hmcneill46/house-rules-led-recreation/hardware/quotes/jlcpcb/discount-research.md

# JLCPCB discount checks — 29 October 2026

Research for the unchanged A1 main and USB carrier boards, UK delivery. No purchase or account registration was made. Dollar amounts below are USD promotion face values, not a delivered GBP quote.

**Later authenticated check:** the installed official JLCONE app offered a **$30 High-Layer PCB coupon which expressly includes six layers**, with shipping over $5 and order over $5. It was claimed (expires 27 December 2026), and the unchanged two-each cart explicitly estimated **−$30**. This supersedes the $20 search-indexed candidate below. Prepaid-tax checkout was $304.58 before discounts; final coupon/tax application lies after Submit Order, so no order was submitted. See `jlcone-comparison.md` for exact conditions, evidence and VAT handling. The random app discount is still unconfirmed.

## Best candidates to compare in the actual checkout

| Candidate | Published terms / limitations | Verification status |
| --- | --- | --- |
| Six-layer PCB special | Official cross-brand coupon centre lists $20 off six-layer fabrication, order above $5 excluding freight, 60-day validity, selected countries. | Worth checking on the main board. Actual account, UK region, selected services and availability remain unverified. |
| JLCONE desktop price and instant discount | Official Windows/macOS app offers desktop prices and shipping routes plus a limited-time random $1–$20 discount per order. Announcement expressly permits that automatic discount together with **one** eligible coupon. | Strongest additional comparison to make. Exact board options, small-via charges, assembly, shipping and VAT must stay identical. No exact saving promised. |
| Monthly SMT coupons | $9 and $6 assembly coupons, each for orders above $1 excluding shipping. | Issued monthly; account availability and final-cart eligibility need checking. |
| New-customer coupons | Relevant parts of the advertised $123 mixed-service pack: $10 SMT (order above $2), $6 PCB (above $2), and $10 shipping (shipping above $15). | Only for an eligible genuine new customer; the whole $123 is not a discount on these boards. |

Sources: [official coupon centre](https://jlcpcb.com/coupon-center), [official JLCMC centre search-indexed offer](https://jlcmc.com/coupon-center), [JLCONE app FAQ, updated 22 September 2026](https://jlcpcb.com/help/article/jlcone-desktop-app), [JLCONE announcement and explicit stacking rule](https://jlcpcb.com/news/jlcpcb-jlcone-desktop-app), [new-customer and monthly coupon guide, updated 9 September 2026](https://jlcpcb.com/help/article/new-customer-coupons).

The extra monthly $10 PCBA coupon requires EasyEDA-exported files. These boards use KiCad, so it should not be included. “Free assembly” advertising refers to using an SMT coupon against setup; components, fabrication, shipping and tax remain chargeable. [Assembly promotion explanation](https://jlcpcb.com/news/free-assembly-1-6-layer-pcb-discount-8-20-layer-pcba).

## How to establish the cheapest genuine total

Use one frozen manufacturing specification for both websites/app and all quantity comparisons. Compare the final **delivered and taxed amount**, after selecting one actually eligible coupon. Check whether the main and carrier can share shipping without losing a larger discount. A second shipment to use another coupon only saves money if its full extra freight/tax is smaller than the saving. Do not assume two board jobs permit two coupons in one payment batch.

JLCPCB says coupons are service-specific and normally limited to **one coupon per order batch**. Eligibility appears after shipping information at checkout; multiple coupons cannot be added together. The documented JLCONE automatic instant discount is the relevant exception to ordinary coupon stacking. [Coupon-use rules](https://jlcpcb.com/help/article/how-do-i-use-a-coupon-for-my-order).

## YouTube/creator-code result

No current creator redemption code giving a verified better discount than the official account offers was established. Creator sponsorships commonly link to the same welcome bundle or six-layer promotion rather than provide an additional code. For example, [GreatScott!'s 19 May 2024 sponsored video](https://www.youtube.com/watch?v=gE_FuQuaKc0) advertises six-layer pricing and a coupon, but it does not establish present eligibility for this order. The [official six-layer landing page](https://jlcpcb.com/events/6-layer-pcb) is live; its public text does not establish a currently redeemable $30 coupon.

Searches also found aggregator strings such as `JLCPCB9Sky` and `JLCPCB2Sky`, but no first-party current validation. They are **not counted as savings**. A code is only confirmed when JLCPCB accepts it for this actual cart. Do not make duplicate accounts or submit false eligibility information.

## Expired/restricted offers excluded

- [SMT Star Member first-order campaign](https://jlcpcb.com/events/pcba-first-order): ended **30 August 2026**; no current saving counted.
- [Engineers' Day promotion](https://jlcpcb.com/news/celebrate-engineers-day): article concerns the **2024** event.
- [Black Friday page](https://jlcpcb.com/sales-promotion): **2025** page, not evidence of a 2026 entitlement.
- [Maker Faire Rome 2026](https://jlcpcb.com/events/rome-maker-fair): `MFR26-EE`, $30 off orders of at least $70, requires possession of the event PCB gadget. No evidence the user qualifies, so excluded.

## Why the main board can exceed the advertised six-layer headline price

The frozen main board uses 0.20 mm drill / 0.40 mm copper-diameter vias. JLCPCB's live quote help identifies that exact combination as chargeable small vias. The free multilayer 0.20 mm option needs at least 0.45 mm copper diameter. Free VIPPO does not imply the small-via surcharge disappears. A 0.30 mm drill inside the existing 0.40 mm copper would reduce the annular ring and is a design change, not a valid quoting shortcut. [Official quote specification help](https://cart.jlcpcb.com/quote/?fromDemo=yes).

Use the exact fabrication/assembly result from the quoting task to determine the actual 1-each and 3-each minimum payable totals. The public promotions alone cannot provide those totals.
