hmcneill46/house-rules-led-recreation/hardware/manufacturing/A1_review/main/reports/drill-report.txt

Drill report for house-rules-main.kicad_pcb
Created on 2026-10-29T14:06:45

Copper Layer Stackup:
    =============================================================
    L1 :  F.Cu                      front
    L2 :  In1.Cu                    in1
    L3 :  In2.Cu                    in2
    L4 :  In3.Cu                    in3
    L5 :  In4.Cu                    in4
    L6 :  B.Cu                      back

Drill file 'house-rules-main-PTH.drl' contains
    plated through holes:
    =============================================================
    T1  0.200mm  0.0079"  (192 holes))
    T2  0.900mm  0.0354"  (84 holes))

    Total plated holes count 276

Drill file 'house-rules-main-NPTH.drl' contains
    unplated through holes:
    =============================================================

    Total unplated holes count 0
