hmcneill46/house-rules-led-recreation/hardware/manufacturing/A1_review/usb/reports/drill-report.txt

Drill report for house-rules-usb.kicad_pcb
Created on 2026-10-29T14:06:54

Copper Layer Stackup:
    =============================================================
    L1 :  F.Cu                      front
    L2 :  In1.Cu                    in1
    L3 :  In2.Cu                    in2
    L4 :  B.Cu                      back

Drill file 'house-rules-usb-PTH.drl' contains
    plated through holes:
    =============================================================
    T1  0.200mm  0.0079"  (10 holes))
    T2  0.600mm  0.0236"  (4 holes)  (with 4 slots)

    Total plated holes count 14

Drill file 'house-rules-usb-NPTH.drl' contains
    unplated through holes:
    =============================================================
    T1  0.650mm  0.0256"  (2 holes))

    Total unplated holes count 2
