hmcneill46/house-rules-led-recreation/hardware/revisions/B2/manufacturing/B2_F_TLC59283_7p15k_review_2026-10-31/reports/native-drill-report.txt

Drill report for house-rules-main-B2.kicad_pcb
Created on 2026-10-31T23:30:06

Copper Layer Stackup:
    =============================================================
    L1 :  F.Cu                      front
    L2 :  In1.Cu                    in1
    L3 :  In2.Cu                    in2
    L4 :  In3.Cu                    in3
    L5 :  In4.Cu                    in4
    L6 :  B.Cu                      back

Drill file 'house-rules-main-B2-PTH.drl' contains
    plated through holes:
    =============================================================
    T1  0.300mm  0.0118"  (276 holes))
    T2  0.900mm  0.0354"  (84 holes))

    Total plated holes count 360

Drill file 'house-rules-main-B2-NPTH.drl' contains
    unplated through holes:
    =============================================================

    Total unplated holes count 0
