hmcneill46/house-rules-led-recreation/hardware/quotes/2026-10-29/evidence/five-each-ddp-summary.txt

2. Shipping Method
CPT (Carriage paid to a named destination. Duty, tax, and the carrier’s clearance handling fee collected before or at the time of delivery at the destination.)
DHL Express
2-4 business days
Details >

UPS Worldwide Express Saver
2-5 business days
Details >

FedEx Express
3-5 business days
Details >

Global Standard Direct Line
8-12 business days
Details >

DDP (Customs fee paid by JLC, customers still need to cooperate with customs clearance if required by local customs)
DHL Express (DDP)
2-4 business days

FCA (Freight, customs clearance, taxes and duties are buyer's responsibility)
Use My own Freight Account

3. Submit Order

SUMMARY
4 items >
Merchandise Total
$258.80
Shipping Estimate
$25.66
Customs duties & taxes
$56.90
Duty & Tax Disbursement Fee
$8.27
Discount
--

Apply coupons in the payment section

Grand Total
$349.63
Continue

Need some help? Explore our help pages or contact us

© 2026 JLCPCB.COM All Rights Reserved. Privacy Policy Terms & Conditions
