hmcneill46/house-rules-led-recreation/hardware/design/module-connections.csv

module | module_pin | polarity | visual_axis_index_1based | driver | driver_signal | driver_package_pin
1 | 1 | anode | 1 | 1 | SW1 | 22
1 | 3 | anode | 2 | 1 | SW2 | 21
1 | 10 | anode | 3 | 1 | SW3 | 20
1 | 7 | anode | 4 | 1 | SW4 | 19
1 | 8 | anode | 5 | 1 | SW5 | 18
1 | 12 | cathode | 1 | 1 | CS1 | 30
1 | 11 | cathode | 2 | 1 | CS2 | 31
1 | 2 | cathode | 3 | 1 | CS3 | 32
1 | 9 | cathode | 4 | 1 | CS4 | 1
1 | 4 | cathode | 5 | 1 | CS5 | 2
1 | 5 | cathode | 6 | 1 | CS6 | 3
1 | 6 | cathode | 7 | 1 | CS7 | 4
2 | 1 | anode | 1 | 1 | SW1 | 22
2 | 3 | anode | 2 | 1 | SW2 | 21
2 | 10 | anode | 3 | 1 | SW3 | 20
2 | 7 | anode | 4 | 1 | SW4 | 19
2 | 8 | anode | 5 | 1 | SW5 | 18
2 | 12 | cathode | 1 | 1 | CS8 | 5
2 | 11 | cathode | 2 | 1 | CS9 | 6
2 | 2 | cathode | 3 | 1 | CS10 | 7
2 | 9 | cathode | 4 | 1 | CS11 | 8
2 | 4 | cathode | 5 | 1 | CS12 | 10
2 | 5 | cathode | 6 | 1 | CS13 | 11
2 | 6 | cathode | 7 | 1 | CS14 | 12
3 | 1 | anode | 1 | 2 | SW1 | 22
3 | 3 | anode | 2 | 2 | SW2 | 21
3 | 10 | anode | 3 | 2 | SW3 | 20
3 | 7 | anode | 4 | 2 | SW4 | 19
3 | 8 | anode | 5 | 2 | SW5 | 18
3 | 12 | cathode | 1 | 2 | CS1 | 30
3 | 11 | cathode | 2 | 2 | CS2 | 31
3 | 2 | cathode | 3 | 2 | CS3 | 32
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
