hmcneill46/house-rules-led-recreation/hardware/design/pixel-map.csv

x_0based | y_0based | module_1based | driver_1based | i2c_7bit_address | SW_1based | CS_1based | PWM_register
0 | 0 | 1 | 1 | 0x34 | 1 | 1 | 0x01
0 | 1 | 1 | 1 | 0x34 | 1 | 2 | 0x02
0 | 2 | 1 | 1 | 0x34 | 1 | 3 | 0x03
0 | 3 | 1 | 1 | 0x34 | 1 | 4 | 0x04
0 | 4 | 1 | 1 | 0x34 | 1 | 5 | 0x05
0 | 5 | 1 | 1 | 0x34 | 1 | 6 | 0x06
0 | 6 | 1 | 1 | 0x34 | 1 | 7 | 0x07
1 | 0 | 1 | 1 | 0x34 | 2 | 1 | 0x11
1 | 1 | 1 | 1 | 0x34 | 2 | 2 | 0x12
1 | 2 | 1 | 1 | 0x34 | 2 | 3 | 0x13
1 | 3 | 1 | 1 | 0x34 | 2 | 4 | 0x14
1 | 4 | 1 | 1 | 0x34 | 2 | 5 | 0x15
1 | 5 | 1 | 1 | 0x34 | 2 | 6 | 0x16
1 | 6 | 1 | 1 | 0x34 | 2 | 7 | 0x17
2 | 0 | 1 | 1 | 0x34 | 3 | 1 | 0x21
2 | 1 | 1 | 1 | 0x34 | 3 | 2 | 0x22
2 | 2 | 1 | 1 | 0x34 | 3 | 3 | 0x23
2 | 3 | 1 | 1 | 0x34 | 3 | 4 | 0x24
2 | 4 | 1 | 1 | 0x34 | 3 | 5 | 0x25
2 | 5 | 1 | 1 | 0x34 | 3 | 6 | 0x26
2 | 6 | 1 | 1 | 0x34 | 3 | 7 | 0x27
3 | 0 | 1 | 1 | 0x34 | 4 | 1 | 0x31
3 | 1 | 1 | 1 | 0x34 | 4 | 2 | 0x32
3 | 2 | 1 | 1 | 0x34 | 4 | 3 | 0x33
3 | 3 | 1 | 1 | 0x34 | 4 | 4 | 0x34
3 | 4 | 1 | 1 | 0x34 | 4 | 5 | 0x35
3 | 5 | 1 | 1 | 0x34 | 4 | 6 | 0x36
3 | 6 | 1 | 1 | 0x34 | 4 | 7 | 0x37
4 | 0 | 1 | 1 | 0x34 | 5 | 1 | 0x41
4 | 1 | 1 | 1 | 0x34 | 5 | 2 | 0x42
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
