hmcneill46/house-rules-led-recreation/hardware/revisions/B2/mechanical/archive-12p700-2026-10-29/README.md

# Historical 12.700 mm case geometry

These source and STL snapshots preserve the original B2 case before the owner selected the 12.875 mm F fitting trial on 31 October 2026. They are reference artifacts; use the current mechanical source and the new confirmed-F print pack for the revised 89.450 mm PCB. The old sliced print pack also remains unchanged in `../../printing/`.
