hmcneill46/house-rules-led-recreation/hardware/design/physical-concept.png

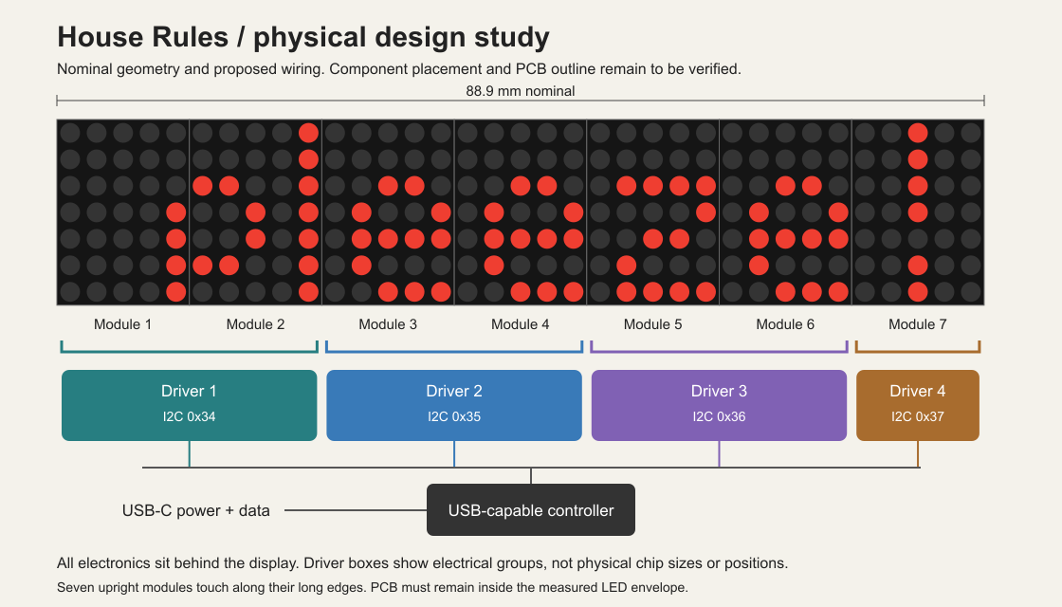
hardware/design/physical-concept.png
