hmcneill46/house-rules-led-recreation/hardware/quotes/2026-10-29/evidence/five-each-ddp-summary.jpg

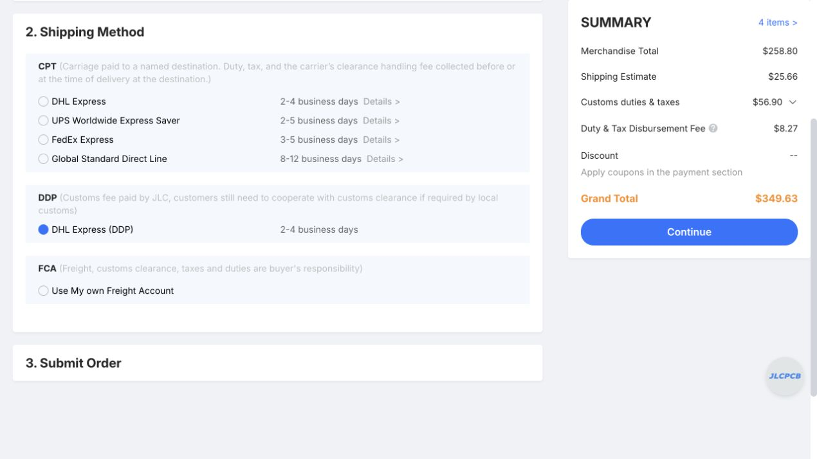
hardware/quotes/2026-10-29/evidence/five-each-ddp-summary.jpg
