hmcneill46/house-rules-led-recreation/hardware/quotes/2026-10-29/evidence/main-2-only-global-summary.jpg

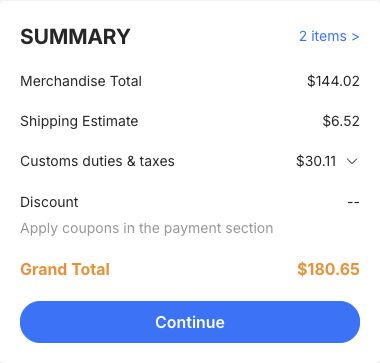
hardware/quotes/2026-10-29/evidence/main-2-only-global-summary.jpg
