hmcneill46/house-rules-led-recreation/hardware/quotes/2026-10-29/evidence/main-economic-2-cart.jpg

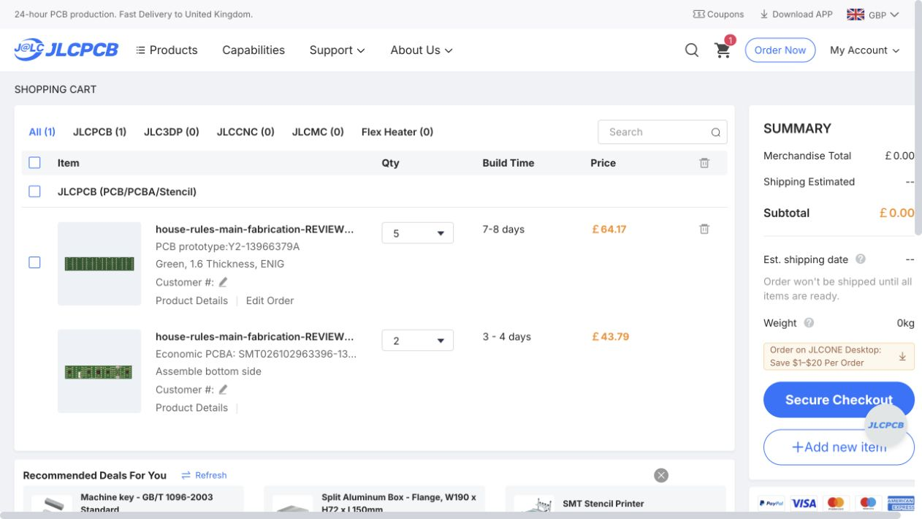
hardware/quotes/2026-10-29/evidence/main-economic-2-cart.jpg
