hmcneill46/house-rules-led-recreation/hardware/quotes/2026-10-29/evidence/usb-060-stock.jpg

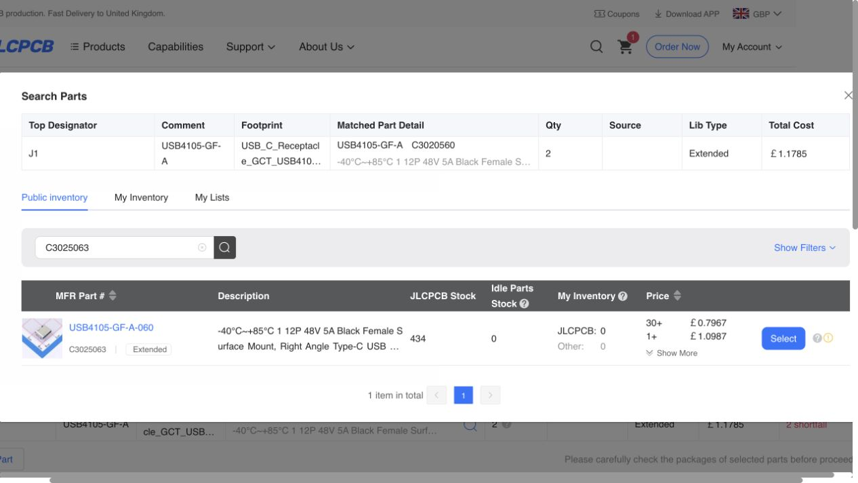
hardware/quotes/2026-10-29/evidence/usb-060-stock.jpg
