hmcneill46/house-rules-led-recreation/hardware/quotes/2026-10-29/evidence/usb-economic-5-120.jpg

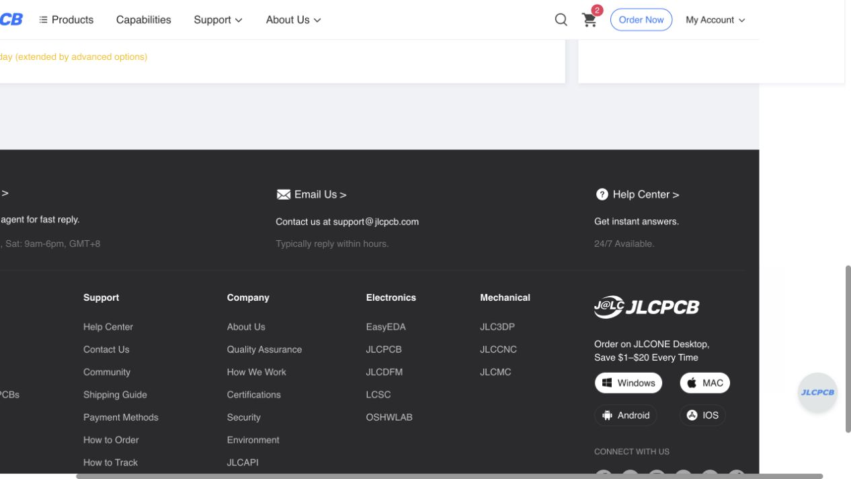
hardware/quotes/2026-10-29/evidence/usb-economic-5-120.jpg
