hmcneill46/house-rules-led-recreation/hardware/quotes/jlcpcb/jlcone-2-each-cart-coupon30-2026-10-29.png

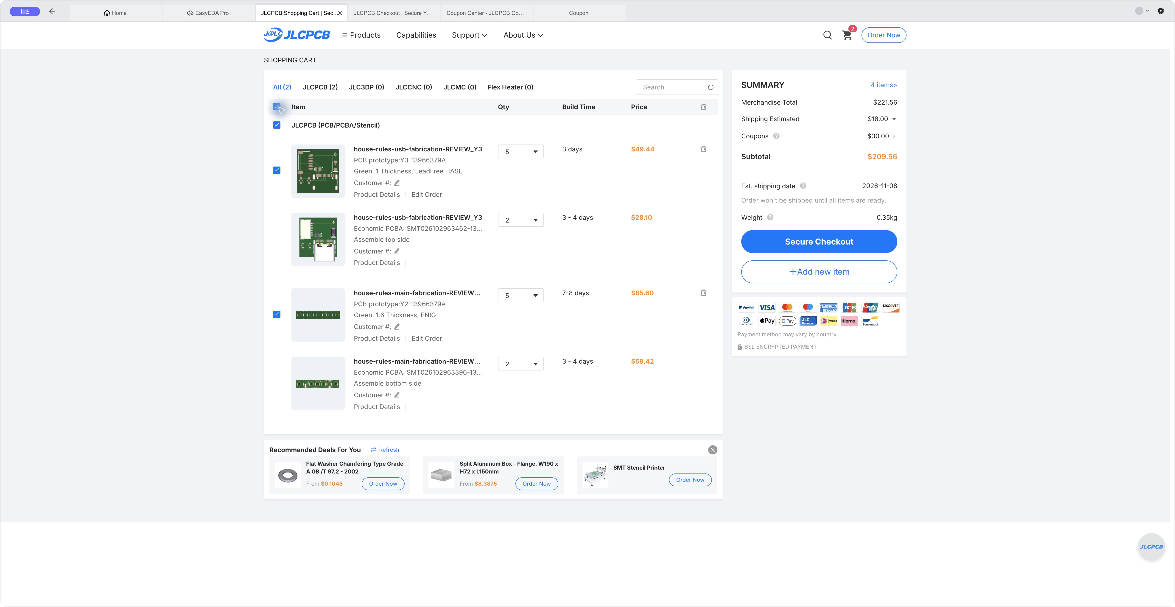
hardware/quotes/jlcpcb/jlcone-2-each-cart-coupon30-2026-10-29.png
