hmcneill46/house-rules-led-recreation/hardware/quotes/jlcpcb/jlcone-5-each-ddp-summary-2026-10-29.png

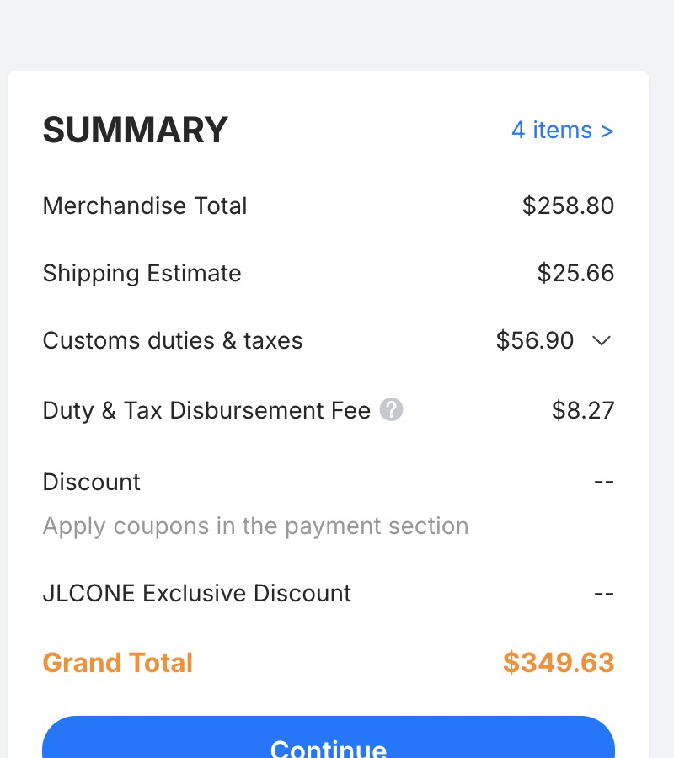
hardware/quotes/jlcpcb/jlcone-5-each-ddp-summary-2026-10-29.png
