hmcneill46/house-rules-led-recreation/hardware/quotes/jlcpcb/jlcone-coupon-wallet-2026-10-29.png

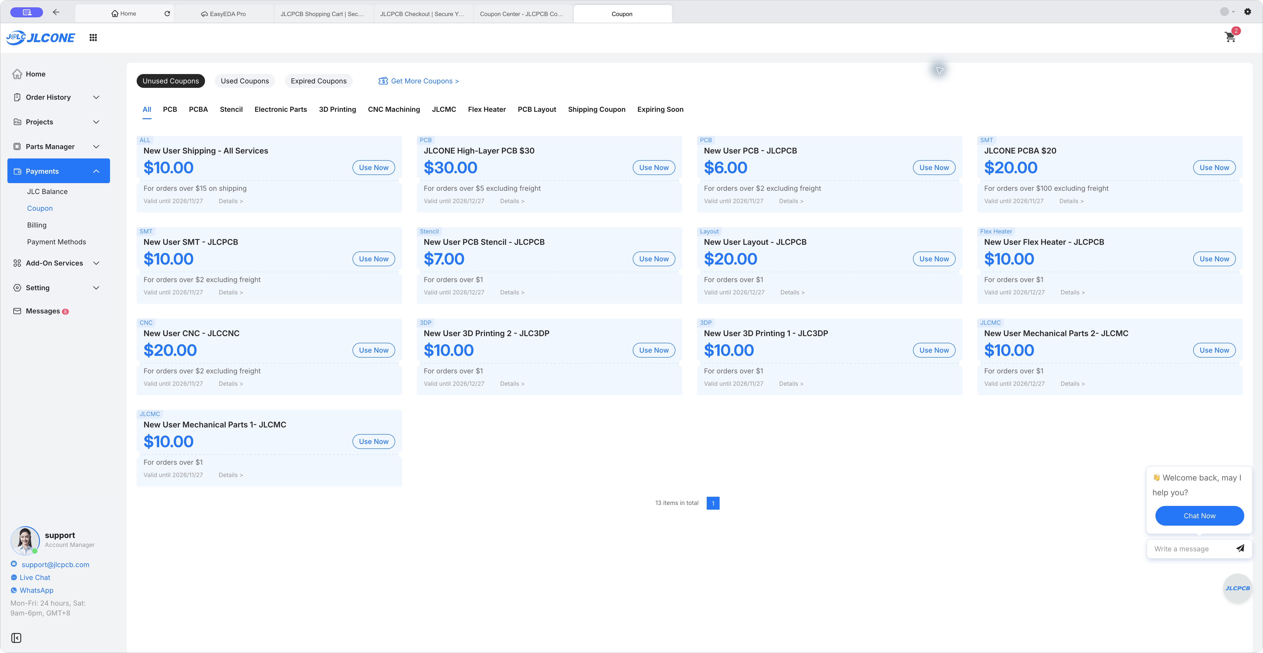
hardware/quotes/jlcpcb/jlcone-coupon-wallet-2026-10-29.png
