hmcneill46/house-rules-led-recreation/hardware/render/design-summary-preview.png

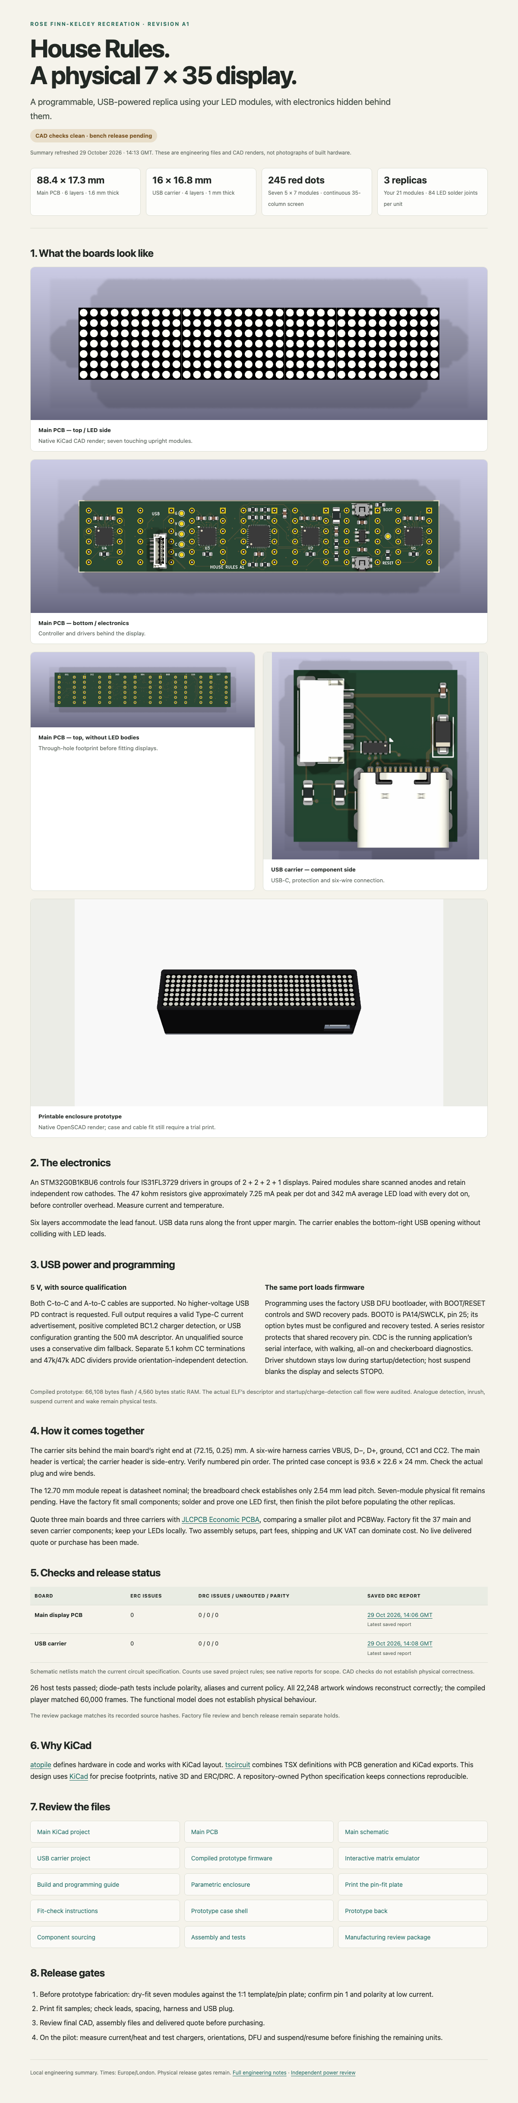
hardware/render/design-summary-preview.png
