hmcneill46/house-rules-led-recreation/hardware/render/drill-maps/main-pth.png

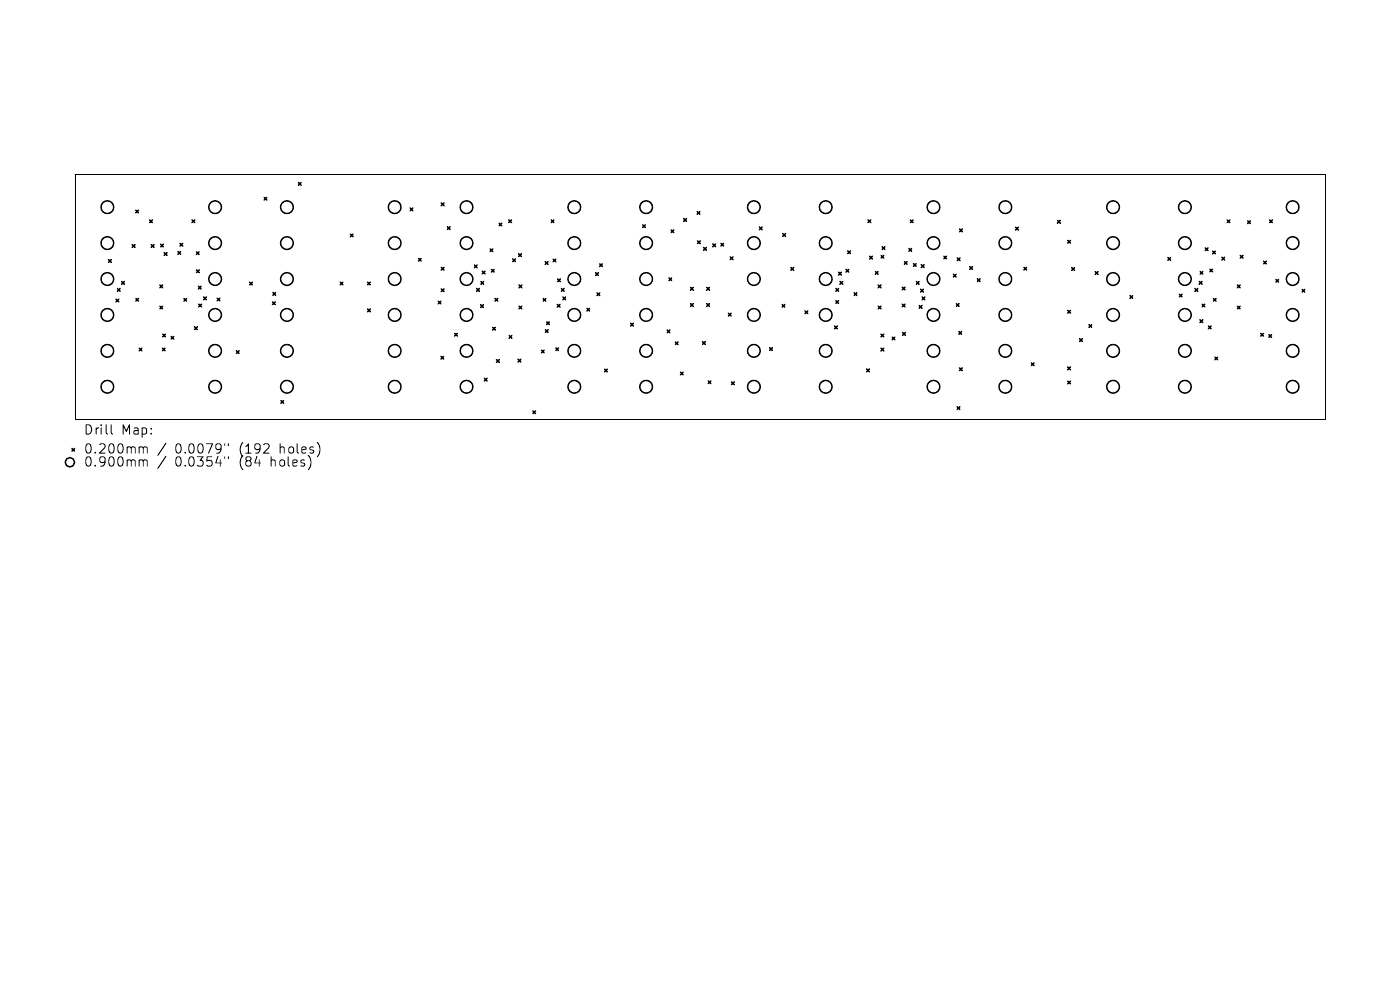
hardware/render/drill-maps/main-pth.png
