hmcneill46/house-rules-led-recreation/hardware/render/drill-maps/usb-pth.png

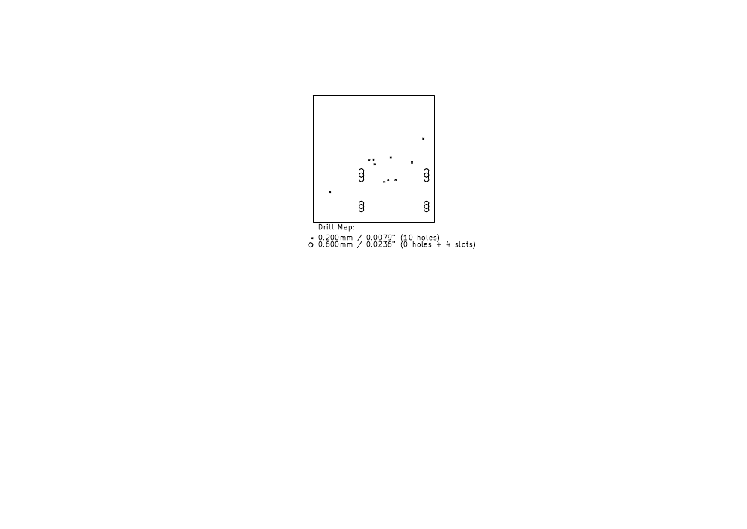
hardware/render/drill-maps/usb-pth.png
