hmcneill46/house-rules-led-recreation/hardware/render/enclosure-PROTOTYPE-back.png

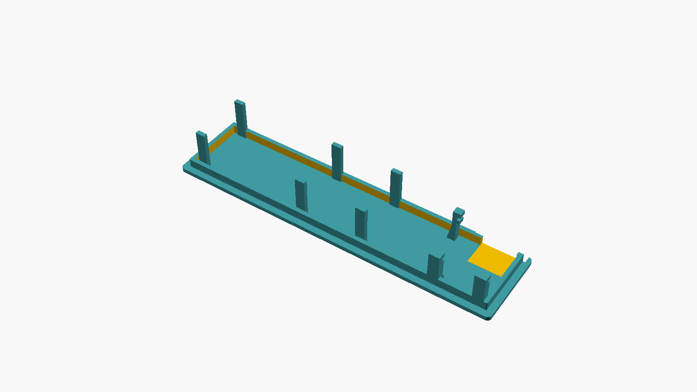
hardware/render/enclosure-PROTOTYPE-back.png
