hmcneill46/house-rules-led-recreation/hardware/render/main-edge.png

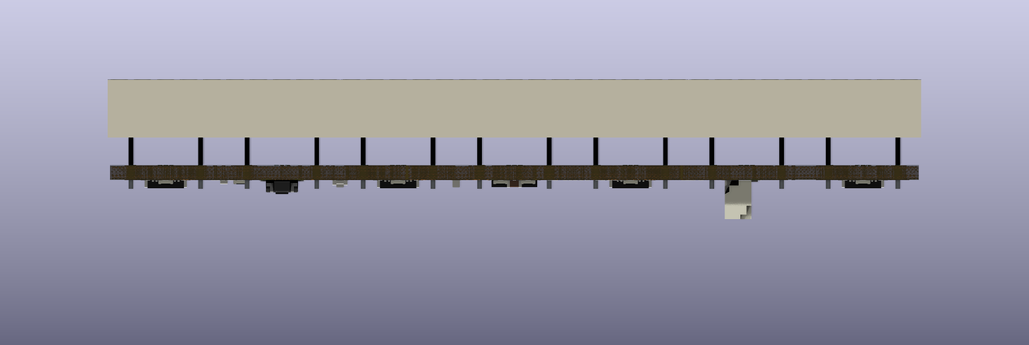
hardware/render/main-edge.png
