hmcneill46/house-rules-led-recreation/hardware/render/main-placement-bottom.png

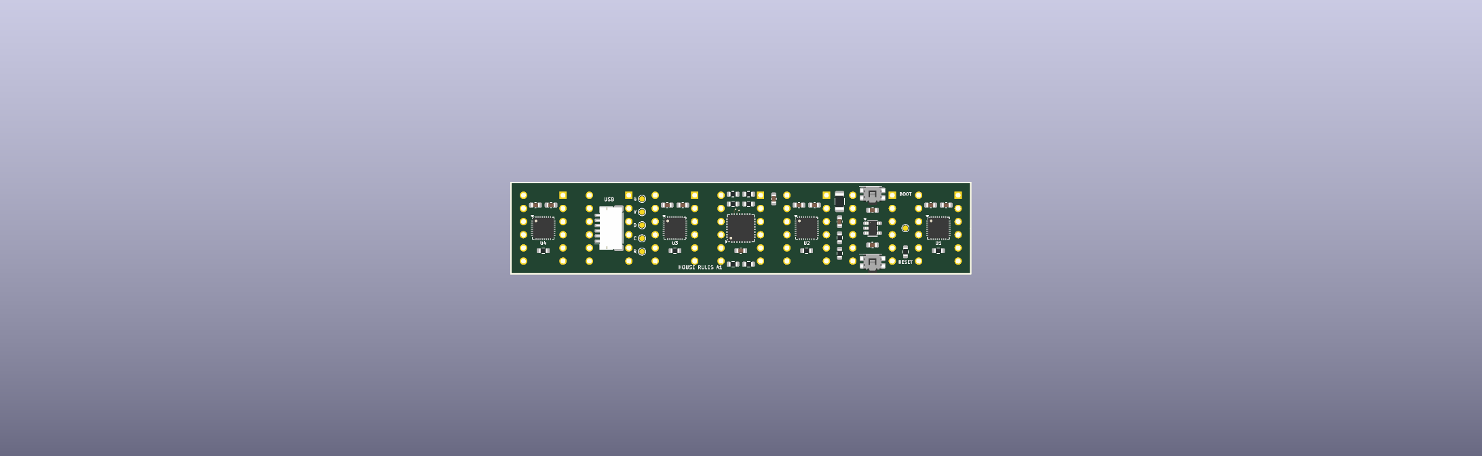
hardware/render/main-placement-bottom.png
