hmcneill46/house-rules-led-recreation/hardware/render/main-review-top.png

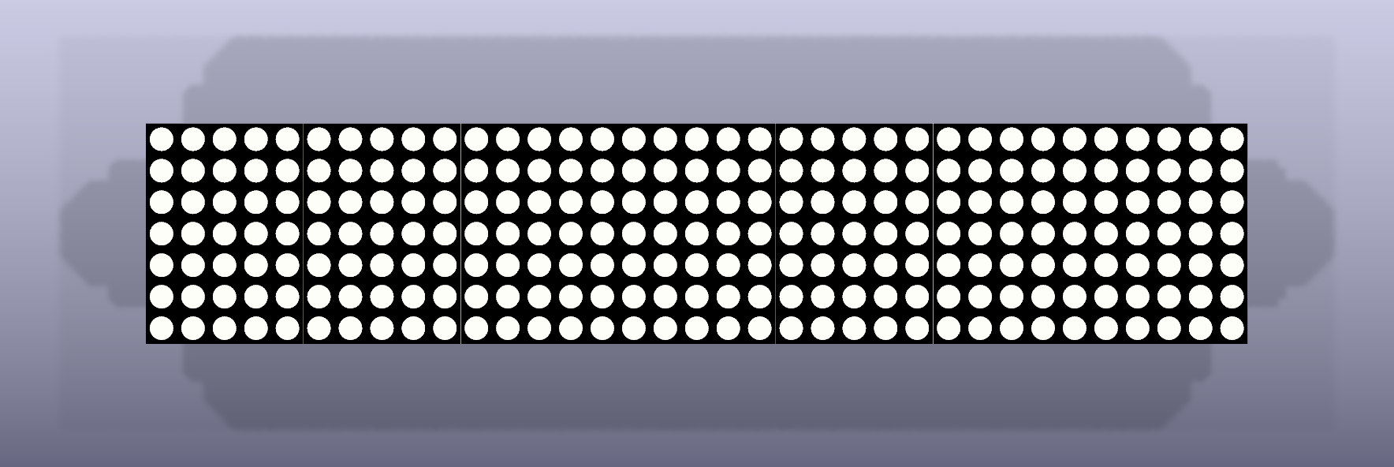
hardware/render/main-review-top.png
