hmcneill46/house-rules-led-recreation/hardware/render/usb-bottom.png

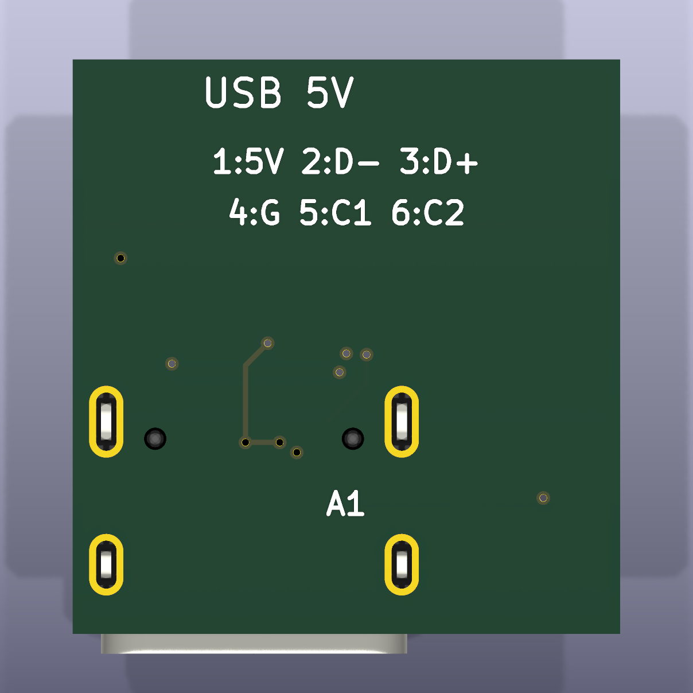
hardware/render/usb-bottom.png
