hmcneill46/house-rules-led-recreation/hardware/render/usb-isometric.png

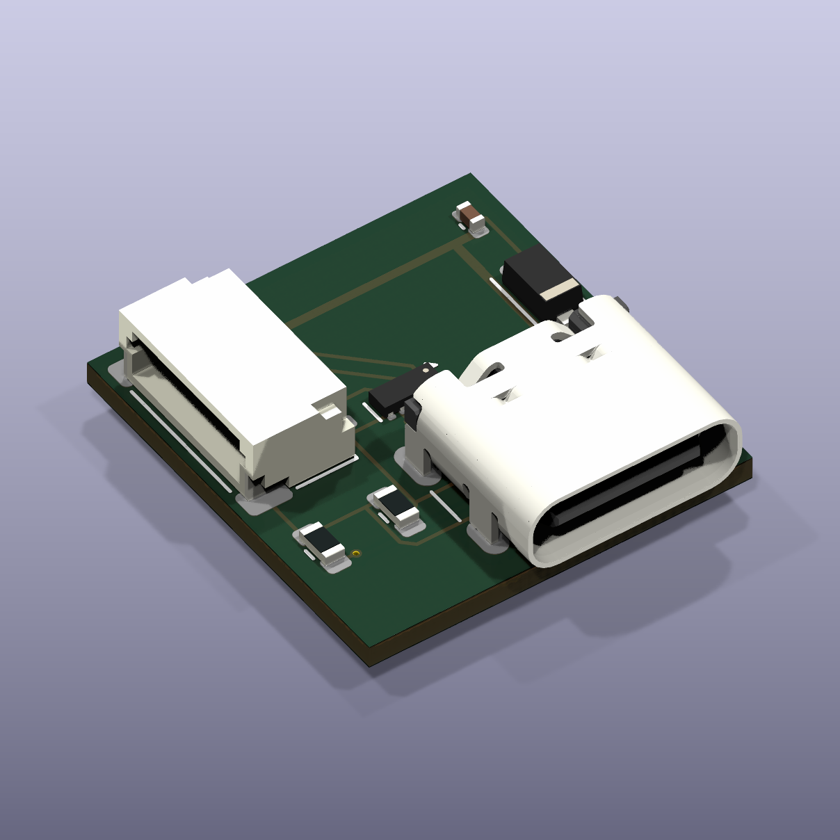
hardware/render/usb-isometric.png
