hmcneill46/house-rules-led-recreation/hardware/render/usb-placement-top.png

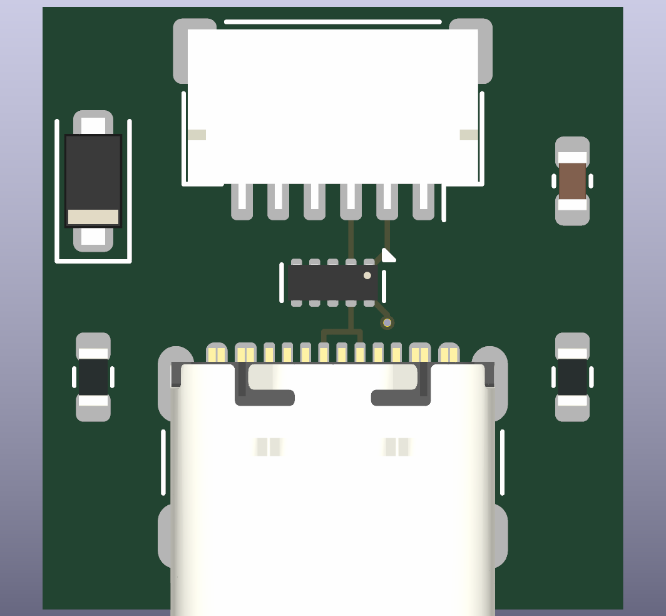
hardware/render/usb-placement-top.png
