hmcneill46/house-rules-led-recreation/hardware/revisions/B2/mechanical/render/section.png

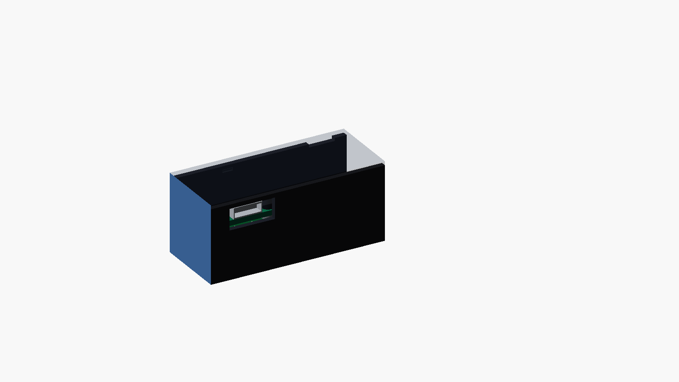
hardware/revisions/B2/mechanical/render/section.png
