hmcneill46/house-rules-led-recreation/hardware/simulation/emulator-preview.png

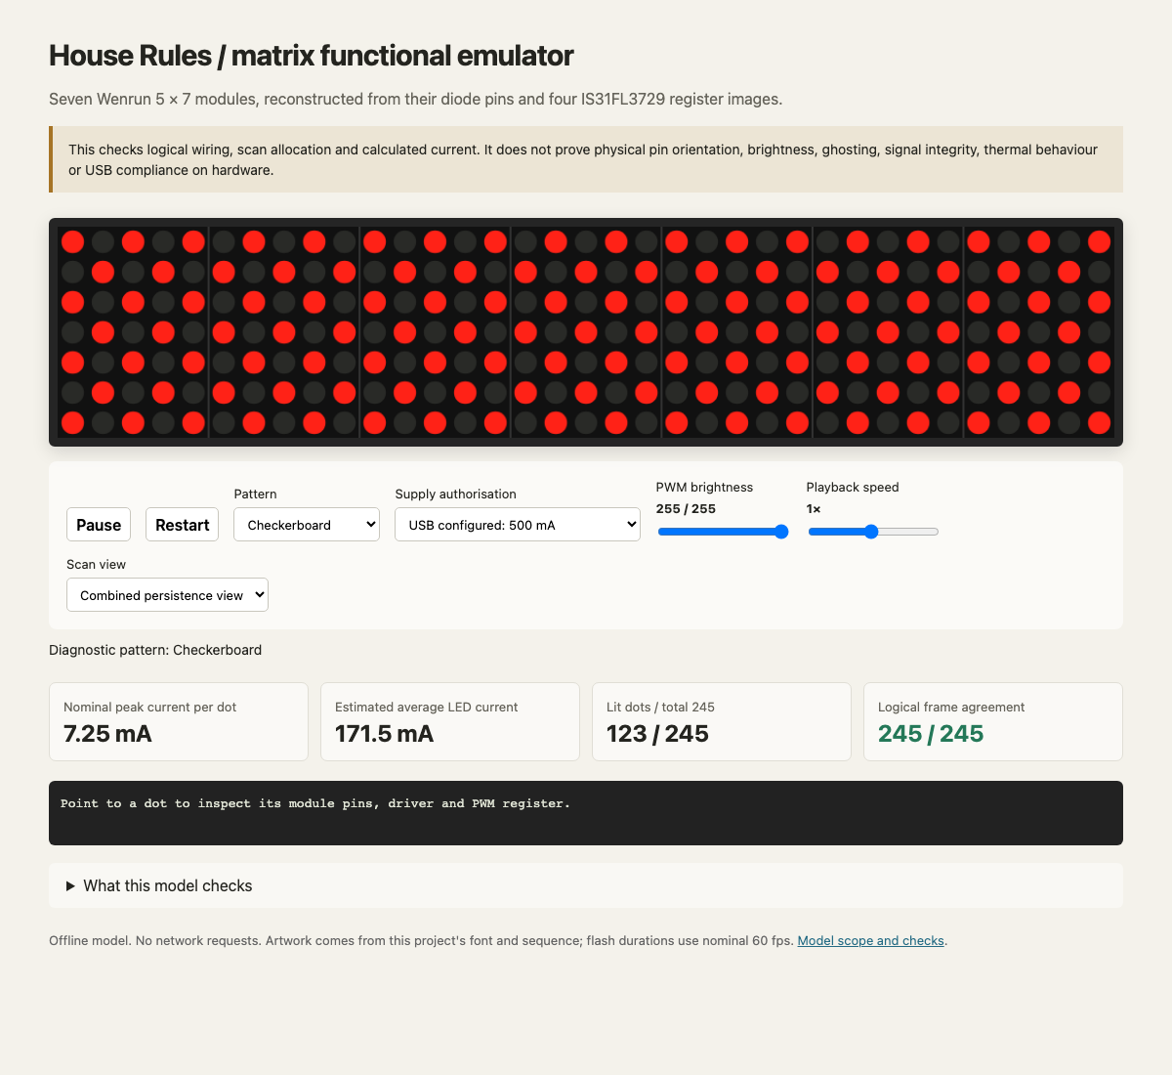
hardware/simulation/emulator-preview.png
