hmcneill46/house-rules-led-recreation/Original Artwork/2002.017.P.jpg

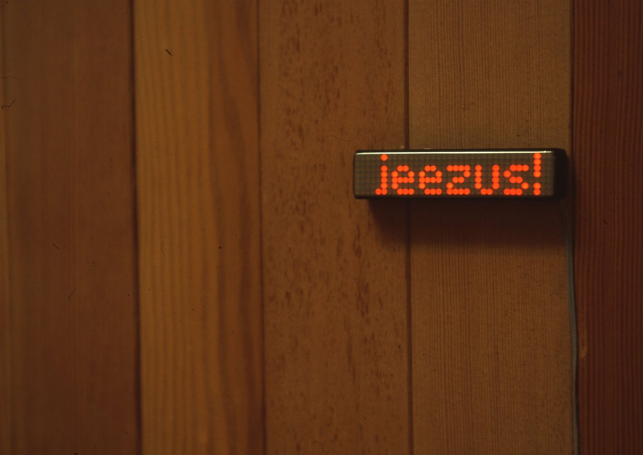
Original Artwork/2002.017.P.jpg
