hmcneill46/house-rules-led-recreation/Original Artwork/64629602c1bd8f5050fa9ef3.jpg

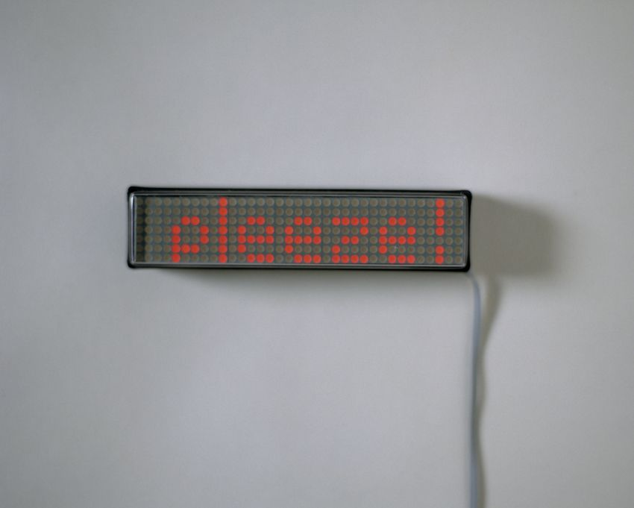
Original Artwork/64629602c1bd8f5050fa9ef3.jpg
