hmcneill46/house-rules-led-recreation/Original Artwork/image.png

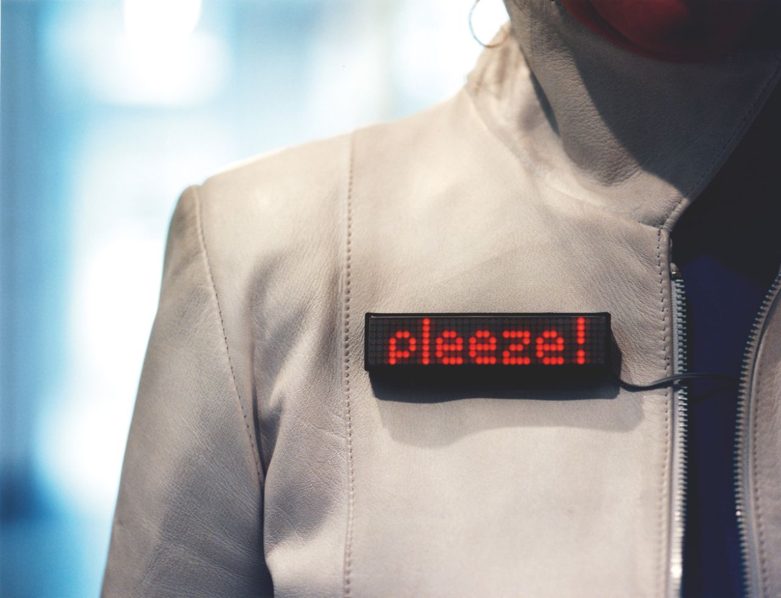
Original Artwork/image.png
