hmcneill46/house-rules-led-recreation/Original Artwork/rosefinnkelcey_feed_20170611201725.JPG

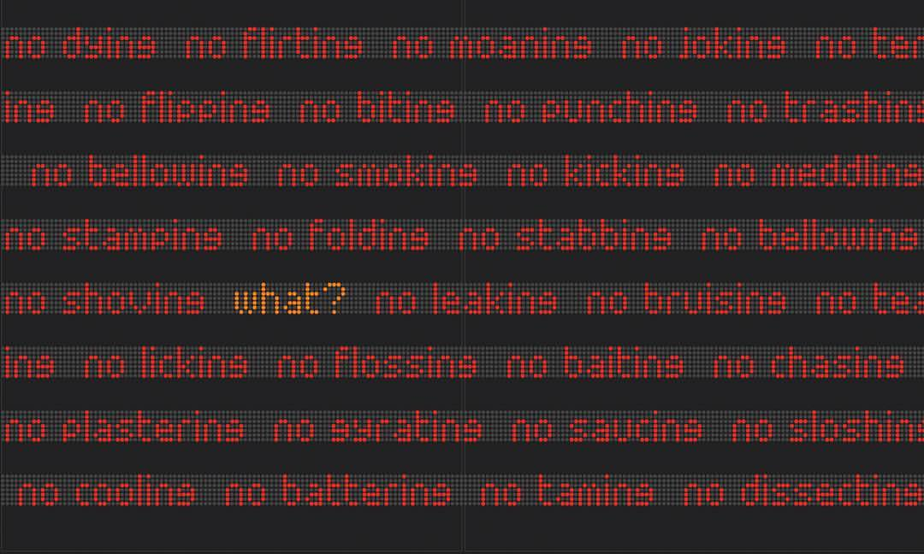
Original Artwork/rosefinnkelcey_feed_20170611201725.JPG
