hmcneill46/house-rules-led-recreation/hardware/revisions/B2/manufacturing/DO-NOT-ORDER-current-B2.txt

31 October 2026: TLC59283/7.15k REVIEW PACKAGE; NO ORDER RELEASE

CURRENT REVIEW: B2_F_TLC59283_7p15k_review_2026-10-31/
U1-U4 = TLC59283RGER/C485815.
R1-R4 =7.15kohm,0603WAF7151T5E/C25980.
The PCB remains89.45x17.30mm at owner-selected12.875mm pitch.
Fresh ERC/DRC/parity, pin/process/actual-export, firmware and mechanical checks
pass. Copper, pads, drills, placement and case/print geometry are unchanged.

HISTORICAL: B2_F_12p875_review_2026-10-31/ usesTLC59282/6.8k.
B2_review/ also uses the older88.40mm /12.700mm-pitch geometry.
Do not order either old package or combine old BOMs with the new revision.

The owner has NOT completed the full case print/stock-module/USB-plug dryfit.
Before ordering: finish that check; refresh the coherent-package quote/stock;
obtain factoryCAM/pin1/rotation review, removable outside tooling rails,
filled/capped0.30mmvias and84open0.90mmLEDholes.
First-board precharge/rail transitions/current/USB/optical/temperature acceptance
requires powered measurements; static PASS does not establish those results.
No order, payment or printer execution. Selected plan is three displays plus
extra screws/wire, with five assembled mains and two left as populated spares.
See ../reports/TLC59283-2026-10-31/README.md and selected-purchase-plan.json.
