hmcneill46/house-rules-led-recreation/hardware/revisions/B2/quotes/cost-study-2026-10-29/4L/README-DO-NOT-ORDER.txt

UNROUTED COST STUDY ONLY. DO NOT ORDER OR MANUFACTURE. This is an incomplete placement used only to estimate costs. It has not passed connectivity DRC. Board outline/stack/part count are actual candidate values. Final routing/drill count/rotations/process must be re-exported and reviewed before production.
