hmcneill46/house-rules-led-recreation/hardware/revisions/B2/quotes/cost-study-basic-iref-2026-10-29/6L/README-DO-NOT-ORDER.txt

UNRELEASED COST STUDY ONLY. DO NOT ORDER OR MANUFACTURE. This quotation input is not a production release. The board may be incompletely routed; native placement rotations have not received factory review. Re-export and re-quote the approved, fully verified board before ordering.
