hmcneill46/house-rules-led-recreation/hardware/reports/component-sourcing.csv

function | manufacturer | part_number | LCSC_part | package | KiCad_footprint_candidate | 3D_model | quantity_per_replica | listing_stock_returned | listing_USD_unit_price | minimum_purchase_qty | verification_status | source_url | notes
LED module | Wenrun | LMD07057AUE-101B | owned | 12-pin THT | custom, physical fit and pin orientation pending | custom | 7 | owned 21 |  | 0 | Supplier documentation and user photos | https://www.switchelectronics.co.uk/products/red-5-x-7-dot-matrix-led-display-17-8x12-7mm | Do not send owned LEDs overseas; solder after PCBA
LED driver | Lumissil | IS31FL3729-QFLS4-TR | C2940549 | QFN32 4x4mm | custom land pattern review required | manufacturer/verified custom | 4 | 2644 (prior research result) | 1.1957 | 1 | LCSC listing; JLC live assembly stock unverified | https://www.lcsc.com/product-detail/C2940549.html | Two modules per chip except final chip; use exact manufacturer part
Controller | STMicroelectronics | STM32G0B1KBU6 | C5159549 | UFQFPN32 5x5mm | Package_DFN_QFN:QFN-32-1EP_5x5mm_P0.5mm_EP3.45x3.45mm | KiCad10 QFN-32-1EP_5x5mm_P0.5mm_EP3.45x3.45mm.step | 1 | 431 | 3.7817 | 1 | Indexed LCSC listing; JLC live assembly stock unverified | https://lcsc.com/product-detail/Microcontrollers-MCU-MPU-SOC_STMicroelectronics-STM32G0B1KBU6_C5159549.html | GP package; do not substitute N suffix without schematic revision
3V3 regulator | Texas Instruments | TLV75533PDBVR | C404027 | SOT23-5 | Package_TO_SOT_SMD:SOT-23-5 | KiCad10 SOT-23-5.step | 1 | 1225 | 0.2149 | 5 | Indexed LCSC listing; JLC Economic and Standard listing verified | https://lcsc.com/product-detail/Low-Dropout-Regulators-LDO_Texas-Instruments-TI-TLV75533PDBVR_C404027.html | Pin1 IN 2GND 3EN 4NC 5OUT; 1uF input and 2.2uF output
USB/CC ESD protection | Texas Instruments | TPD4E05U06DQAR | C138714 | USON10 2.5x1.0mm | Package_SON:USON-10_2.5x1.0mm_P0.5mm | KiCad10 Package_SON.3dshapes/USON-10_2.5x1.0mm_P0.5mm.step | 1 | 130230 | 0.0847 | 5 | Indexed LCSC listing; JLC Economic and Standard listing verified | https://www.lcsc.com/product-detail/TVS_TI_TPD4E05U06DQAR_TPD4E05U06DQAR_C138714.html | Channels pins1/2/4/5; GND3/8; NC6/7/9/10 are not internally connected to channels
USB-C receptacle | Global Connector Technology | USB4105-GF-A | C3020560 | 16-contact top-mount horizontal | Connector_USB:USB_C_Receptacle_GCT_USB4105-xx-A_16P_TopMnt_Horizontal | KiCad10 Connector_USB.3dshapes/USB_C_Receptacle_GCT_USB4105-xx-A_16P_TopMnt_Horizontal.step | 1 | 774 | 1.0342 | 1 | Indexed LCSC listing; JLC live assembly stock unverified | https://lcsc.com/product-detail/USB-Connectors_Global-Connector-Technology-USB4105-GF-A_C3020560.html | On recessed USB carrier; inspect shell tabs/body and case opening
Board-to-wire socket | JST | SM06B-SRSS-TB(LF)(SN) | C160405 | SH 6-way 1mm horizontal SMD | Connector_JST:JST_SH_SM06B-SRSS-TB_1x06-1MP_P1.00mm_Horizontal | KiCad10 Connector_JST.3dshapes/JST_SH_SM06B-SRSS-TB_1x06-1MP_P1.00mm_Horizontal.step | 1 | 3345 | 0.2985 | 5 | Indexed LCSC listing; JLC live assembly stock unverified | https://lcsc.com/product-detail/Wire-To-Board-Connector_JST-SM06B-SRSS-TB-LF-SN_C160405.html | USB carrier only; main now uses vertical BM06B-SRSS-TB. Need separately supplied 6-wire pin1-to-pin1 harness; verify continuity and mating-body clearance. Cable must use plain SHR-06V-S mating housings at both ends; wider SHR-06V-S-B is outside reviewed mechanical envelope.
Resettable fuse | Brightking | SMD1206B075TF/16 | C269118 | 1206, body3.4x1.8mm, height1.6mm | Fuse:Fuse_1206_3216Metric | KiCad10 Fuse.3dshapes/Fuse_1206_3216Metric.step (generic; check actual height) | 1 | 29440 | 0.0463 | 10 | Indexed LCSC listing; JLC live assembly stock unverified | https://www.lcsc.com/product-detail/Resettable-Fuses_Brightking-SMD1206B075TF-16_C269118.html | 750mA hold 1.5A trip; derating and voltage drop need thermal check
VBUS transient suppressor | Littelfuse | SMF5.0A | C151296 | SOD123FL | Diode_SMD:D_SOD-123F | KiCad10 Diode_SMD.3dshapes/D_SOD-123F.step | 1 | 5985 | 0.1002 | 5 | Indexed LCSC listing; JLC live assembly stock unverified | https://lcsc.com/product-detail/TVS_Littelfuse_SMF5-0A_Littelfuse-SMF5-0A_C151296.html | Cathode to VBUS and anode to ground; transient protection, not sustained overvoltage protection
Resistor 47k 1% | UNI-ROYAL | 0603WAF4702T5E | C25819 | 0603 | Resistor_SMD:R_0603_1608Metric | KiCad10 bundled generic model; footprint/package verified | 8 |  |  |  | Basic; Primary JLC part identity, value, package and assembly class checked; stock/prices are indexed public observations, not a live reserved cart. | https://jlcpcb.com/partdetail/0603WAF4702T5E/C25819
Resistor 2k2 1% | UNI-ROYAL | 0603WAF2201T5E | C4190 | 0603 | Resistor_SMD:R_0603_1608Metric | KiCad10 bundled generic model; footprint/package verified | 3 | 6188700 (indexed LCSC) | 0.0017 at 100+ | 100 | Basic; Primary JLC part identity, value, package and assembly class checked; stock/prices are indexed public observations, not a live reserved cart. | https://jlcpcb.com/partdetail/0603WAF2201T5E/C4190
Resistor 100k 1% | UNI-ROYAL | 0603WAF1003T5E | C25803 | 0603 | Resistor_SMD:R_0603_1608Metric | KiCad10 bundled generic model; footprint/package verified | 1 | 17537500 (indexed LCSC) | 0.0042 at 100+ | 100 | Basic; Primary JLC part identity, value, package and assembly class checked; stock/prices are indexed public observations, not a live reserved cart. | https://jlcpcb.com/partdetail/0603WAF1003T5E/C25803
Resistor 10k 1% | UNI-ROYAL | 0603WAF1002T5E | C25804 | 0603 | Resistor_SMD:R_0603_1608Metric | KiCad10 bundled generic model; footprint/package verified | 2 | 20417600 (indexed LCSC) | 0.0010 at 100+ | 100 | Basic; Primary JLC part identity, value, package and assembly class checked; stock/prices are indexed public observations, not a live reserved cart. | https://jlcpcb.com/partdetail/0603WAF1002T5E/C25804
Resistor 5k1 1% | UNI-ROYAL | 0603WAF5101T5E | C23186 | 0603 | Resistor_SMD:R_0603_1608Metric | KiCad10 bundled generic model; footprint/package verified | 2 |  |  |  | Basic; Primary JLC part identity, value, package and assembly class checked; stock/prices are indexed public observations, not a live reserved cart. | https://jlcpcb.com/partdetail/0603WAF5101T5E/C23186 | Separate USB-C CC1 and CC2 Rd resistors; do not tie CC lines together.
Capacitor 100n 50V X7R | YAGEO | CC0603KRX7R9BB104 | C14663 | 0603 | Capacitor_SMD:C_0603_1608Metric | KiCad10 bundled generic model; footprint/package verified | 6 |  |  |  | Basic; Primary JLC part identity, value, package and assembly class checked; stock/prices are indexed public observations, not a live reserved cart. | https://jlcpcb.com/partdetail/CC0603KRX7R9BB104/C14663 | 100nF, 50V, X7R, ±10%; C14663 is YAGEO, not Samsung.
Capacitor 1u 16V X7R | Walsin Tech Corp | 0603B105K160CT | C108463 | 0603 | Capacitor_SMD:C_0603_1608Metric | KiCad10 bundled generic model; footprint/package verified | 6 | 88684 (indexed JLC) | 0.0162 at 1+ | 1 | Extended; Primary JLC part identity, value, package and assembly class checked; stock/prices are indexed public observations, not a live reserved cart. | https://jlcpcb.com/partdetail/Walsin_TechCorp-0603B105K160CT/C108463 | 1uF, 16V, X7R, ±10%; Economic and Standard assembly listed. Do not substitute C15849 (X5R).
Capacitor 2u2 10V X7R | KYOCERA AVX | 0603ZC225KAT2A | C2179699 | 0603 | Capacitor_SMD:C_0603_1608Metric | KiCad10 bundled generic model; footprint/package verified | 1 | 302 (indexed JLC) | 0.0397 at 1+ | 1 | Extended; Primary JLC part identity, value, package and assembly class checked; stock/prices are indexed public observations, not a live reserved cart. | https://jlcpcb.com/partdetail/KyoceraAVX-0603ZC225KAT2A/C2179699 | 2.2uF, 10V, X7R, ±10%; Economic and Standard assembly listed. JLC manufacturer label blank; LCSC confirms AVX. Do not substitute C23630 (X5R).
Capacitor 100n 50V X7R 0402 | Samsung Electro-Mechanics | CL05B104KB54PNC | C307331 | 0402 | Capacitor_SMD:C_0402_1005Metric | KiCad10 bundled generic model; footprint/package verified | 1 |  |  |  | Basic; Primary JLC part identity, value, package and assembly class checked; stock/prices are indexed public observations, not a live reserved cart. | https://jlcpcb.com/partdetail/CL05B104KB54PNC/C307331 | USB-carrier C1 decoupling capacitor; 100nF, 50V, X7R, ±10%; Economic and Standard assembly listed.
Tactile pushbutton | Panasonic | EVQP7A01P | C79167 | 3.5x3.55mm side-actuated tactile | Button_Switch_SMD:SW_SPST_EVQP7A | KiCad10 bundled generic model; footprint/package verified | 2 | 10104 (indexed JLC parts listing) | 0.0820 at 1+ | 1 | Extended; Primary JLC part identity, value, package and assembly class checked; stock/prices are indexed public observations, not a live reserved cart. | https://jlcpcb.com/partdetail/PANASONIC-EVQP7A01P/C79167 | Side-actuated SPST tactile switch, 3.5x3.55mm, 1.35mm height, 2.2N force; Economic and Standard assembly listed.
Main vertical board-to-wire socket | JST | BM06B-SRSS-TB(LF)(SN) | C160392 | SH/SR 6-way 1mm vertical SMD | Connector_JST:JST_SH_BM06B-SRSS-TB_1x06-1MP_P1.00mm_Vertical | KiCad10 Connector_JST.3dshapes/JST_SH_BM06B-SRSS-TB_1x06-1MP_P1.00mm_Vertical.step | 1 | 9030 (old indexed LCSC; live stock unverified) | 0.3015 at 5+ (old indexed LCSC) | 5 | Exact MPN/code and vertical type verified in primary JLC listing; Extended; live assembly stock pending | https://jlcpcb.com/partdetail/JST-BM06B_SRSS_TB_LF_SN/C160392 | Replaces horizontal main J1 to avoid mated-plug/LED-lead collision. C9900169871 is an unavailable consigned placeholder and must not be substituted. Confirm exact mating harness and height in case. Cable must use plain SHR-06V-S mating housings at both ends; wider SHR-06V-S-B is outside reviewed mechanical envelope.
