hmcneill46/house-rules-led-recreation/hardware/quotes/2026-10-29/input/usb-bom-jlc-120-quote-only.csv

Comment | Designator | Footprint | LCSC Part #
CL05B104KB54PNC | C1 | C_0402_1005Metric | C307331
SMF5.0A | D1 | D_SOD-123F | C151296
USB4105-GF-A-120 | J1 | USB_C_Receptacle_GCT_USB4105-xx-A_16P_TopMnt_Horizontal | C5184243
SM06B-SRSS-TB(LF)(SN) | J2 | JST_SH_SM06B-SRSS-TB_1x06-1MP_P1.00mm_Horizontal | C160405
0603WAF5101T5E | R1,R2 | R_0603_1608Metric | C23186
TPD4E05U06DQAR | U1 | USON-10_2.5x1.0mm_P0.5mm | C138714
