hmcneill46/house-rules-led-recreation/hardware/revisions/B2/quotes/final-review-2026-10-29/uploaded-bom.csv

Comment | Designator | Footprint | LCSC Part #
0603B103K500NT | C11,C12 | C_0603_1608Metric | C57112
0603WAF1002T5E | R10,R11,R12,R13,R14,R21,R23 | R_0603_1608Metric | C25804
0603WAF1003T5E | R16 | R_0603_1608Metric | C25803
0603WAF1502T5E | R22 | R_0603_1608Metric | C22809
0603WAF4701T5E | R5,R6,R7,R8,R9,R15 | R_0603_1608Metric | C23162
0603WAF4702T5E | R17,R18,R19,R20 | R_0603_1608Metric | C25819
0603WAF6801T5E | R1,R2,R3,R4 | R_0603_1608Metric | C23212
AO3401A | Q1,Q2,Q3,Q4,Q5 | SOT-23 | C15127
BQ24392RSER | U9 | Texas_UQFN-10_1.5x2mm_P0.5mm | C128408
CC0603KRX7R9BB104 | C1,C2,C3,C4,C15 | C_0603_1608Metric | C14663
CL10A105KB8NNNC | C5,C6,C7,C14,C16 | C_0603_1608Metric | C15849
CL10A475KO8NNNC | C8 | C_0603_1608Metric | C19666
CL10B102KB8NNNC | C9,C10,C13 | C_0603_1608Metric | C1588
SMD1206B075TF/16 | F1 | Fuse_1206_3216Metric | C269118
SMF5.0A | D1 | D_SOD-123F | C151296
TLC59282RGER | U1,U2,U3,U4 | RGE0024C | C702074
TPD4E05U06DQAR | U7 | USON-10_2.5x1.0mm_P0.5mm | C138714
TPS22918DBVR | U5,U6,U8 | SOT-23-6 | C131941
