hmcneill46/house-rules-led-recreation/hardware/manufacturing/A1_review/usb/assembly/bom.csv

MPN | LCSC | Qty | Designators | Value | Package
CL05B104KB54PNC | C307331 | 1 | C1 | 100n 50V X7R 0402 | C_0402_1005Metric
SMF5.0A | C151296 | 1 | D1 | SMF5.0A | D_SOD-123F
USB4105-GF-A | C3020560 | 1 | J1 | USB-C 5V DATA | USB_C_Receptacle_GCT_USB4105-xx-A_16P_TopMnt_Horizontal
SM06B-SRSS-TB(LF)(SN) | C160405 | 1 | J2 | MAIN BOARD | JST_SH_SM06B-SRSS-TB_1x06-1MP_P1.00mm_Horizontal
0603WAF5101T5E | C23186 | 2 | R1,R2 | 5k1 1% | R_0603_1608Metric
TPD4E05U06DQAR | C138714 | 1 | U1 | TPD4E05U06DQAR | USON-10_2.5x1.0mm_P0.5mm
