hmcneill46/house-rules-led-recreation/hardware/revisions/B2/quotes/cost-study-2026-10-29/native-6L-dhl-vat-before-coupon.png

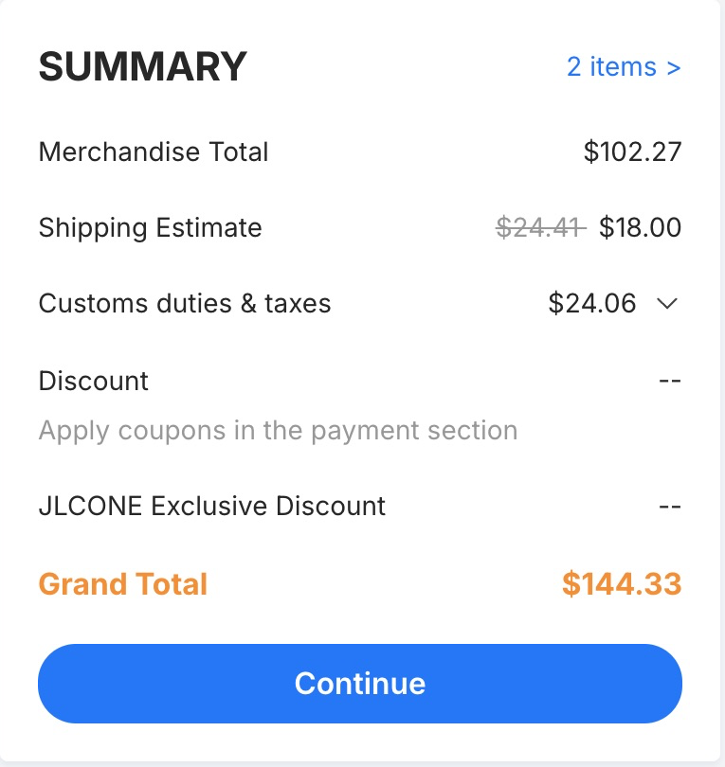
hardware/revisions/B2/quotes/cost-study-2026-10-29/native-6L-dhl-vat-before-coupon.png
