hmcneill46/house-rules-led-recreation/hardware/revisions/B2/quotes/cost-study-basic-iref-2026-10-29/native-55-cart-directline-coupon30.png

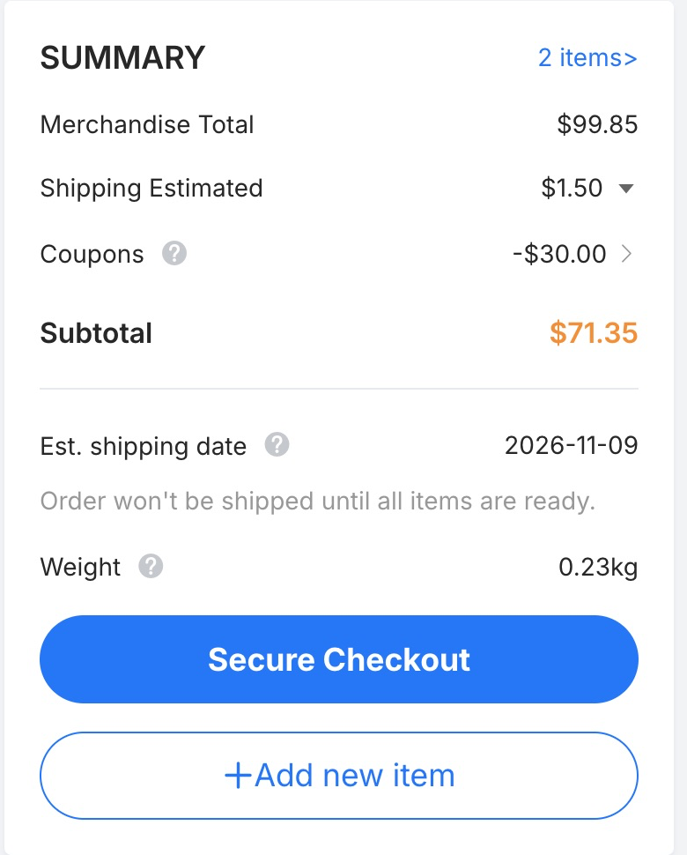
hardware/revisions/B2/quotes/cost-study-basic-iref-2026-10-29/native-55-cart-directline-coupon30.png
