hmcneill46/house-rules-led-recreation/hardware/revisions/B2/quotes/updated-F-2026-10-31/evidence/sourcing-13-handling-summary.png

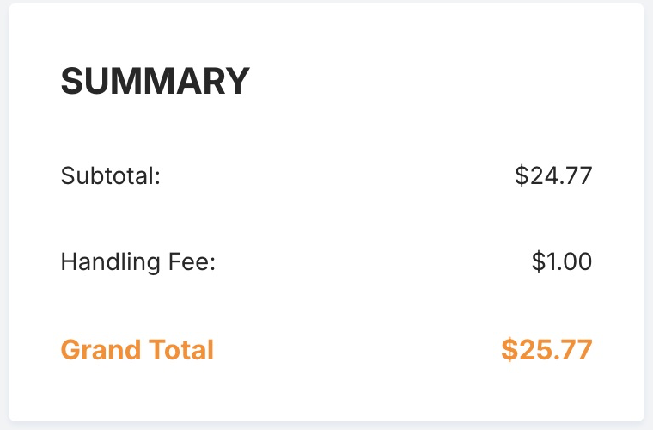
hardware/revisions/B2/quotes/updated-F-2026-10-31/evidence/sourcing-13-handling-summary.png
