hmcneill46/house-rules-led-recreation/hardware/revisions/B2/printing/2026-10-31-confirmed-F/models/B2-main-board-fit-1p6mm.stl

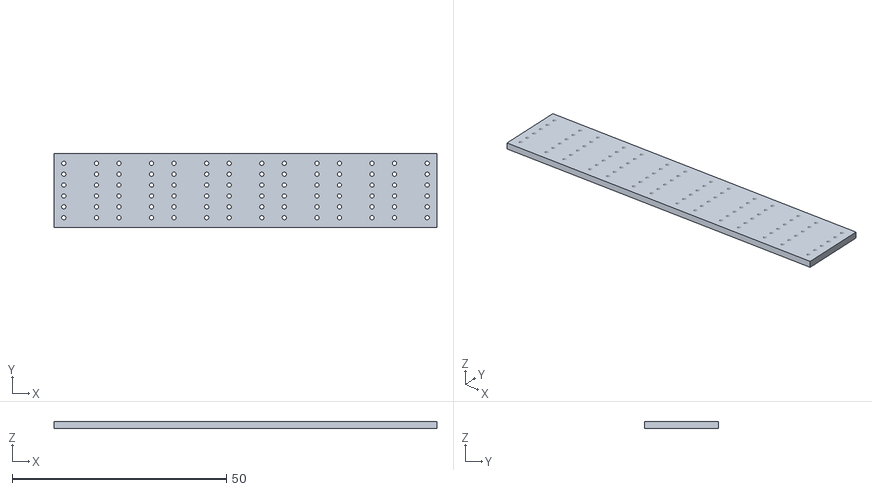
[picture p45: CAD file, 2026-10-31]
hardware/revisions/B2/printing/2026-10-31-confirmed-F/models/B2-main-board-fit-1p6mm.stl
89.5 x 17.3 x 1.60
