hmcneill46/house-rules-led-recreation/hardware/kicad/3d/Button_Switch_SMD__SW_SPST_EVQP7A.step

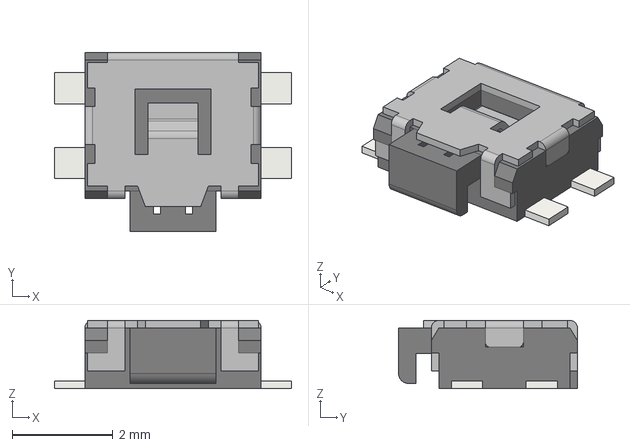
[picture p46: CAD file, 2026-10-29]
hardware/kicad/3d/Button_Switch_SMD__SW_SPST_EVQP7A.step
4.70 x 3.55 x 1.35 mm
