hmcneill46/house-rules-led-recreation/hardware/mechanical/alignment-tray.stl

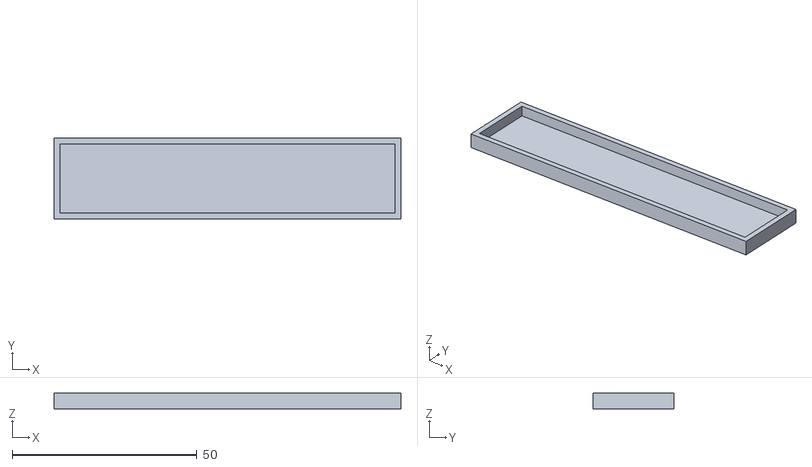
[picture p47: CAD file, 2026-10-29]
hardware/mechanical/alignment-tray.stl
93.8 x 21.8 x 4.20
