hmcneill46/house-rules-led-recreation/hardware/printing/HouseRules_Fit_KE04_PLA.3mf

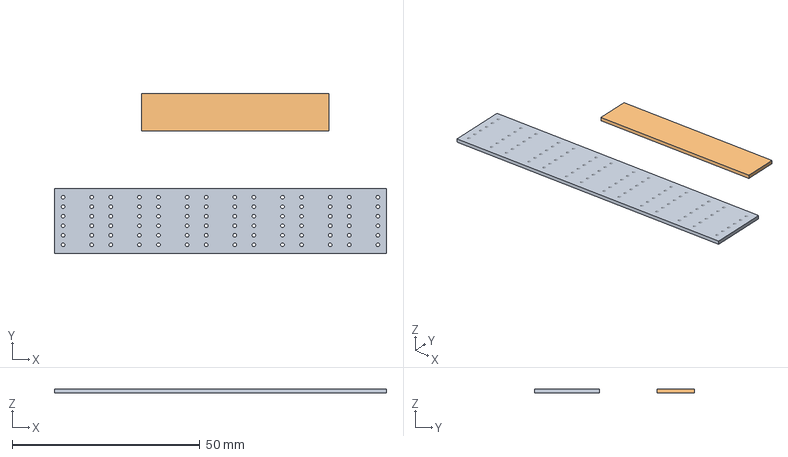
[picture p48: CAD file, 2026-10-29]
hardware/printing/HouseRules_Fit_KE04_PLA.3mf
88.4 x 42.6 x 1.00 mm
pin-fit-plate.stl
pin-fit-scale-50mm.stl
