hmcneill46/house-rules-led-recreation/hardware/revisions/B2/mechanical/case-closure-fit-coupon.stl

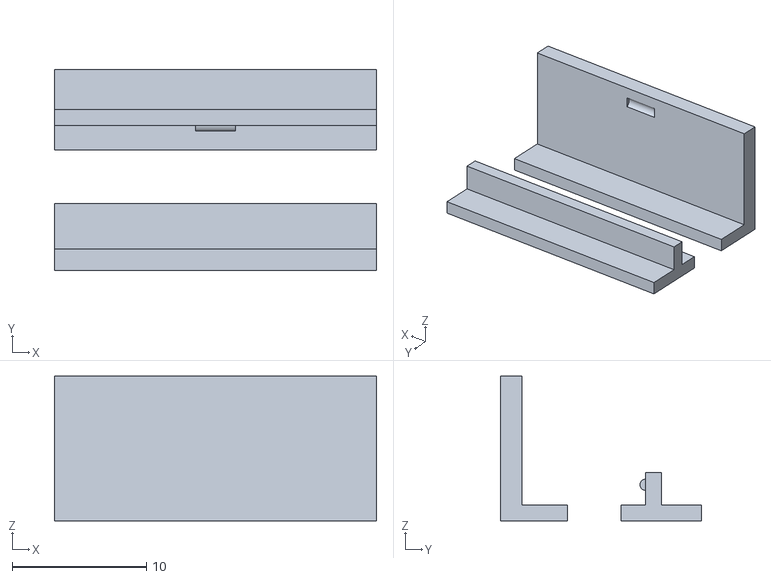
[picture p49: CAD file, 2026-10-31]
hardware/revisions/B2/mechanical/case-closure-fit-coupon.stl
24.0 x 15.0 x 10.8
