hmcneill46/house-rules-led-recreation/hardware/revisions/B2/mechanical/render/closure-transition-interference.stl

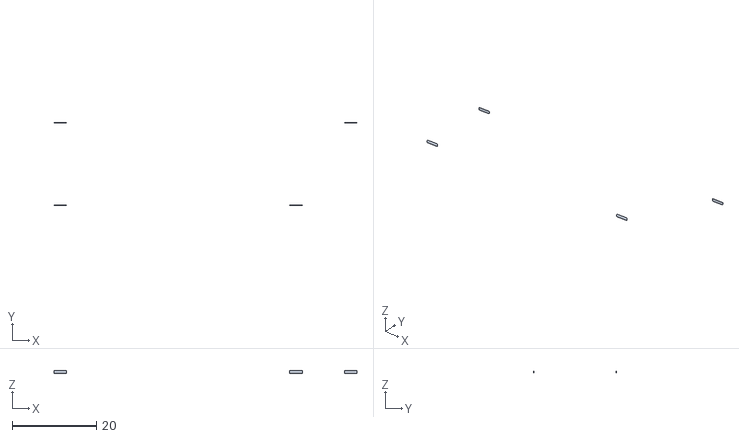
[picture p50: CAD file, 2026-10-31]
hardware/revisions/B2/mechanical/render/closure-transition-interference.stl
72.0 x 19.8 x 0.698
