hmcneill46/house-rules-led-recreation/hardware/revisions/B2/printing/2026-10-31-confirmed-F/projects/01_B2_F_FitTests_KE04_HyperPLA.3mf

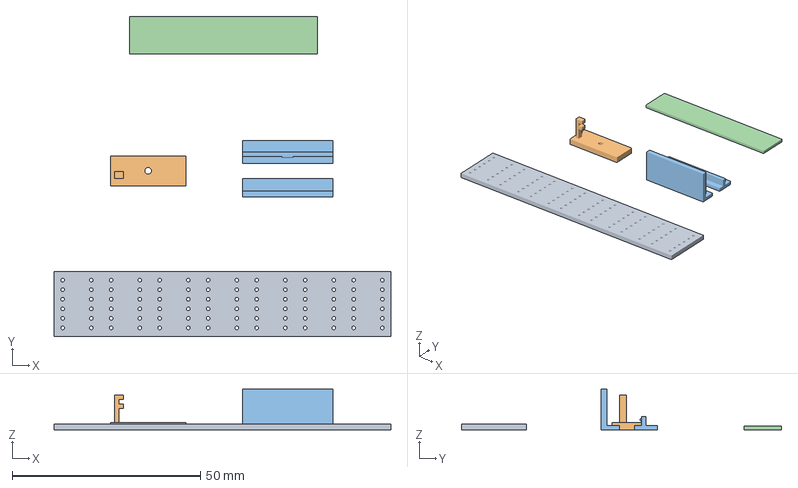
[picture p51: CAD file, 2026-10-31]
hardware/revisions/B2/printing/2026-10-31-confirmed-F/projects/01_B2_F_FitTests_KE04_HyperPLA.3mf
89.4 x 85.0 x 10.8 mm
B2-main-board-fit-1p6mm
mcu-channel-fit-coupon
case-closure-fit-coupon
pin-fit-scale-50mm
