hmcneill46/house-rules-led-recreation/hardware/revisions/B2/printing/2026-10-31-confirmed-F/single-plate/projects/B2_F_AllParts_OnePlate_KE04_HyperPLA.3mf

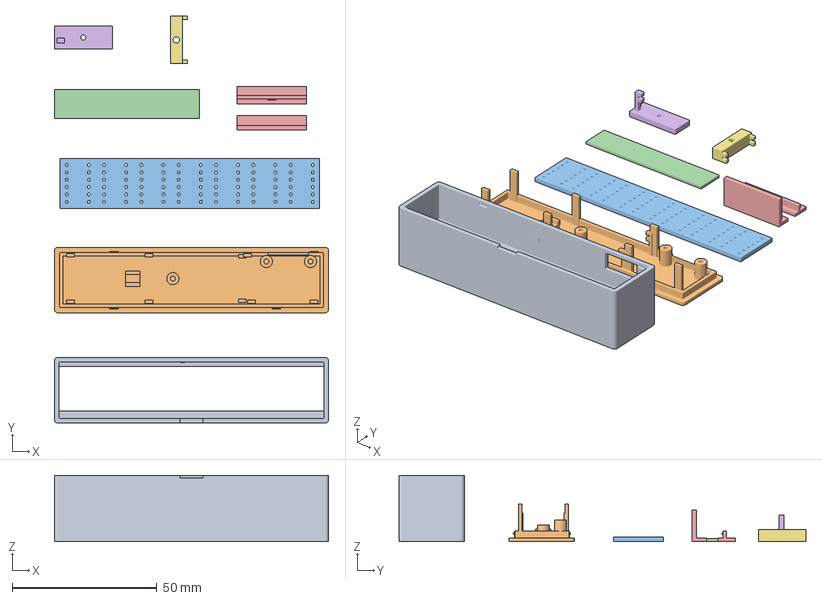
[picture p52: CAD file, 2026-10-31]
hardware/revisions/B2/printing/2026-10-31-confirmed-F/single-plate/projects/B2_F_AllParts_OnePlate_KE04_HyperPLA.3mf
94.7 x 140.4 x 22.8 mm
enclosure-B2-PROTOTYPE-shell
enclosure-B2-PROTOTYPE-back
B2-main-board-fit-1p6mm
pin-fit-scale-50mm
case-closure-fit-coupon
mcu-channel-fit-coupon
mcu-retaining-cap
