hmcneill46/house-rules-led-recreation/hardware/revisions/B2/printing/2026-10-31-confirmed-F/sliced-projects/02_B2_F_Shell_KE04_HyperPLA.3mf

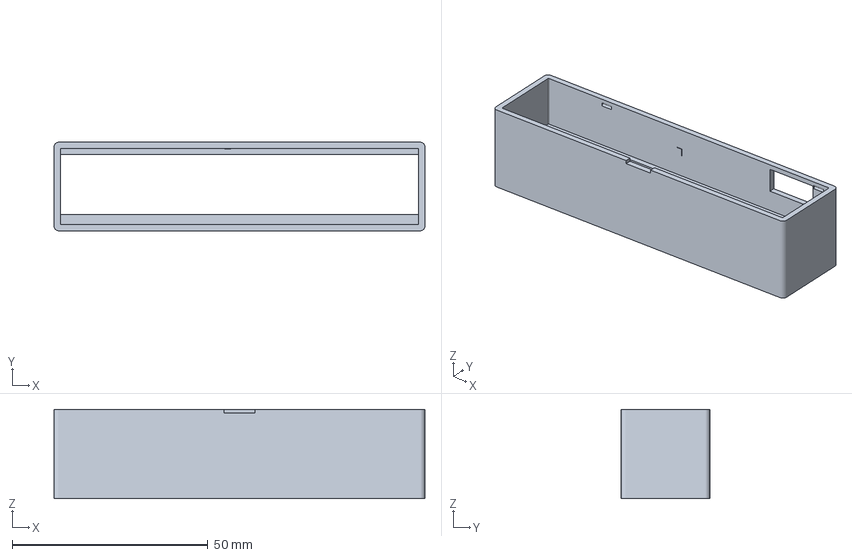
[picture p53: CAD file, 2026-10-31]
hardware/revisions/B2/printing/2026-10-31-confirmed-F/sliced-projects/02_B2_F_Shell_KE04_HyperPLA.3mf
94.7 x 22.6 x 22.8 mm
