hmcneill46/house-rules-led-recreation/hardware/revisions/B2/printing/fine-pitch-tests-2026-10-30/models/E_pitch_12p850.stl

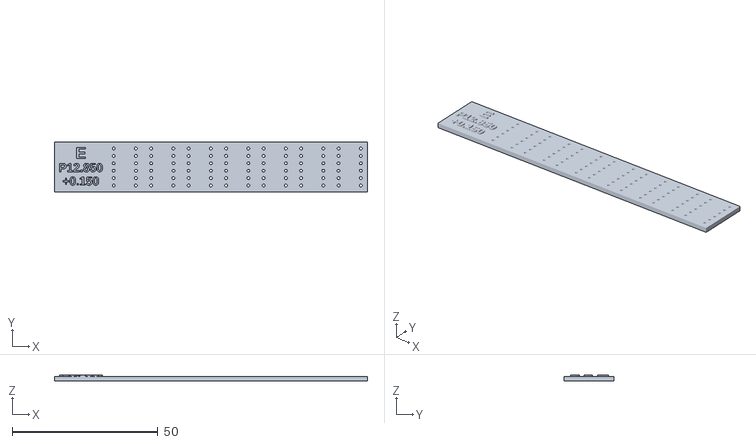
[picture p54: CAD file, 2026-10-30]
hardware/revisions/B2/printing/fine-pitch-tests-2026-10-30/models/E_pitch_12p850.stl
107.3 x 17.3 x 2.20
