hmcneill46/house-rules-led-recreation/hardware/revisions/B2/printing/fine-pitch-tests-2026-10-30/projects/LED_Pitch_DEF_Fine_KE04_HyperPLA.3mf

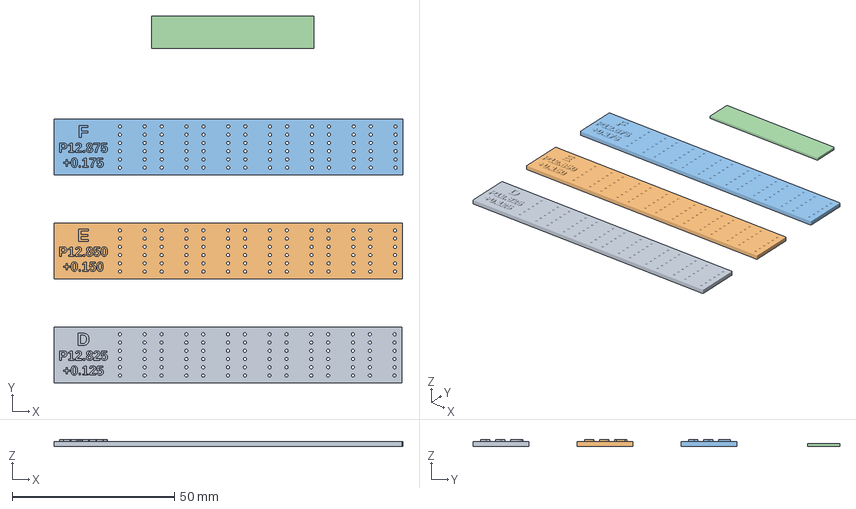
[picture p55: CAD file, 2026-10-30]
hardware/revisions/B2/printing/fine-pitch-tests-2026-10-30/projects/LED_Pitch_DEF_Fine_KE04_HyperPLA.3mf
107.4 x 113.0 x 2.20 mm
D_pitch_12p825
E_pitch_12p850
F_pitch_12p875
pin-fit-scale-50mm
