hmcneill46/house-rules-led-recreation/hardware/revisions/B2/printing/projects/02_B2_Shell_KE04_HyperPLA.3mf

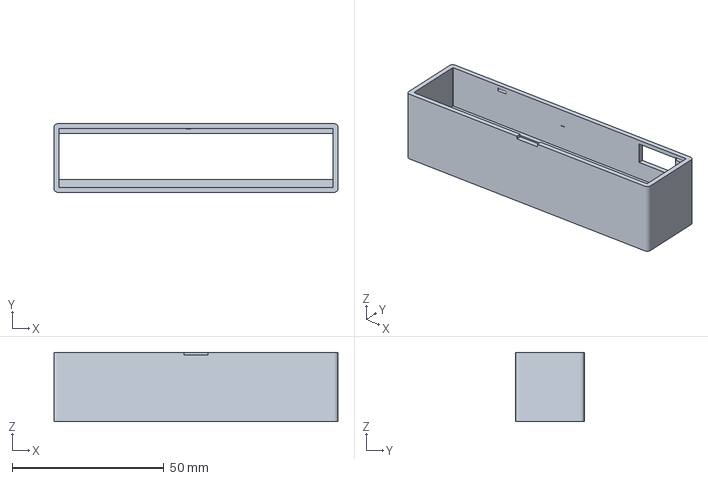
[picture p56: CAD file, 2026-10-29]
hardware/revisions/B2/printing/projects/02_B2_Shell_KE04_HyperPLA.3mf
93.6 x 22.6 x 22.8 mm
