hmcneill46/house-rules-led-recreation/hardware/mechanical/pin-fit-scale-50mm.stl

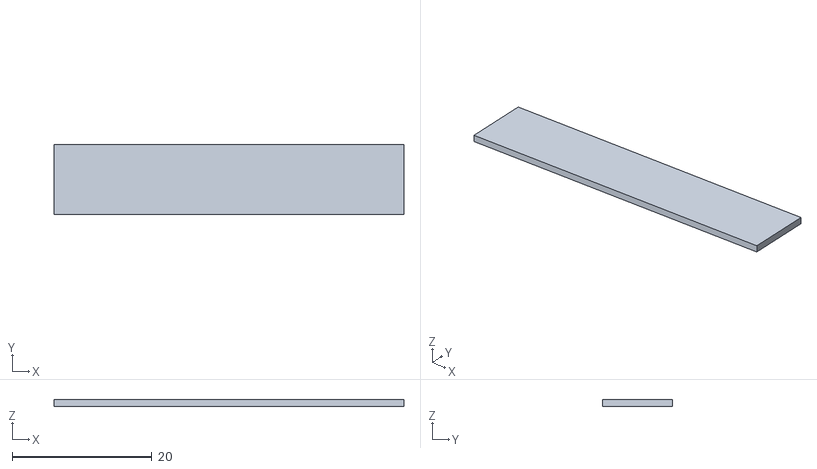
[picture p57: CAD file, 2026-10-29]
hardware/mechanical/pin-fit-scale-50mm.stl
50.0 x 10.0 x 1.00
