hmcneill46/house-rules-led-recreation/hardware/revisions/B2/mechanical/enclosure-B2-PROTOTYPE-back.stl

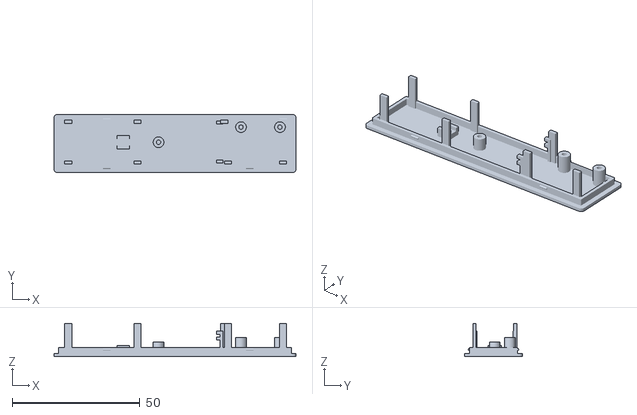
[picture p58: CAD file, 2026-10-31]
hardware/revisions/B2/mechanical/enclosure-B2-PROTOTYPE-back.stl
94.6 x 22.6 x 12.9
