hmcneill46/house-rules-led-recreation/hardware/revisions/B2/printing/2026-10-31-confirmed-F/sliced-projects/03_B2_F_BackAndCap_KE04_HyperPLA.3mf

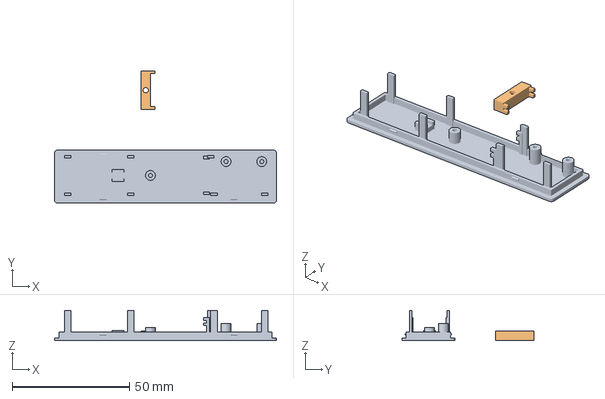
[picture p59: CAD file, 2026-10-31]
hardware/revisions/B2/printing/2026-10-31-confirmed-F/sliced-projects/03_B2_F_BackAndCap_KE04_HyperPLA.3mf
94.7 x 56.4 x 12.9 mm
enclosure-B2-PROTOTYPE-back
mcu-retaining-cap
