hmcneill46/house-rules-led-recreation/hardware/revisions/B2/printing/projects/01_B2_FitTests_KE04_HyperPLA.3mf

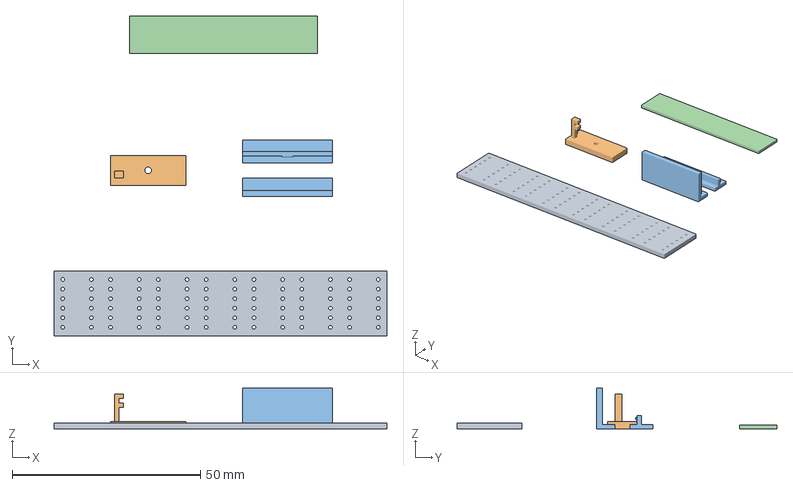
[picture p60: CAD file, 2026-10-29]
hardware/revisions/B2/printing/projects/01_B2_FitTests_KE04_HyperPLA.3mf
88.4 x 85.0 x 10.8 mm
B2-main-board-fit-1p6mm
mcu-channel-fit-coupon
case-closure-fit-coupon
pin-fit-scale-50mm
