hmcneill46/house-rules-led-recreation/hardware/revisions/B2/printing/sliced-projects/03_B2_BackAndCap_KE04_HyperPLA.3mf

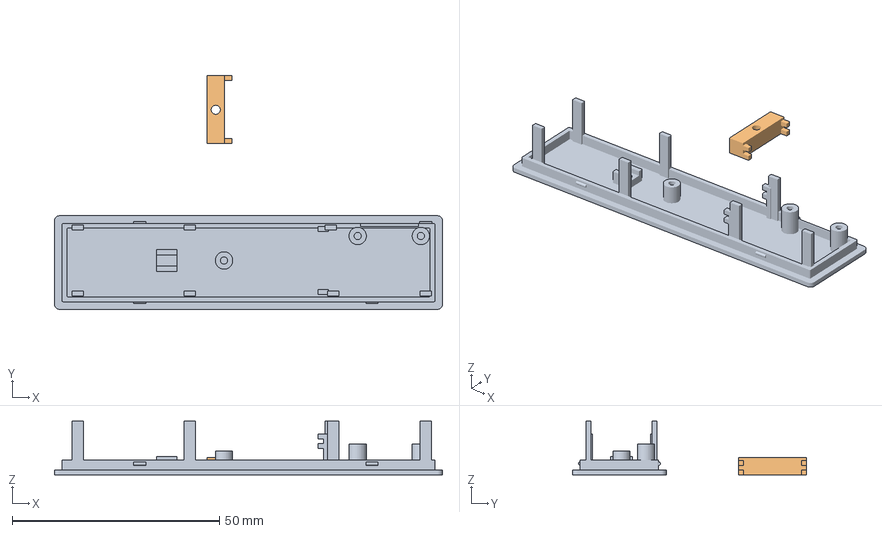
[picture p61: CAD file, 2026-10-29]
hardware/revisions/B2/printing/sliced-projects/03_B2_BackAndCap_KE04_HyperPLA.3mf
93.6 x 56.4 x 12.9 mm
enclosure-B2-PROTOTYPE-back
mcu-retaining-cap
