hmcneill46/house-rules-led-recreation/hardware/mechanical/led-standoff-spacer-3mm.stl

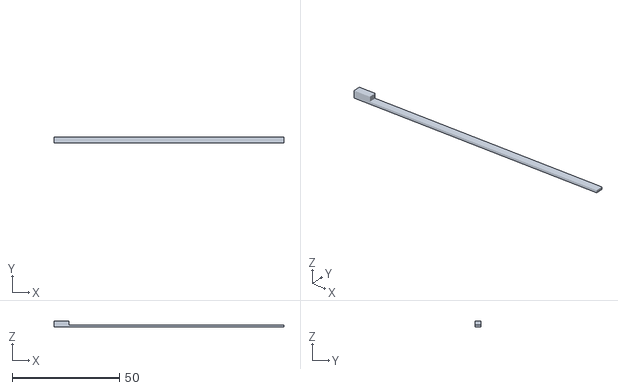
[picture p62: CAD file, 2026-10-29]
hardware/mechanical/led-standoff-spacer-3mm.stl
107.0 x 3.00 x 3.00
