hmcneill46/house-rules-led-recreation/hardware/revisions/B2/mechanical/mcu-retaining-cap.stl

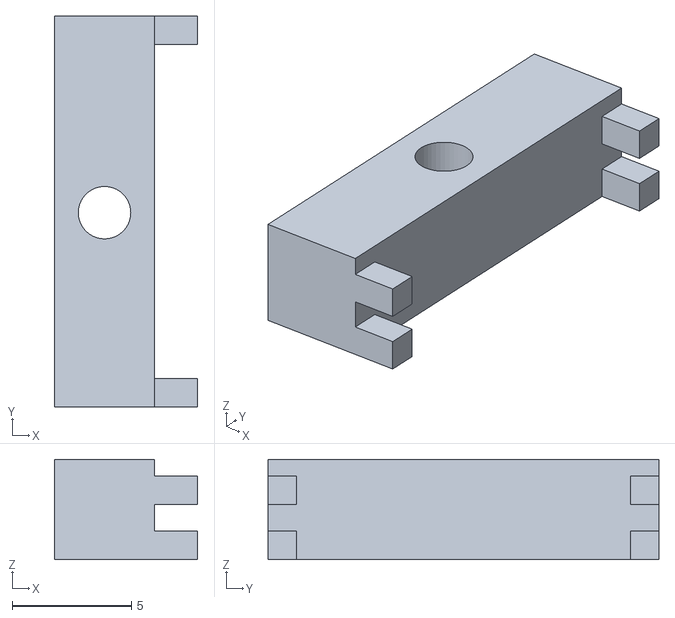
[picture p63: CAD file, 2026-10-31]
hardware/revisions/B2/mechanical/mcu-retaining-cap.stl
6.00 x 16.4 x 4.20
