hmcneill46/house-rules-led-recreation/hardware/mechanical/enclosure-PROTOTYPE-back.stl

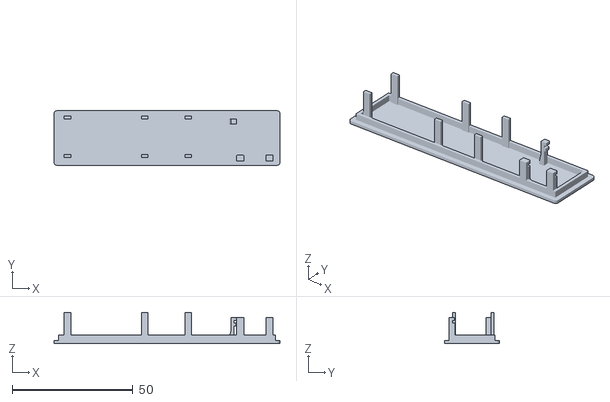
[picture p64: CAD file, 2026-10-29]
hardware/mechanical/enclosure-PROTOTYPE-back.stl
93.6 x 22.6 x 13.0
