hmcneill46/house-rules-led-recreation/hardware/revisions/B2/mechanical/mcu-channel-fit-coupon.stl

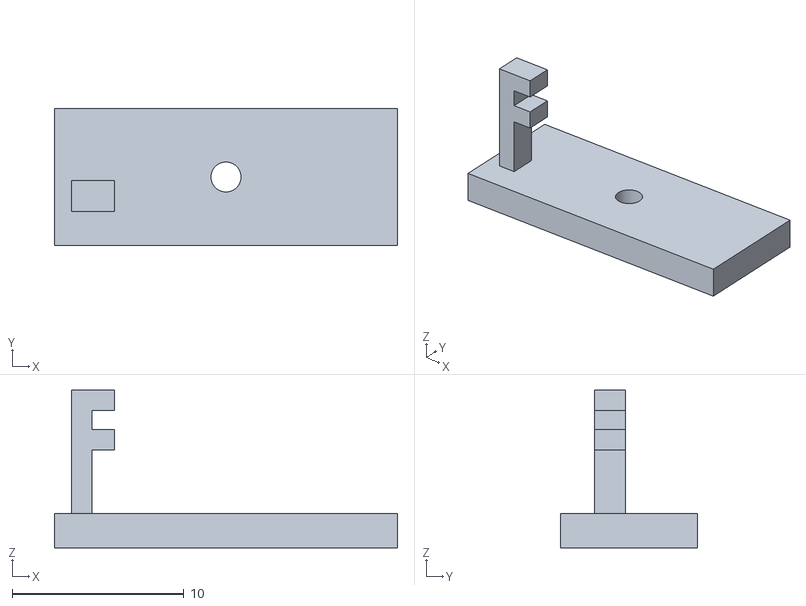
[picture p65: CAD file, 2026-10-29]
hardware/revisions/B2/mechanical/mcu-channel-fit-coupon.stl
20.0 x 8.00 x 9.20
