hmcneill46/house-rules-led-recreation/hardware/mechanical/pin-fit-plate.stl

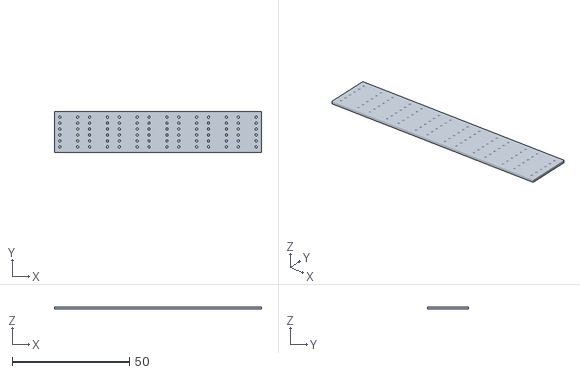
[picture p66: CAD file, 2026-10-29]
hardware/mechanical/pin-fit-plate.stl
88.4 x 17.3 x 1.00
