hmcneill46/house-rules-led-recreation/hardware/revisions/B2/printing/2026-10-31-confirmed-F/models/B2-main-board-fit-1p6mm.scad

// PRINT-ONLY gauge: no copper/components; NOT fabrication data.
//1.0mm FDM holes differ from the real0.90mm finished PCB holes.
$fn=32;
holes=[[2.29, 2.3], [2.29, 4.840001], [2.29, 7.380001], [2.29, 9.92], [2.29, 12.46], [2.29, 15.0], [9.91, 2.3], [9.91, 4.840001], [9.91, 7.380001], [9.91, 9.92], [9.91, 12.46], [9.91, 15.0], [15.165, 2.3], [15.165, 4.840001], [15.165, 7.380001], [15.165, 9.92], [15.165, 12.46], [15.165, 15.0], [22.785, 2.3], [22.785, 4.840001], [22.785, 7.380001], [22.785, 9.92], [22.785, 12.46], [22.785, 15.0], [28.04, 2.3], [28.04, 4.840001], [28.04, 7.380001], [28.04, 9.92], [28.04, 12.46], [28.04, 15.0], [35.66, 2.3], [35.66, 4.840001], [35.66, 7.380001], [35.66, 9.92], [35.66, 12.46], [35.66, 15.0], [40.915, 2.3], [40.915, 4.840001], [40.915, 7.380001], [40.915, 9.92], [40.915, 12.46], [40.915, 15.0], [48.535, 2.3], [48.535, 4.840001], [48.535, 7.380001], [48.535, 9.92], [48.535, 12.46], [48.535, 15.0], [53.79, 2.3], [53.79, 4.840001], [53.79, 7.380001], [53.79, 9.92], [53.79, 12.46], [53.79, 15.0], [61.41, 2.3], [61.41, 4.840001], [61.41, 7.380001], [61.41, 9.92], [61.41, 12.46], [61.41, 15.0], [66.665, 2.3], [66.665, 4.840001], [66.665, 7.380001], [66.665, 9.92], [66.665, 12.46], [66.665, 15.0], [74.285, 2.3], [74.285, 4.840001], [74.285, 7.380001], [74.285, 9.92], [74.285, 12.46], [74.285, 15.0], [79.54, 2.3], [79.54, 4.840001], [79.54, 7.380001], [79.54, 9.92], [79.54, 12.46], [79.54, 15.0], [87.16, 2.3], [87.16, 4.840001], [87.16, 7.380001], [87.16, 9.92], [87.16, 12.46], [87.16, 15.0]];
difference(){cube([89.45,17.3,1.6]);
 for(p=holes)translate([p[0],p[1],-.1])cylinder(h=1.8,d=1.0);}
