hmcneill46/house-rules-led-recreation/hardware/revisions/B2/mechanical/stock-module-values.scad

// Generated by build.py from ../stock-module-contract.json.
case_main_xy=[89.45,17.3];
case_outer_xyz=[94.65,22.6,24.0];
case_front_opening=[91.45,18.4];
case_led_module_pitch=12.875;
case_first_led_centre=[6.1,8.65];
case_led_body_allowance=[12.9,18.0];
main_upper_wire_pad_stop_x=65.4;
mcu_x=41.1;
mcu_y=-0.25;
mcu_w=21.0;
mcu_h=17.8;
mcu_t=0.804;
mcu_under_z=15.3;
mcu_top_h=3.5;
mcu_under_allow=1.6;
usb_x=68.0;
usb_y=3.13;
usb_w=20.32;
usb_h=13.97;
usb_t=1.6;
usb_under_z=15.0;
usb_top_h=3.4;
usb_under_allow=1.6;
usb_face_x=78.16;
usb_holes=[[70.54,14.56],[85.78,14.56]];
screw_pilot_d=1.75;
screw_pilot_end_z=21.6;
mcu_pad_points=[[59.195,16.36],[56.655,16.26],[54.115,16.26],[51.575,16.26],[46.495,16.26],[49.035,16.26],[54.115,1.02],[49.035,1.02],[59.195,0.92],[56.655,1.02],[46.495,1.02],[43.955,0.92]];
mcu_component_boxes=[[55.165,6.02174,55.793,7.15774],[49.69161,5.0392,51.14581,5.7344],[44.56914,7.1394,45.67764,8.2479],[52.79176,14.3225,53.72276,14.8455],[53.98328,8.87332,54.91428,9.39632],[50.03176,14.2625,50.96276,14.7855],[53.59995,2.37481,55.91345,5.86331],[51.63339,4.76088,52.74189,5.86938],[44.76714,11.81667,45.69814,12.33967],[54.8926,12.64877,55.8236,13.17177],[54.25049,6.01836,55.18149,6.54136],[44.76918,9.10496,45.70018,9.62796],[41.06346,11.171,43.81586,15.271],[53.87507,12.6508,54.80607,13.1738],[46.99676,14.2725,47.92776,14.7955],[59.72436,1.939,61.88336,2.955],[45.63427,13.93448,46.15727,14.86548],[59.72436,14.413,61.88336,15.429],[52.38896,2.7374,52.91196,3.6684],[51.79482,5.91676,52.72582,6.43976],[44.53292,13.93012,45.05592,14.86112],[44.63485,2.50423,45.15785,3.43523],[45.74176,5.9725,46.67276,6.4955],[54.59487,13.51939,55.82987,14.80939],[45.63833,12.91137,46.16133,13.84237],[55.22258,10.999,55.74558,11.93],[52.74782,5.91371,53.67882,6.43671],[46.24588,6.47889,53.86938,14.11739],[53.9843,9.77248,54.9153,10.29548],[51.7999,4.39784,52.7309,4.92084],[51.20227,5.06048,51.72527,5.99148],[48.94189,14.27945,49.87289,14.80245],[44.51075,12.94733,45.61925,14.05583],[49.95016,5.7542,50.88116,6.2772],[48.2632,5.9198,49.1942,6.4428],[44.42441,9.48704,46.01291,11.23054],[51.83016,2.7374,52.35316,3.6684],[54.01396,7.53047,55.03396,8.81047],[53.73726,13.784,54.41726,14.864],[49.324,2.59109,51.474,5.00809],[54.27792,6.95612,55.20892,7.47912],[44.75176,5.9725,45.68276,6.4955],[47.59114,3.21649,49.04534,3.91169],[55.17212,8.12181,55.80012,9.25781],[53.88171,11.5783,54.81271,12.1013],[45.16926,2.50321,45.69226,3.43421],[44.76714,8.23933,45.69814,8.76233],[45.06632,13.93012,45.58932,14.86112],[41.06346,2.0546,43.81586,6.1546],[52.93506,2.7374,53.45806,3.6684],[53.88239,11.03841,54.81339,11.56141],[52.80247,4.41736,53.32547,5.34836],[41.37366,7.684,43.24966,9.8865],[47.49458,3.77696,48.91408,5.09046],[47.95676,14.2725,48.88776,14.7955],[53.74227,6.55604,54.26527,7.48704],[53.87294,12.11232,54.80394,12.63532],[44.72389,3.44572,47.66139,5.87922],[44.76511,11.26396,45.69611,11.78696],[55.17008,9.8419,55.79808,10.9779],[44.76206,6.52534,45.69306,7.04834],[55.22055,7.15243,55.74355,8.08343],[47.58606,5.18042,49.04026,5.87562]];
snap_z=21.3;
snap_top_x=[18.0,74.0];
snap_bottom_x=[18.0,87.0];
snap_r=0.42;
snap_length=3.0;
snap_pocket_clearance=0.1;
snap_end_clearance=0.1;
snap_transition_offset=0.8;
