hmcneill46/house-rules-led-recreation/hardware/revisions/B2/printing/fine-pitch-tests-2026-10-30/models/D_pitch_12p825.scad

// PRINT-ONLY fine trial; not a fabrication or case outline.
// Intramodule pattern unchanged;1.0mm holes;1.6mm base.
$fn=32;
holes=[[2.29, 2.3], [9.91, 7.380001], [9.91, 4.840001], [9.91, 2.3], [2.29, 4.840001], [2.29, 7.380001], [2.29, 9.92], [2.29, 12.46], [2.29, 15.0], [9.91, 15.0], [9.91, 12.46], [9.91, 9.92], [15.115, 2.3], [22.735, 7.380001], [22.735, 4.840001], [22.735, 2.3], [15.115, 4.840001], [15.115, 7.380001], [15.115, 9.92], [15.115, 12.46], [15.115, 15.0], [22.735, 15.0], [22.735, 12.46], [22.735, 9.92], [27.94, 2.3], [35.56, 7.380001], [35.56, 4.840001], [35.56, 2.3], [27.94, 4.840001], [27.94, 7.380001], [27.94, 9.92], [27.94, 12.46], [27.94, 15.0], [35.56, 15.0], [35.56, 12.46], [35.56, 9.92], [40.765, 2.3], [48.385, 7.380001], [48.385, 4.840001], [48.385, 2.3], [40.765, 4.840001], [40.765, 7.380001], [40.765, 9.92], [40.765, 12.46], [40.765, 15.0], [48.385, 15.0], [48.385, 12.46], [48.385, 9.92], [53.59, 2.3], [61.21, 7.380001], [61.21, 4.840001], [61.21, 2.3], [53.59, 4.840001], [53.59, 7.380001], [53.59, 9.92], [53.59, 12.46], [53.59, 15.0], [61.21, 15.0], [61.21, 12.46], [61.21, 9.92], [66.415, 2.3], [74.035, 7.380001], [74.035, 4.840001], [74.035, 2.3], [66.415, 4.840001], [66.415, 7.380001], [66.415, 9.92], [66.415, 12.46], [66.415, 15.0], [74.035, 15.0], [74.035, 12.46], [74.035, 9.92], [79.24, 2.3], [86.86, 7.380001], [86.86, 4.840001], [86.86, 2.3], [79.24, 4.840001], [79.24, 7.380001], [79.24, 9.92], [79.24, 12.46], [79.24, 15.0], [86.86, 15.0], [86.86, 12.46], [86.86, 9.92]];
union(){difference(){union(){cube([89.150,17.3,1.6]);
 translate([-18,0,0])cube([18.2,17.3,1.6]);}
 for(p=holes)translate([p[0],p[1],-.1])cylinder(h=1.8,d=1.0);}
 translate([-9,13.4,1.59])linear_extrude(height=.61)text("D",size=4,font="Liberation Sans:style=Bold",halign="center",valign="center");
 translate([-9,8.4,1.59])linear_extrude(height=.61)text("P12.825",size=3,font="Liberation Sans:style=Bold",halign="center",valign="center");
 translate([-9,3.8,1.59])linear_extrude(height=.61)text("+0.125",size=3,font="Liberation Sans:style=Bold",halign="center",valign="center");}
