hmcneill46/house-rules-led-recreation/hardware/revisions/B2/printing/fine-pitch-tests-2026-10-30/models/E_pitch_12p850.scad

// PRINT-ONLY fine trial; not a fabrication or case outline.
// Intramodule pattern unchanged;1.0mm holes;1.6mm base.
$fn=32;
holes=[[2.29, 2.3], [9.91, 7.380001], [9.91, 4.840001], [9.91, 2.3], [2.29, 4.840001], [2.29, 7.380001], [2.29, 9.92], [2.29, 12.46], [2.29, 15.0], [9.91, 15.0], [9.91, 12.46], [9.91, 9.92], [15.14, 2.3], [22.76, 7.380001], [22.76, 4.840001], [22.76, 2.3], [15.14, 4.840001], [15.14, 7.380001], [15.14, 9.92], [15.14, 12.46], [15.14, 15.0], [22.76, 15.0], [22.76, 12.46], [22.76, 9.92], [27.99, 2.3], [35.61, 7.380001], [35.61, 4.840001], [35.61, 2.3], [27.99, 4.840001], [27.99, 7.380001], [27.99, 9.92], [27.99, 12.46], [27.99, 15.0], [35.61, 15.0], [35.61, 12.46], [35.61, 9.92], [40.84, 2.3], [48.46, 7.380001], [48.46, 4.840001], [48.46, 2.3], [40.84, 4.840001], [40.84, 7.380001], [40.84, 9.92], [40.84, 12.46], [40.84, 15.0], [48.46, 15.0], [48.46, 12.46], [48.46, 9.92], [53.69, 2.3], [61.31, 7.380001], [61.31, 4.840001], [61.31, 2.3], [53.69, 4.840001], [53.69, 7.380001], [53.69, 9.92], [53.69, 12.46], [53.69, 15.0], [61.31, 15.0], [61.31, 12.46], [61.31, 9.92], [66.54, 2.3], [74.16, 7.380001], [74.16, 4.840001], [74.16, 2.3], [66.54, 4.840001], [66.54, 7.380001], [66.54, 9.92], [66.54, 12.46], [66.54, 15.0], [74.16, 15.0], [74.16, 12.46], [74.16, 9.92], [79.39, 2.3], [87.01, 7.380001], [87.01, 4.840001], [87.01, 2.3], [79.39, 4.840001], [79.39, 7.380001], [79.39, 9.92], [79.39, 12.46], [79.39, 15.0], [87.01, 15.0], [87.01, 12.46], [87.01, 9.92]];
union(){difference(){union(){cube([89.300,17.3,1.6]);
 translate([-18,0,0])cube([18.2,17.3,1.6]);}
 for(p=holes)translate([p[0],p[1],-.1])cylinder(h=1.8,d=1.0);}
 translate([-9,13.4,1.59])linear_extrude(height=.61)text("E",size=4,font="Liberation Sans:style=Bold",halign="center",valign="center");
 translate([-9,8.4,1.59])linear_extrude(height=.61)text("P12.850",size=3,font="Liberation Sans:style=Bold",halign="center",valign="center");
 translate([-9,3.8,1.59])linear_extrude(height=.61)text("+0.150",size=3,font="Liberation Sans:style=Bold",halign="center",valign="center");}
