hmcneill46/house-rules-led-recreation/hardware/revisions/B2/printing/fine-pitch-tests-2026-10-30/previews/fine-spacing-trials.scad

// Preview of the actual printable STL meshes, not a photograph.
color([0.68,0.70,0.72]) {
    import("../models/D_pitch_12p825.stl");
    translate([0,30,0]) import("../models/E_pitch_12p850.stl");
    translate([0,60,0]) import("../models/F_pitch_12p875.stl");
}
