hmcneill46/house-rules-led-recreation/hardware/revisions/B2/printing/pitch-tests-2026-10-30/models/A_pitch_12p80.scad

// PRINT-ONLY spacing trial; not a PCB or case outline.
// Intramodule centres unchanged.1.0mm FDM holes,1.6mm base.
$fn=32;
holes=[[27.89, 2.3], [27.89, 4.840001], [27.89, 7.380001], [27.89, 9.92], [27.89, 12.46], [27.89, 15.0], [35.51, 15.0], [35.51, 12.46], [35.51, 9.92], [35.51, 7.380001], [35.51, 4.840001], [35.51, 2.3], [66.29, 2.3], [66.29, 4.840001], [66.29, 7.380001], [66.29, 9.92], [66.29, 12.46], [66.29, 15.0], [73.91, 15.0], [73.91, 12.46], [73.91, 9.92], [73.91, 7.380001], [73.91, 4.840001], [73.91, 2.3], [79.09, 2.3], [79.09, 4.840001], [79.09, 7.380001], [79.09, 9.92], [79.09, 12.46], [79.09, 15.0], [86.71, 15.0], [86.71, 12.46], [86.71, 9.92], [86.71, 7.380001], [86.71, 4.840001], [86.71, 2.3], [15.09, 2.3], [15.09, 4.840001], [15.09, 7.380001], [15.09, 9.92], [15.09, 12.46], [15.09, 15.0], [22.71, 15.0], [22.71, 12.46], [22.71, 9.92], [22.71, 7.380001], [22.71, 4.840001], [22.71, 2.3], [53.49, 2.3], [53.49, 4.840001], [53.49, 7.380001], [53.49, 9.92], [53.49, 12.46], [53.49, 15.0], [61.11, 15.0], [61.11, 12.46], [61.11, 9.92], [61.11, 7.380001], [61.11, 4.840001], [61.11, 2.3], [40.69, 2.3], [40.69, 4.840001], [40.69, 7.380001], [40.69, 9.92], [40.69, 12.46], [40.69, 15.0], [48.31, 15.0], [48.31, 12.46], [48.31, 9.92], [48.31, 7.380001], [48.31, 4.840001], [48.31, 2.3], [2.29, 2.3], [2.29, 4.840001], [2.29, 7.380001], [2.29, 9.92], [2.29, 12.46], [2.29, 15.0], [9.91, 15.0], [9.91, 12.46], [9.91, 9.92], [9.91, 7.380001], [9.91, 4.840001], [9.91, 2.3]];
union(){
 difference(){
  union(){cube([89.0,17.3,1.6]);
   translate([-18,0,0])cube([18.2,17.3,1.6]);}
  for(p=holes)translate([p[0],p[1],-.1])cylinder(h=1.8,d=1.0);
 }
 translate([-9,13.4,1.59])linear_extrude(height=.61)text("A",size=4,font="Liberation Sans:style=Bold",halign="center",valign="center");
 translate([-9,8.4,1.59])linear_extrude(height=.61)text("P12.80",size=3,font="Liberation Sans:style=Bold",halign="center",valign="center");
 translate([-9,3.8,1.59])linear_extrude(height=.61)text("+0.10",size=3,font="Liberation Sans:style=Bold",halign="center",valign="center");
}
