hmcneill46/house-rules-led-recreation/hardware/revisions/B2/printing/pitch-tests-2026-10-30/models/B_pitch_12p90.scad

// PRINT-ONLY spacing trial; not a PCB or case outline.
// Intramodule centres unchanged.1.0mm FDM holes,1.6mm base.
$fn=32;
holes=[[28.09, 2.3], [28.09, 4.840001], [28.09, 7.380001], [28.09, 9.92], [28.09, 12.46], [28.09, 15.0], [35.71, 15.0], [35.71, 12.46], [35.71, 9.92], [35.71, 7.380001], [35.71, 4.840001], [35.71, 2.3], [66.79, 2.3], [66.79, 4.840001], [66.79, 7.380001], [66.79, 9.92], [66.79, 12.46], [66.79, 15.0], [74.41, 15.0], [74.41, 12.46], [74.41, 9.92], [74.41, 7.380001], [74.41, 4.840001], [74.41, 2.3], [79.69, 2.3], [79.69, 4.840001], [79.69, 7.380001], [79.69, 9.92], [79.69, 12.46], [79.69, 15.0], [87.31, 15.0], [87.31, 12.46], [87.31, 9.92], [87.31, 7.380001], [87.31, 4.840001], [87.31, 2.3], [15.19, 2.3], [15.19, 4.840001], [15.19, 7.380001], [15.19, 9.92], [15.19, 12.46], [15.19, 15.0], [22.81, 15.0], [22.81, 12.46], [22.81, 9.92], [22.81, 7.380001], [22.81, 4.840001], [22.81, 2.3], [53.89, 2.3], [53.89, 4.840001], [53.89, 7.380001], [53.89, 9.92], [53.89, 12.46], [53.89, 15.0], [61.51, 15.0], [61.51, 12.46], [61.51, 9.92], [61.51, 7.380001], [61.51, 4.840001], [61.51, 2.3], [40.99, 2.3], [40.99, 4.840001], [40.99, 7.380001], [40.99, 9.92], [40.99, 12.46], [40.99, 15.0], [48.61, 15.0], [48.61, 12.46], [48.61, 9.92], [48.61, 7.380001], [48.61, 4.840001], [48.61, 2.3], [2.29, 2.3], [2.29, 4.840001], [2.29, 7.380001], [2.29, 9.92], [2.29, 12.46], [2.29, 15.0], [9.91, 15.0], [9.91, 12.46], [9.91, 9.92], [9.91, 7.380001], [9.91, 4.840001], [9.91, 2.3]];
union(){
 difference(){
  union(){cube([89.6,17.3,1.6]);
   translate([-18,0,0])cube([18.2,17.3,1.6]);}
  for(p=holes)translate([p[0],p[1],-.1])cylinder(h=1.8,d=1.0);
 }
 translate([-9,13.4,1.59])linear_extrude(height=.61)text("B",size=4,font="Liberation Sans:style=Bold",halign="center",valign="center");
 translate([-9,8.4,1.59])linear_extrude(height=.61)text("P12.90",size=3,font="Liberation Sans:style=Bold",halign="center",valign="center");
 translate([-9,3.8,1.59])linear_extrude(height=.61)text("+0.20",size=3,font="Liberation Sans:style=Bold",halign="center",valign="center");
}
