hmcneill46/house-rules-led-recreation/hardware/revisions/B2/printing/pitch-tests-2026-10-30/models/C_pitch_13p00.scad

// PRINT-ONLY spacing trial; not a PCB or case outline.
// Intramodule centres unchanged.1.0mm FDM holes,1.6mm base.
$fn=32;
holes=[[28.29, 2.3], [28.29, 4.840001], [28.29, 7.380001], [28.29, 9.92], [28.29, 12.46], [28.29, 15.0], [35.91, 15.0], [35.91, 12.46], [35.91, 9.92], [35.91, 7.380001], [35.91, 4.840001], [35.91, 2.3], [67.29, 2.3], [67.29, 4.840001], [67.29, 7.380001], [67.29, 9.92], [67.29, 12.46], [67.29, 15.0], [74.91, 15.0], [74.91, 12.46], [74.91, 9.92], [74.91, 7.380001], [74.91, 4.840001], [74.91, 2.3], [80.29, 2.3], [80.29, 4.840001], [80.29, 7.380001], [80.29, 9.92], [80.29, 12.46], [80.29, 15.0], [87.91, 15.0], [87.91, 12.46], [87.91, 9.92], [87.91, 7.380001], [87.91, 4.840001], [87.91, 2.3], [15.29, 2.3], [15.29, 4.840001], [15.29, 7.380001], [15.29, 9.92], [15.29, 12.46], [15.29, 15.0], [22.91, 15.0], [22.91, 12.46], [22.91, 9.92], [22.91, 7.380001], [22.91, 4.840001], [22.91, 2.3], [54.29, 2.3], [54.29, 4.840001], [54.29, 7.380001], [54.29, 9.92], [54.29, 12.46], [54.29, 15.0], [61.91, 15.0], [61.91, 12.46], [61.91, 9.92], [61.91, 7.380001], [61.91, 4.840001], [61.91, 2.3], [41.29, 2.3], [41.29, 4.840001], [41.29, 7.380001], [41.29, 9.92], [41.29, 12.46], [41.29, 15.0], [48.91, 15.0], [48.91, 12.46], [48.91, 9.92], [48.91, 7.380001], [48.91, 4.840001], [48.91, 2.3], [2.29, 2.3], [2.29, 4.840001], [2.29, 7.380001], [2.29, 9.92], [2.29, 12.46], [2.29, 15.0], [9.91, 15.0], [9.91, 12.46], [9.91, 9.92], [9.91, 7.380001], [9.91, 4.840001], [9.91, 2.3]];
union(){
 difference(){
  union(){cube([90.2,17.3,1.6]);
   translate([-18,0,0])cube([18.2,17.3,1.6]);}
  for(p=holes)translate([p[0],p[1],-.1])cylinder(h=1.8,d=1.0);
 }
 translate([-9,13.4,1.59])linear_extrude(height=.61)text("C",size=4,font="Liberation Sans:style=Bold",halign="center",valign="center");
 translate([-9,8.4,1.59])linear_extrude(height=.61)text("P13.00",size=3,font="Liberation Sans:style=Bold",halign="center",valign="center");
 translate([-9,3.8,1.59])linear_extrude(height=.61)text("+0.30",size=3,font="Liberation Sans:style=Bold",halign="center",valign="center");
}
