hmcneill46/house-rules-led-recreation/hardware/revisions/B2/printing/pitch-tests-2026-10-30/previews/spacing-trials.scad

// Native OpenSCAD preview of the actual test meshes, not a photograph.
translate([0,0,0])color([.68,.70,.72])import("../models/A_pitch_12p80.stl");
translate([0,30,0])color([.68,.70,.72])import("../models/B_pitch_12p90.stl");
translate([0,60,0])color([.68,.70,.72])import("../models/C_pitch_13p00.stl");
