hmcneill46/house-rules-led-recreation/(list of files, cad)

Other CAD files:
hardware/revisions/B2/printing/2026-10-31-confirmed-F/single-plate/sliced-projects/B2_F_AllParts_OnePlate_KE04_HyperPLA.3mf
hardware/revisions/B2/printing/fine-pitch-tests-2026-10-30/sliced-projects/LED_Pitch_DEF_Fine_KE04_HyperPLA.3mf
hardware/revisions/B2/printing/pitch-tests-2026-10-30/models/A_pitch_12p80.stl
hardware/revisions/B2/printing/pitch-tests-2026-10-30/projects/LED_Pitch_ABC_KE04_HyperPLA.3mf
hardware/revisions/B2/printing/pitch-tests-2026-10-30/sliced-projects/LED_Pitch_ABC_KE04_HyperPLA.3mf
hardware/revisions/B2/printing/sliced-projects/02_B2_Shell_KE04_HyperPLA.3mf
hardware/printing/pin-fit-KE-original.3mf
hardware/revisions/B2/printing/2026-10-31-confirmed-F/projects/02_B2_F_Shell_KE04_HyperPLA.3mf
hardware/revisions/B2/printing/fine-pitch-tests-2026-10-30/models/F_pitch_12p875.stl
hardware/revisions/B2/printing/pitch-tests-2026-10-30/models/B_pitch_12p90.stl
hardware/revisions/B2/mechanical/enclosure-B2-PROTOTYPE-shell.stl
hardware/revisions/B2/printing/2026-10-31-confirmed-F/projects/03_B2_F_BackAndCap_KE04_HyperPLA.3mf
hardware/revisions/B2/printing/2026-10-31-confirmed-F/sliced-projects/01_B2_F_FitTests_KE04_HyperPLA.3mf
hardware/revisions/B2/printing/fine-pitch-tests-2026-10-30/models/D_pitch_12p825.stl
hardware/revisions/B2/printing/pitch-tests-2026-10-30/models/C_pitch_13p00.stl
hardware/revisions/B2/printing/projects/03_B2_BackAndCap_KE04_HyperPLA.3mf
hardware/revisions/B2/printing/sliced-projects/01_B2_FitTests_KE04_HyperPLA.3mf
hardware/mechanical/enclosure-PROTOTYPE-shell.stl
hardware/revisions/B2/printing/fine-pitch-tests-2026-10-30/models/F_pitch_12p875.scad
hardware/revisions/B2/mechanical/archive-12p700-2026-10-29/enclosure-B2-PROTOTYPE-shell.stl
hardware/revisions/B2/mechanical/archive-12p700-2026-10-29/enclosure.scad
hardware/revisions/B2/mechanical/archive-12p700-2026-10-29/stock-module-values.scad
hardware/revisions/B2/printing/models/B2-main-board-fit-1p6mm.scad
hardware/revisions/B2/printing/models/B2-main-board-fit-1p6mm.stl
