hmcneill46/house-rules-led-recreation/hardware/printing/orca-fit-preview.png

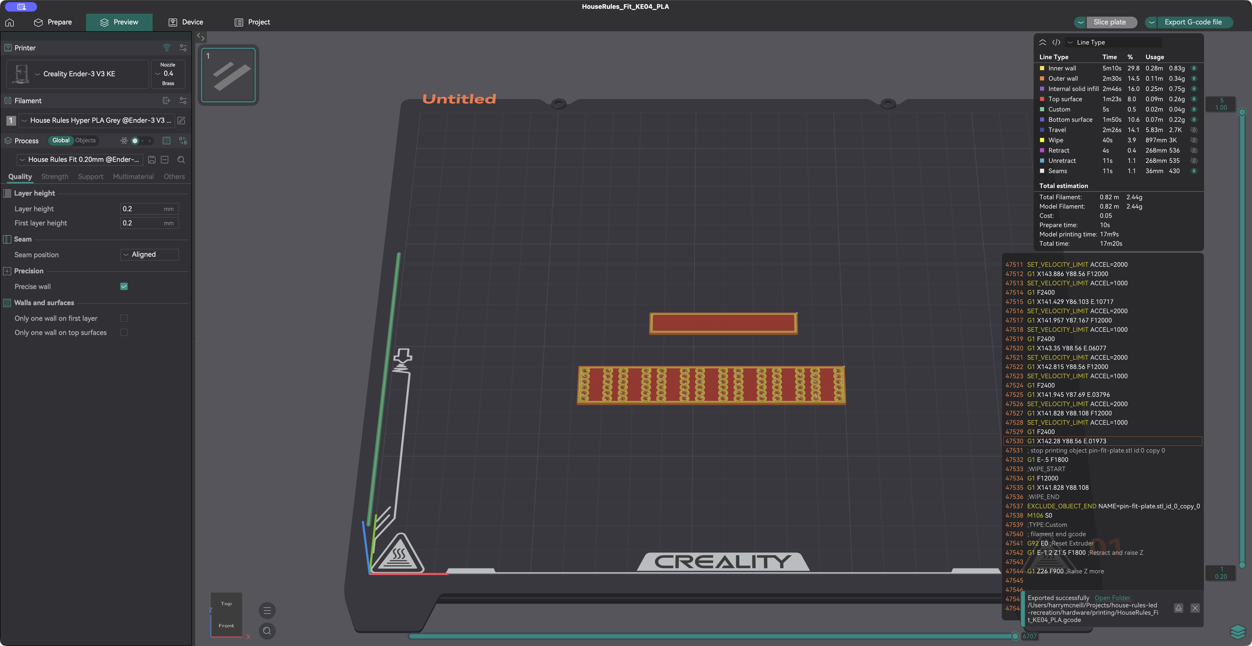
hardware/printing/orca-fit-preview.png
