hmcneill46/house-rules-led-recreation/hardware/render/assembly-guide.png

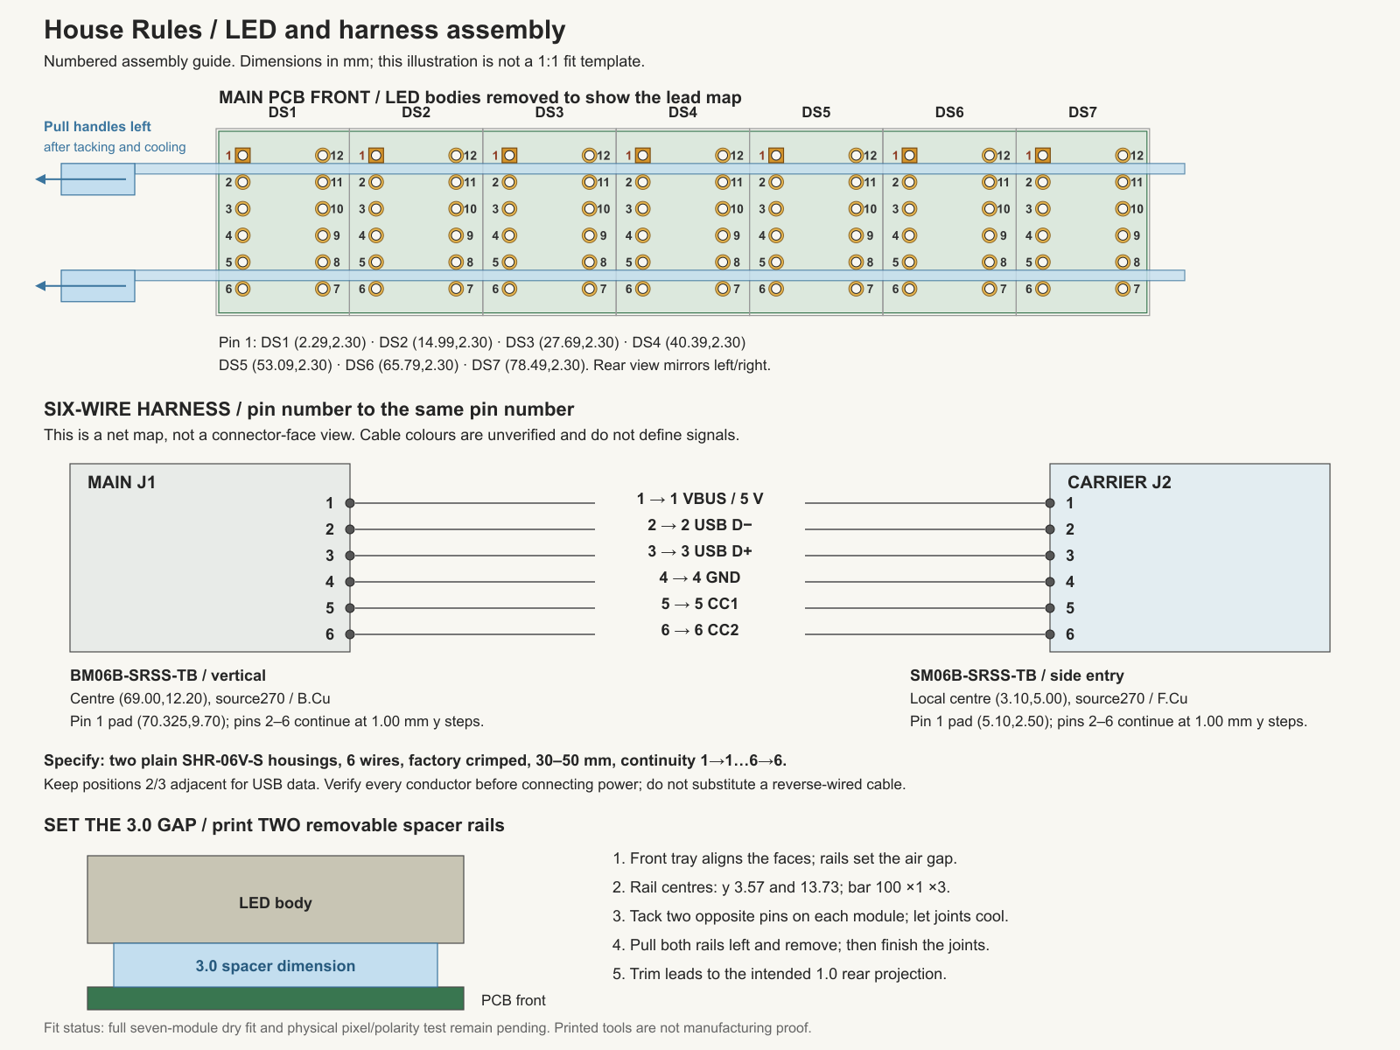
hardware/render/assembly-guide.png
