hmcneill46/house-rules-led-recreation/hardware/render/assembly-stack.png

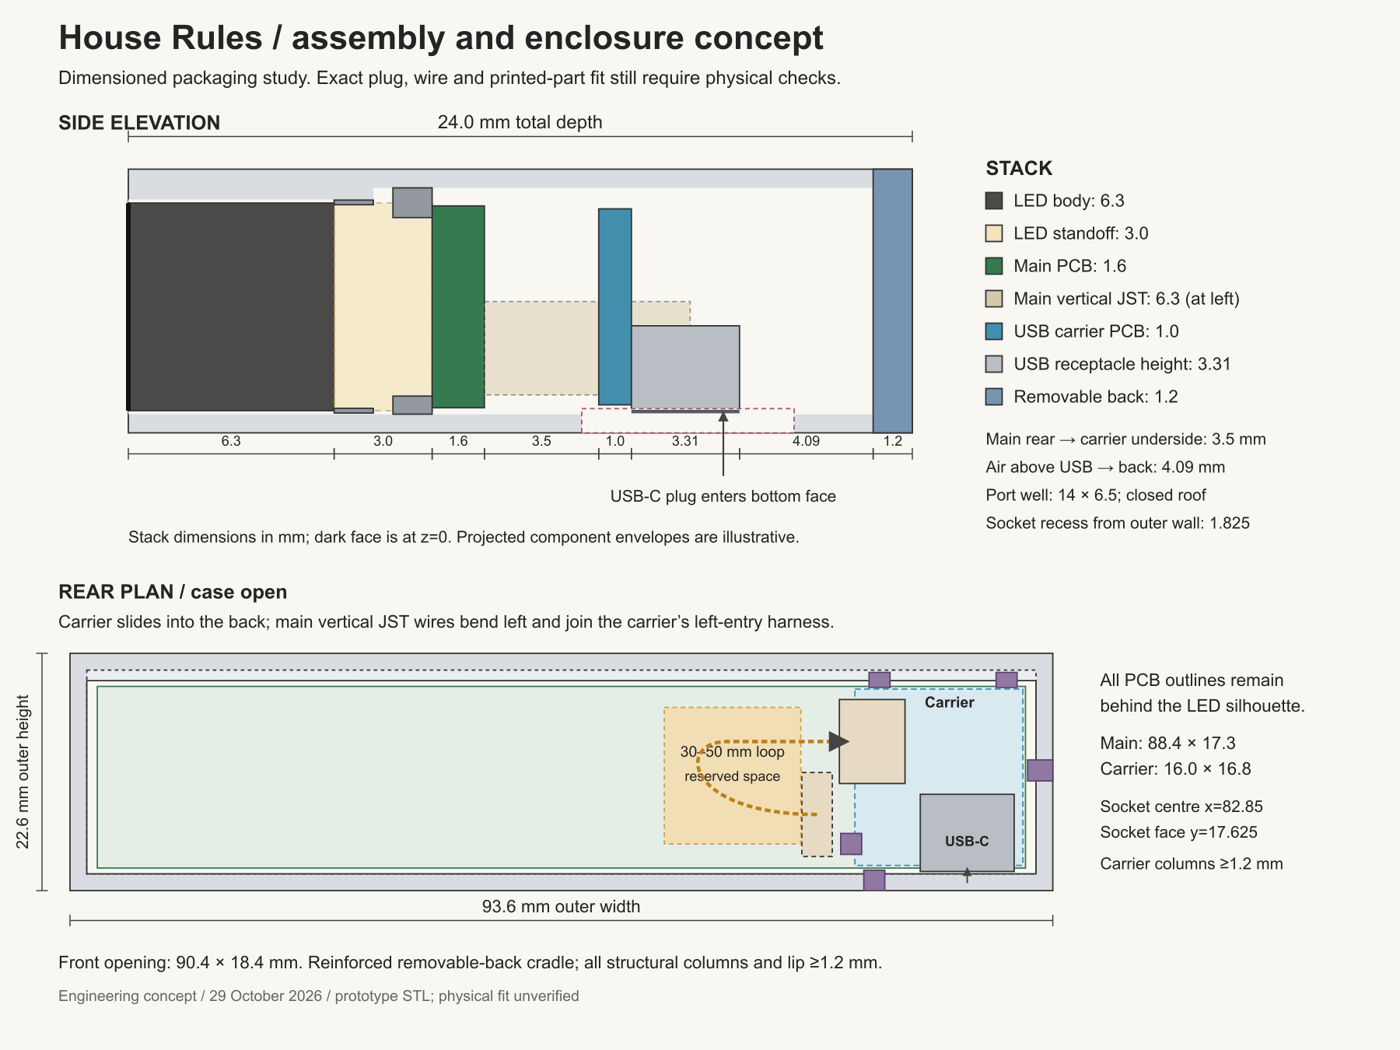
hardware/render/assembly-stack.png
