hmcneill46/house-rules-led-recreation/hardware/revisions/B2/quotes/alternatives-2026-10-31/manufacturers/evidence/pcbway-two-summary.png

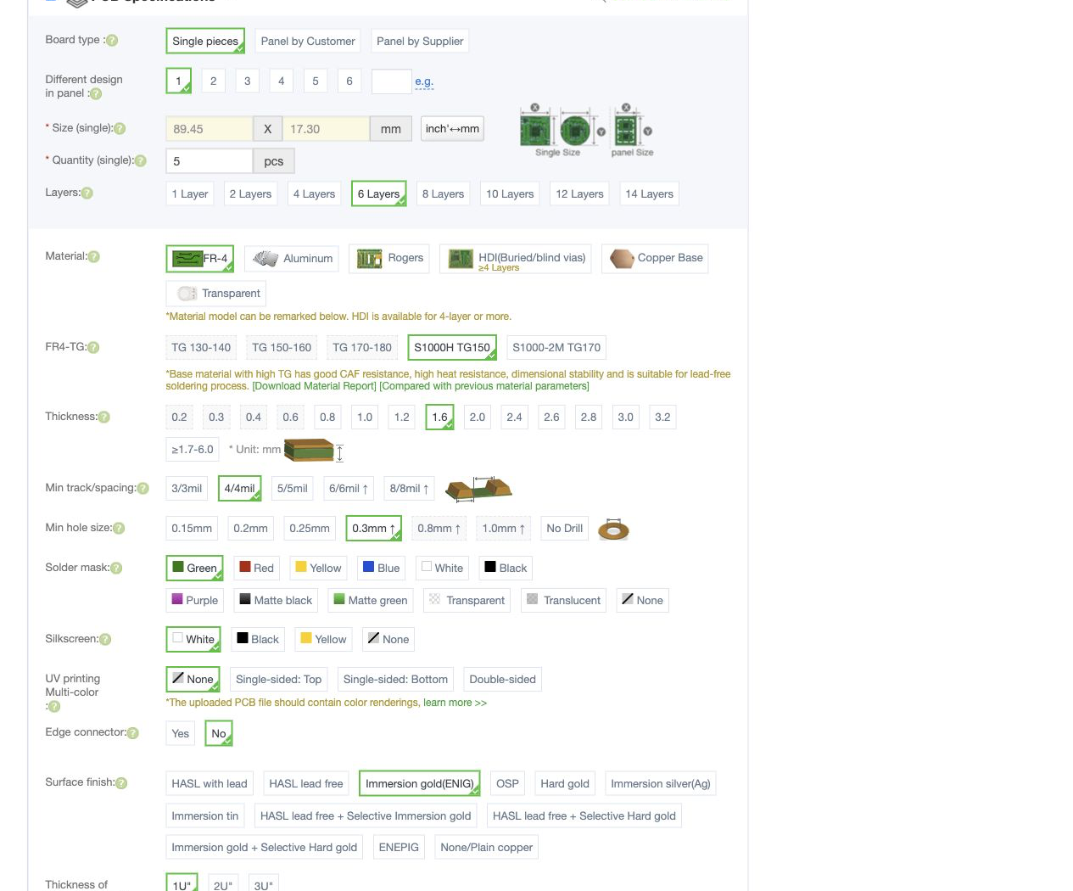
hardware/revisions/B2/quotes/alternatives-2026-10-31/manufacturers/evidence/pcbway-two-summary.png
