hmcneill46/house-rules-led-recreation/hardware/revisions/B2/quotes/cost-study-2026-10-29/evidence/4L-two-assembled-uk-vat-summary.png

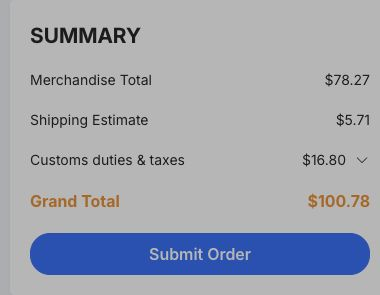
hardware/revisions/B2/quotes/cost-study-2026-10-29/evidence/4L-two-assembled-uk-vat-summary.png
