hmcneill46/house-rules-led-recreation/hardware/revisions/B2/quotes/cost-study-basic-iref-2026-10-29/evidence/6L-55-SMT-two-assembled-uk-vat.png

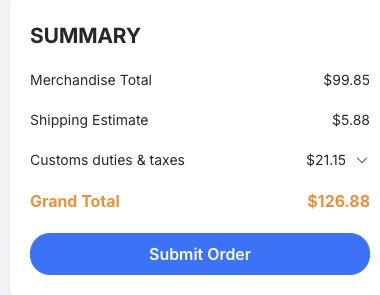
hardware/revisions/B2/quotes/cost-study-basic-iref-2026-10-29/evidence/6L-55-SMT-two-assembled-uk-vat.png
