hmcneill46/house-rules-led-recreation/hardware/revisions/B2/quotes/final-review-2026-10-29/fabrication-and-assembly.png

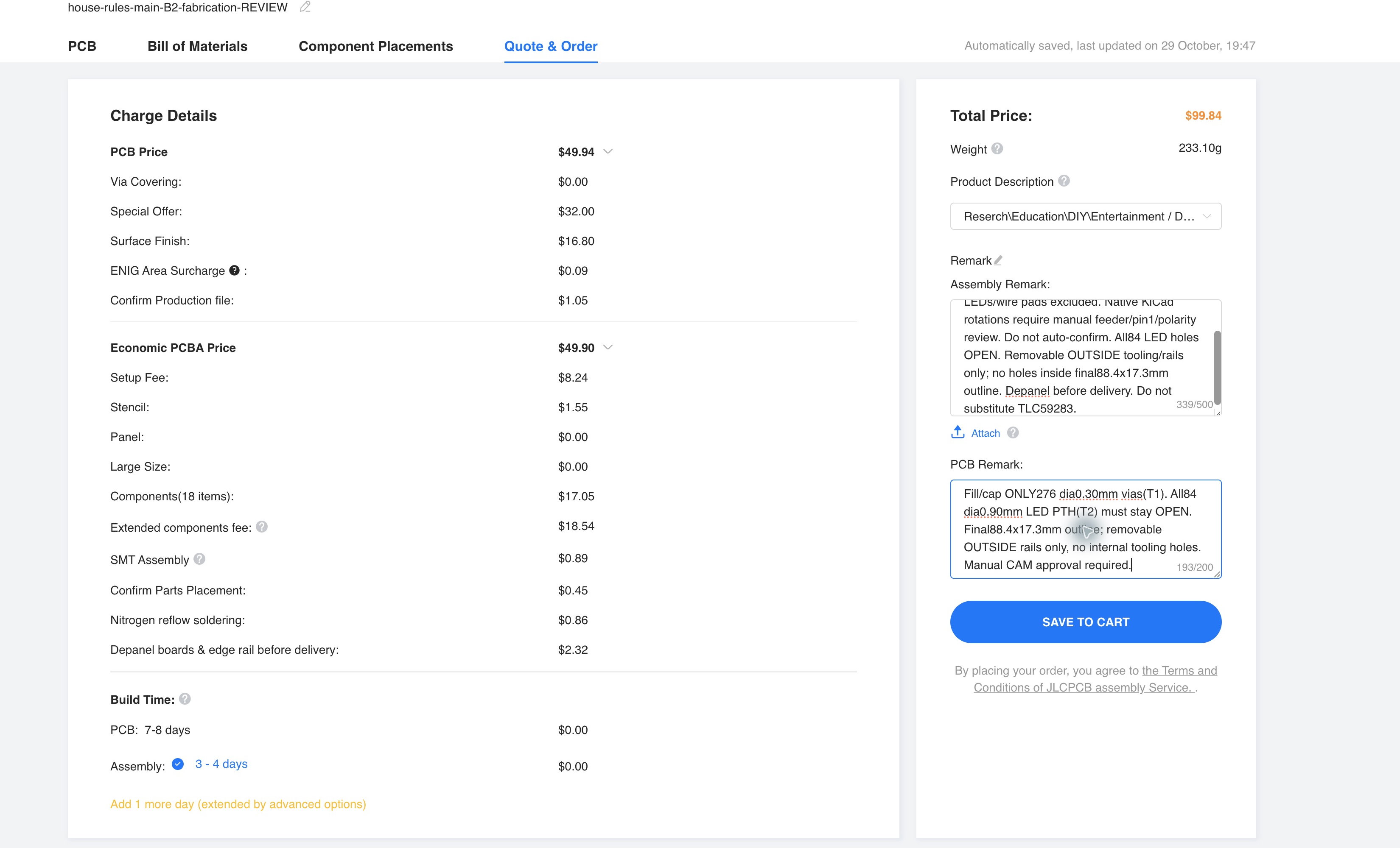
hardware/revisions/B2/quotes/final-review-2026-10-29/fabrication-and-assembly.png
