hmcneill46/house-rules-led-recreation/hardware/revisions/B2/quotes/final-review-2026-10-29/README.md

# Final routed B2 quotation — 29 October 2026

**30 October physical-fit update:** this quote preserves the original 12.70 mm-pitch design. New owner photos show a bowed seven-module fit. Do not order this saved job: complete the [spacing trials](../../printing/pitch-tests-2026-10-30/README.md), then revise/recheck the PCB/case and obtain a matching quote as needed. The quoted observations below remain historical evidence.

A fresh JLCONE draft used the actual routed review Gerbers, final 55-component BOM and bottom-side CPL. All 18 BOM groups matched. Earlier quote jobs were retained unchanged. **No order, Review Before Payment or payment was submitted.**

Five bare six-layer boards and two Economic assemblies were quoted at **$99.84**: $49.94 fabrication and $49.90 assembly, including manual file/placement review and $2.32 depaneling. [Price and review remarks](fabrication-and-assembly.png).

The saved cart unexpectedly omitted exactly $2.32 despite its service details still saying **Depanel: Yes**. Actual checkout therefore shows **$118.83**: $97.52 goods, $1.50 promotional Global Standard Direct Line delivery and $19.81 JLC-collected UK VAT, before coupons. [Checkout summary](checkout-summary-before-coupon.png).

Allowing the quoted depanel charge and its VAT gives a conservative **$121.62 delivered budget**. At the same reference exchange rate, that is approximately **£105.95 for one complete display plus a spare assembled main**, or **£113.34 for two complete displays**, including the separate stock MCU/USB modules and their estimated UK postage. Already-owned LEDs are assumed; wire, solder, screws, filament, cable, supply and tools are extra. Final CAM-reviewed fees and payment exchange rate remain authoritative.

The claimed $30 coupon appears in cart estimates; final payment-stage eligibility and VAT recalculation remain unconfirmed. It is excluded from every delivered figure above.

The selected process is six layers, green, 1.6 mm, TG135, ENIG1u and ordinary 0.30 mm drilled vias, epoxy filled and capped. Remarks explicitly require **276 filled/capped vias and 84 open 0.90 mm LED holes**, unchanged 88.4 × 17.3 mm outline, outside removable rails only and manual feeder/pin-one review. Manufacturer confirmation is still pending; this quotation is not a manufacturing release.

[Machine-readable quote](quote-summary.json) records exact inputs, inventory caveats and the depanel discrepancy. [Archive equivalence](archive-equivalence.json) verifies that the uploaded snapshot and cleaned review archive differ only in creation-timestamp metadata, with manufacturing geometry unchanged. Exact uploaded Gerber/BOM/CPL copies are retained here for provenance.
