hmcneill46/house-rules-led-recreation/hardware/revisions/B2/quotes/alternatives-2026-10-31/restock/README.md

# Restock or source the unchanged TLC59282 — 31 October 2026

**Asking JLC support is worthwhile before spending time on a redesign, but there is no published restock date to rely on.** A short enquiry could reveal an incoming shipment or a cheaper domestic pre-order. Waiting indefinitely is not a confirmed procurement plan.

JLC's official assembly FAQ says its purchasing department plans replenishment, but arrival dates can be unpredictable. It recommends checking the live catalogue. JLC and LCSC inventory/prices are separate: an LCSC stock number is not proof that JLC can assemble the part immediately, and the FAQ says it cannot simply transfer stock between those warehouse sources. Restocking can change the part price, so the old catalogue rate is not a guaranteed future price. [Official FAQ, sections 5, 6 and 11](https://jlcpcb.com/help/article/pcb-assembly-faqs-part-2).

No JLC ETA for **TLC59282RGER / C702074** or the same-device carrier variant **TLC59282RGET / C202205** was found in the inspected public official material. Parent-agent live account observations of zero stock remain the relevant availability evidence. A distributor's manufacturer lead time or expected delivery is not a JLC warehouse restock commitment.

The already-observed alternative is JLC Global Sourcing of the exact RGER from Mouser. The parent recorded 13 chips at **$25.77 including the $1 handling fee**, 20 at **$39.10**, or 25 at **$44.26**, before verified UK tax treatment. The listing estimated **10–20 business days**. These are unpaid previews, with no stock reserved. The minimum 13 covers eight installed chips plus five remaining; whether that covers JLC attrition needs confirmation. Five boards require 20 installed chips plus any factory attrition requirement. [Live evidence from this project](../../updated-F-2026-10-31/live-global-sourcing.json).

JLC requires sourced parts to reach its warehouse before selection in a PCBA order. The overview advertises 9–15 days; the detailed guide normally estimates 9–20 business days after a 1–3-business-day review. Use the specific supplier offer rather than assuming the shortest generic lead time. Sourcing and board assembly are separate transactions. [Sourcing guide](https://jlcpcb.com/help/article/how-to-use-jlcpcb-global-sourcing-parts-service), [overview](https://jlcpcb.com/help/article/pcba-parts-sourcing-instruction).

Pre-order is also a supported route for an out-of-stock extended part, but can impose a minimum quantity. JLC says its final part price may only be confirmed within 48 hours **after initial payment**, leading to a refund or top-up. That process therefore cannot establish a guaranteed final total while retaining the current no-purchase instruction. Parts must arrive before assembly; refunds/cancellation are restricted. [Service explanation](https://jlcpcb.com/help/article/what-is-jlcpcb-parts-pre-order-service), [terms](https://jlcpcb.com/help/article/pre-ordering-parts-terms-conditions).

The [ready-to-send enquiry](support-enquiry-draft.txt) asks the decision-making questions. It has **not been sent**. The official contact page offers online chat/email and describes replies typically within hours during its published support hours. Sending a message, creating a restock notification or submitting a New Parts Request would modify external state; none was done for this research. A New Parts Request is intended for an unlisted part, whereas these two parts are already listed. [Contact options](https://jlcpcb.com/help/contact).

The useful decision is: retain the current PCB if JLC confirms a reasonably prompt, affordable exact-part supply; use a verified in-stock equivalent only after electrical/footprint review; compare another manufacturer's complete quote if either JLC path loses its price advantage. No PCB, case, firmware, procurement order or factory release was changed here.
# Subsequent live enquiry

The owner later authorised contacting JLC. Support confirmed that no restock schedule is available. A quotation-only sourcing request for the two exact QFN carrier options was submitted and verified in Quote History as **Quoting, 0/2 parts quoted**. This did not place an order or buy any parts. See [live outcome](live-support-outcome.json); the earlier research/draft below records the information available before contact.
