hmcneill46/house-rules-led-recreation/hardware/revisions/B2/quotes/updated-F-2026-10-31/retail/README.md

# UK retail parts and supplies — B2 / F12.875 mm

Checked 31 October 2026, updated after the owner confirmed their existing equipment. **Actual new retail spending is £53.20 for two complete displays, £65.09 for three, or £118.86 for five.** These amounts include VAT and UK-mainland delivery allowances. Add the separately verified JLCPCB custom-board and assembly quote. No order or payment was submitted.

| Complete displays | Actual new retail spending | If the 1.3 mm hex key is already owned | Buy-all supplies reference, using the same cheaper sourcing |
|---|---:|---:|---:|
| 2 | **£53.20** | £52.70 | £83.30 |
| 3 | **£65.09** | £64.59 | £102.89 |
| 5 | **£118.86** | £118.36 | £172.06 |

The primary totals use the owner's confirmed iron and stand, solder and flux, wire strippers and cutters, suitable USB power supplies, and USB-C cables: **£0 new spending on these**. A data-capable USB cable is still required for programming. One 50p 1.3 mm hex key is included because ownership of that particular size is unconfirmed. The owner also has a multimeter, printer, grey Hyper PLA and 21 LED modules. Five complete displays need **14 additional LEDs**; two or three need none.

The buy-all reference includes a separate suitable UK PSU per display, one shared data cable and whole solder/flux purchases. It includes the same 50p key. A completely new assembly tool set would add another £33.30 to that reference, excluding the key already counted. Those tools are owned and are **not** charged in the primary quote.

## Actual purchases

| Purchase | 2 displays | 3 displays | 5 displays |
|---|---:|---:|---:|
| [Headerless Seeed XIAO RP2040 Plus, exact SKU 100059977](https://www.unmannedtechshop.co.uk/products/seeed-studio-xiao-rp2040-plus), £4.49 each including VAT | 2 | 3 | 5 |
| [Adafruit 4090 downstream USB-C breakout](https://thepihut.com/products/adafruit-usb-c-breakout-board-downstream-connection-ada4090), £2.90 each including VAT | 2 | 3 | 5 |
| [28 AWG stranded PTFE wire](https://thesaberarmory.com/products/28awg-ptfe-bs-spec-hook-up-wire-1-metre-lengths), £1.80/m with VAT | 1 m red + 1 m black + 2 m blue | 1 m red + 1 m black + 3 m blue | 1 m red + 1 m black + 5 m blue |
| [M2 ISO 7380-1 button screws](https://boltbase.com/products/m2-self-colour-10-9-high-tensile-socket-button-head-screws-iso-7380-1), £0.90 each including VAT | 4 × 6 mm, 2 × 8 mm | 6 × 6 mm, 3 × 8 mm | 10 × 6 mm, 5 × 8 mm |
| [1.3 mm DIN 911 short hex key](https://boltbase.com/products/1-3mm-metric-short-arm-hex-keys-din-911), £0.50 | 1 shared | 1 shared | 1 shared |
| [Chip Quik EGS10C-20G clear electronics-grade silicone, CPC SA03781](https://cpc.farnell.com/chip-quik/egs10c-20g/silicone-adhesive-sealant-20g/dp/SA03781), £3.92 excluding VAT, approximately £4.70 including VAT | 1 tube | 1 tube | 1 tube |
| [Pro Power PP01582 cable ties, 100 × 2.5 mm, pack of 100](https://cpc.farnell.com/pro-power/pp01582/cable-tie-100x2-5mm-blk-100pk/dp/CBBR6697?gross_price=true), £0.62 including VAT | 1 pack | 1 pack | 1 pack |
| [Extra LMD07057AUE-101B-02 raw LED modules](https://www.switchelectronics.co.uk/products/red-5-x-7-dot-matrix-led-display-17-8x12-7mm), £1.80 each with VAT | 0 | 0 | 14 |

Whole tubes, packs and metre lengths are counted. This is the cash needed to purchase the batch, rather than dividing the cost of a pack by the small amount used.

## Delivered baskets

| Retailer | 2 displays | 3 displays | 5 displays | Included delivery and evidence |
|---|---:|---:|---:|---|
| Unmanned Tech | £12.57 | £17.06 | £26.04 | Exact controllers; fresh anonymous quantity carts; £3.59 Standard |
| The Pi Hut | £9.60 | £12.50 | £18.30 | Exact USB breakout boards only; fresh anonymous quantity carts; £3.80 Royal Mail tracked |
| The Saber Armory | £11.40 | £13.20 | £16.80 | Exact colour/metre purchases; goods VAT checked; £3.50 shipping budgeted as £4.20 with VAT |
| Bolt Base | £9.80 | £12.50 | £17.90 | Exact screws + one 1.3 mm key; fresh combined carts; £3.90 Tracked 48 |
| CPC | £9.83 | £9.83 | £9.83 | One tube + one tie pack; £3.75 ex-VAT online small-order charge, £4.50 with VAT |
| Switch Electronics | — | — | £29.99 | 14 new LEDs; goods VAT checked; £3.99 shipping budgeted as £4.79 with VAT |
| **Actual new retail spending, excluding custom PCB** | **£53.20** | **£65.09** | **£118.86** | |

**Price certainty:** UMT, Pi Hut and Bolt Base use exact live cart quantities and the merchant's shipping-rate endpoint. Saber and Switch goods VAT were checked in fresh anonymous UK checkout summaries: £6 wire becomes £7.20 and £21 LEDs becomes £25.20 before shipping. Their shipping VAT is a conservative 20% allowance; final private-address checkout was not completed. CPC is a primary-catalogue and published-delivery-policy budget, rather than a locked checkout quote. Its clear silicone page showed 320 tubes in stock and its tie page 5,039 packs. Direct HTTP access to its product pages was blocked, so CPC catalogue data comes from the merchant pages returned through web browsing. Prices/availability should be refreshed when actually placing orders.

## Cheaper strain relief, with the same assembly method

CPC reduces the shared adhesive/tie basket from the earlier **£18.48 Farnell allowance to £9.83 delivered**, saving **£8.65 for every batch size**. The calculation is £3.92 adhesive + £0.52 ties + £3.75 online small-order handling = £8.19 excluding VAT, or £9.828 rounded to £9.83 including VAT. Separate unit-VAT rounding could make the final bill 1p lower. The online handling charge is stated in [CPC's purchase terms](https://cpc.farnell.com/terms-of-purchase); no express delivery is selected.

The clear EGS10C-20G is an electronics-grade, non-corrosive, non-conductive, flexible silicone intended for corrosion-sensitive electronics. It replaces the hidden white EGS bead in procurement; the [manufacturer lists both in the same EGS range](https://www.chipquik.com/store/index.php?cPath=490_492). After electrical checks, use a small bead to retain the insulated loom to main-board soldermask, away from pads and components, as the current assembly guide requires. The printed rear-cover anchor and cable tie remain necessary. Allow the bead to cure before moving the loom; keep it small enough to cut or peel away carefully for servicing.

This does not change CAD or remove the main-board pad protection. Tape by itself was not substituted: its resistance to peeling by this loom has not been physically qualified. Ordinary acetic-cure bathroom silicone was not substituted either. The cheaper black/white CPC EGS tubes were on backorder, so the in-stock clear tube is used. The new 2.5 mm ties fit the existing 2.7 mm passage; Pi Hut's in-stock 180 mm ties are 4.6 mm wide and unsuitable.

## Fit and assembly requirements retained

The selected wire is 28 AWG stranded (7/0.120 mm), maximum outside diameter **0.71 mm**. It retains the preferred power-wire gauge and fits the existing space reservation. Start with about 14 × 70 mm MCU wires and 6 × 45 mm USB wires per display, then trim after a dry fit. The bought lengths leave a modest spare allowance. Keep D+/D− short, adjacent and twisted as the existing assembly guide specifies. Typical cheap 28 AWG silicone wire with 1.2 mm outside diameter was rejected.

Screw heads must stay within **4.0 mm diameter / 1.5 mm height**. The specified M2 button screws need the 1.3 mm key. Generic M2 DIN 7985 pan heads can be 1.6 mm high and were not substituted. Screw quantity promotions were investigated, but the actual carts returned zero discount, so none is deducted. CPC's 50-piece button-screw packs were also checked and cost more than the required small quantities from Bolt Base.

Factory assembly covers the small parts on the custom main PCB. The owner still fits the seven LEDs, solders the 20-wire loom and assembles the case: approximately **84 LED joints + 40 wire joints per display**, followed by inspection, electrical checks and firmware loading. Purchased stock modules and the actual USB plug need the receipt checks in the assembly guide. Alignment jigs and 3 mm spacers can use the already-owned filament. No purchased spacer kit or extra filament spool is charged.

## Owned requirements and buy-all references

These links remain useful specifications, but **buying these again is unnecessary with the owner's confirmed inventory**:

| Requirement | Reference purchase | Primary new spending |
|---|---|---:|
| Suitable 5 V USB power for each independent display | [Official Raspberry Pi 15 W UK PSU](https://thepihut.com/products/raspberry-pi-psu-uk), SC0443, 5.1 V 3 A, £7.70 each; captive 1.5 m USB-C lead | £0 |
| A USB-C data cable for programming | [50 cm USB-C to USB-C data cable](https://thepihut.com/products/usb-c-to-usb-c-cable-1m), £2.50 shared | £0 |
| Solder | [Antex 0.8 mm lead-free, 4 m tube](https://thepihut.com/products/antex-lead-free-solder), £4.40 | £0 |
| Flux | [Future 315 no-clean pen](https://thepihut.com/products/flux-pen-future-315-low-residue-no-clean), £7.80 | £0 |
| Temperature-controlled iron | [YIHUA 928D-I 65 W UK mains iron](https://kunkune.co.uk/shop/soldering-iron-kits/yihua-928d-i-soldering-iron-65w-uk-plug/), £16.90 + £2.90 delivery | £0 |
| Stand | [Pi Hut iron stand](https://thepihut.com/products/soldering-iron-bench-stand), £4.00 | £0 |
| Fine wire stripping | [20–30 AWG strippers](https://thepihut.com/products/wire-strippers), £6.00 | £0 |
| Lead/wire trimming | [Precision diagonal cutters](https://thepihut.com/products/precision-diagonal-cutters), £3.50 | £0 |

The design uses 5 V USB power and does not request a higher PD voltage. Use suitable owned supplies and test both USB-C orientations during bring-up. Use a known data-capable cable for UF2 programming through the external socket. None of this changes the firmware or hardware design.

## Evidence and history

- `retail-quote-summary.json`: current owner-inventory scenario, item links, quantities and calculations.
- `cpc-strain-relief-evidence.json`: cheaper electronics-grade silicone/ties and published shipping calculation.
- `live-module-shipping.json`: current controller/USB-only quantity carts and shipping.
- `live-owner-inventory-screw-key-shipping.json`: fresh exact screws plus one key carts.
- `live-wire-shipping.json`: exact whole-metre colour baskets.
- `tax-evidence.json`: merchant tax evidence; its original Farnell entry describes the superseded reference supplier.
- `README-before-owner-inventory.md` and `retail-quote-summary-before-owner-inventory.json`: preserved earlier buy-all/Farnell research before the owner confirmed inventory.
- Other `live-*` files retain the original buy-all basket checks, including unsuccessful bulk-discount tests and optional-tool evidence. They are reference history, not instructions to buy owned supplies again.

This is procurement research for the current prototype. No order, payment, account signup, vendor message, CAD edit or change to the assembly contract was made.
