hmcneill46/house-rules-led-recreation/hardware/revisions/B2/quotes/alternatives-2026-10-31/evidence/TLC59281-five-factory-quote.jpg

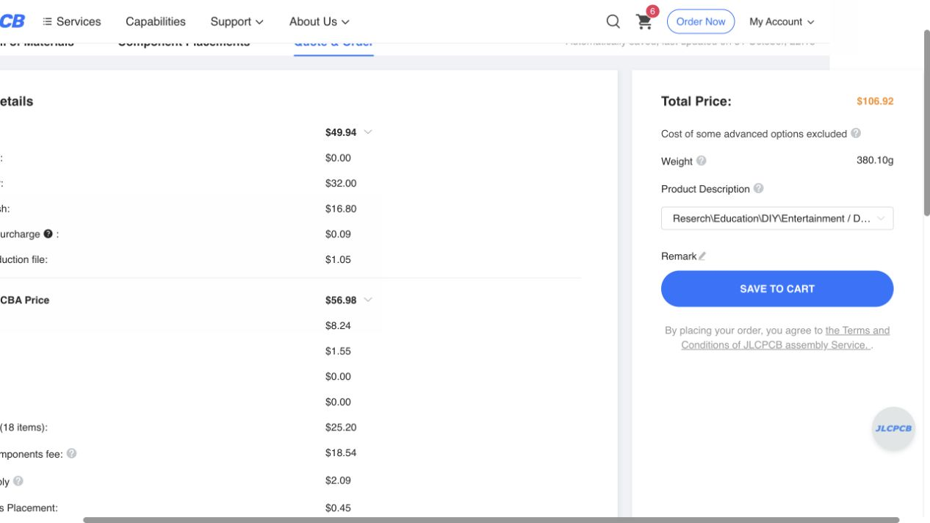
hardware/revisions/B2/quotes/alternatives-2026-10-31/evidence/TLC59281-five-factory-quote.jpg
