hmcneill46/house-rules-led-recreation/hardware/revisions/B2/quotes/alternatives-2026-10-31/evidence/TLC59281-five-web-delivered-summary.jpg

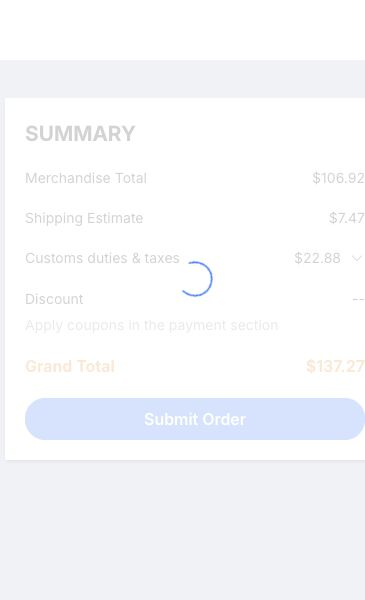
hardware/revisions/B2/quotes/alternatives-2026-10-31/evidence/TLC59281-five-web-delivered-summary.jpg
