hmcneill46/house-rules-led-recreation/hardware/revisions/B2/quotes/alternatives-2026-10-31/evidence/TLC59283-7p15k-five-native-summary.png

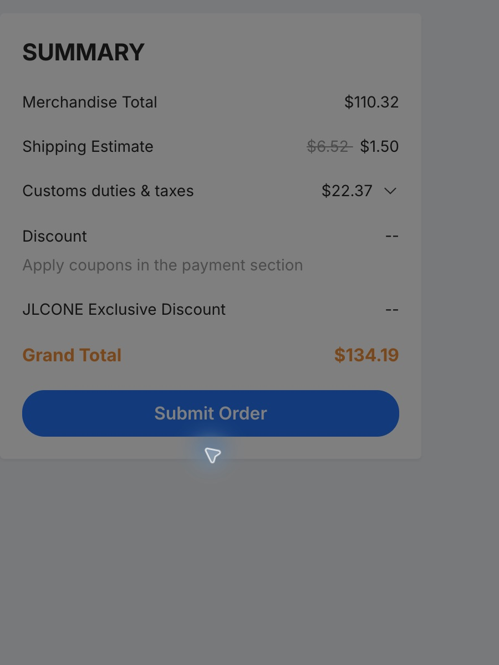
hardware/revisions/B2/quotes/alternatives-2026-10-31/evidence/TLC59283-7p15k-five-native-summary.png
