hmcneill46/house-rules-led-recreation/hardware/revisions/B2/quotes/updated-F-2026-10-31/evidence/driver-stock-zero.jpg

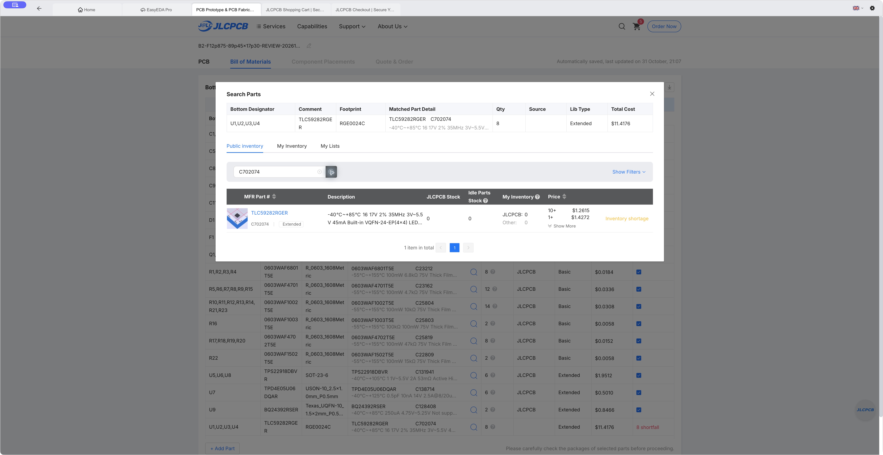
hardware/revisions/B2/quotes/updated-F-2026-10-31/evidence/driver-stock-zero.jpg
