hmcneill46/house-rules-led-recreation/hardware/revisions/B2/quotes/updated-F-2026-10-31/evidence/two-INCOMPLETE-quote.jpg

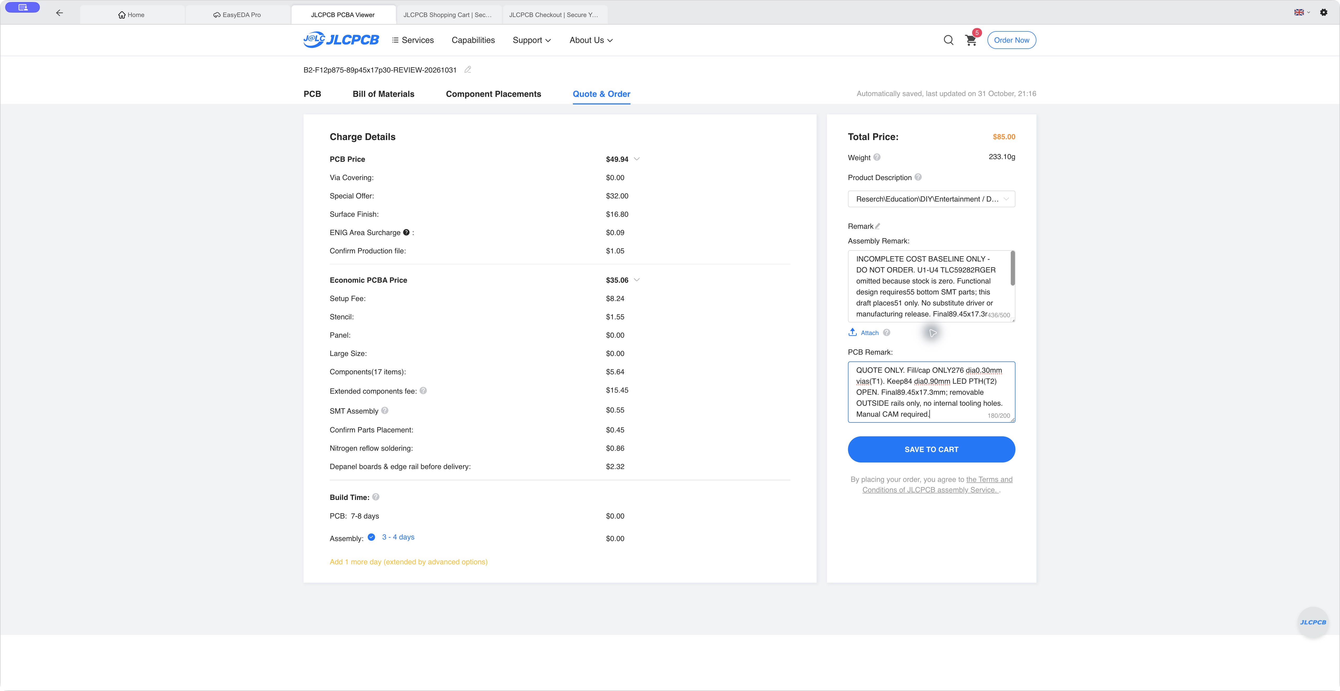
hardware/revisions/B2/quotes/updated-F-2026-10-31/evidence/two-INCOMPLETE-quote.jpg
