hmcneill46/house-rules-led-recreation/hardware/revisions/B2/render/main-top.png

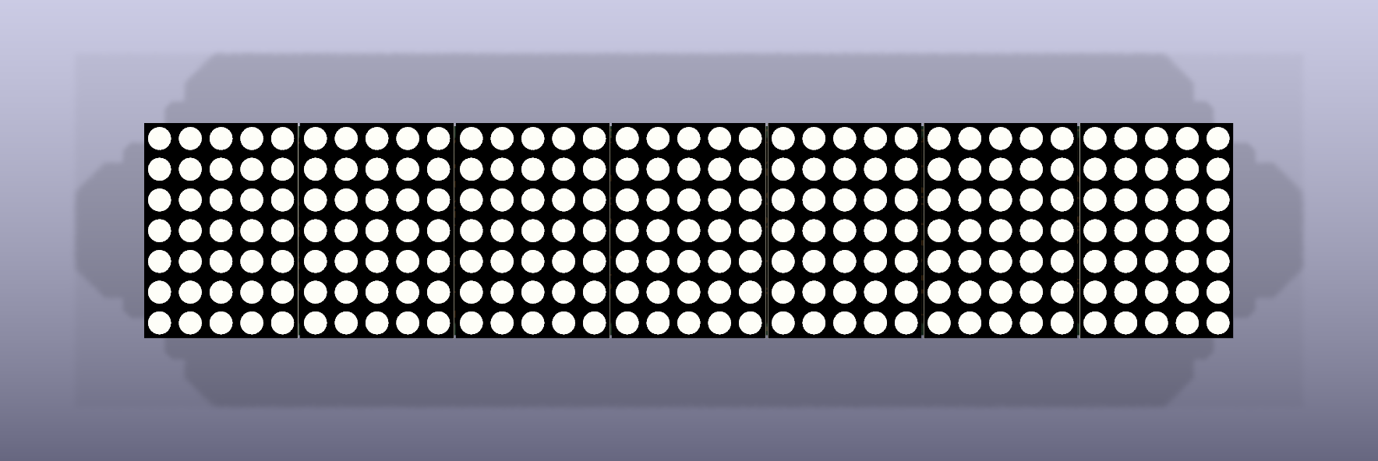
hardware/revisions/B2/render/main-top.png
