hmcneill46/house-rules-led-recreation/(list of files, drawings)

Other design files:
hardware/kicad/house-rules-main-close.dsn
hardware/kicad/house-rules-main-planes.dsn
hardware/kicad/house-rules-main.dsn
hardware/kicad/house-rules-usb.dsn
hardware/reports/schematic-verification-design-review.json
hardware/reports/schematic-verification-main.erc.json
hardware/reports/schematic-verification-summary.json
hardware/reports/schematic-verification-usb.erc.json
hardware/revisions/B2/kicad/house-rules-main-B2-6L.dsn
hardware/revisions/B2/kicad/house-rules-main-B2.dsn
hardware/revisions/B2/reports/confirmed-F-2026-10-31/software-before/reports/schematic-verification-summary.json
hardware/revisions/B2/reports/schematic-verification-summary.json
hardware/revisions/B2/routing-experiments/escaped4.dsn
hardware/revisions/B2/routing-experiments/grounded4.dsn
