hmcneill46/house-rules-led-recreation/hardware/revisions/B2/manufacturing/B2_F_TLC59283_7p15k_review_2026-10-31/source/house-rules-main-B2.kicad_pcb

## KiCad design hardware/revisions/B2/manufacturing/B2_F_TLC59283_7p15k_review_2026-10-31/source/house-rules-main-B2.kicad_pcb (2026-10-31)

Schematic: house-rules-main-B2.kicad_sch, House Rules B2 / LED carrier, power and interface

Parts:
C1, C2, C3, C4, C15: 100n 50V X7R; C_0603_1608Metric; MPN CC0603KRX7R9BB104; LCSC C14663
C5, C6, C7, C14, C16: 1u 50V X5R; C_0603_1608Metric; MPN CL10A105KB8NNNC; LCSC C15849
C8: 4u7 16V X5R; C_0603_1608Metric; MPN CL10A475KO8NNNC; LCSC C19666
C9, C10, C13: 1n 50V X7R; C_0603_1608Metric; MPN CL10B102KB8NNNC; LCSC C1588
C11, C12: 10n 50V X7R; C_0603_1608Metric; MPN 0603B103K500NT; LCSC C57112
D1: SMF5.0A; D_SOD-123F; MPN SMF5.0A; LCSC C151296
DS1, DS2, DS3, DS4, DS5, DS6, DS7: LMD07057AUE-101B; MPN LMD07057AUE-101B
F1: 750mA PPTC; Fuse_1206_3216Metric; MPN SMD1206B075TF/16; LCSC C269118
J1: +5V; WirePad_B2; MPN +5V
J2, J14: GND; WirePad_B2; MPN GND
J3: +3V3; WirePad_B2; MPN +3V3
J4: SIN; WirePad_B2; MPN SIN
J5: SCLK; WirePad_B2; MPN SCLK
J6: LAT; WirePad_B2; MPN LAT
J7: BLANK; WirePad_B2; MPN BLANK
J8: DRIVER_EN; WirePad_B2; MPN DRIVER_EN
J9: CC1_ADC; WirePad_B2; MPN CC1_ADC
J10: CC2_ADC; WirePad_B2; MPN CC2_ADC
J11: USB_DM_HOST; WirePad_B2; MPN USB_DM_HOST
J12: USB_DP_HOST; WirePad_B2; MPN USB_DP_HOST
J13: VBUS; WirePad_B2; MPN VBUS
J15: CC1; WirePad_B2; MPN CC1
J16: CC2; WirePad_B2; MPN CC2
J17: USB_DM; WirePad_B2; MPN USB_DM
J18: USB_DP; WirePad_B2; MPN USB_DP
J19: BC_DET; WirePad_B2; MPN BC_DET
J20: BC_AL_N; WirePad_B2; MPN BC_AL_N
Q1, Q2, Q3, Q4, Q5: AO3401A; SOT-23; MPN AO3401A; LCSC C15127
R1, R2, R3, R4: 7k15 1%; R_0603_1608Metric; MPN 0603WAF7151T5E; LCSC C25980
R5, R6, R7, R8, R9, R15: 4k7 1%; R_0603_1608Metric; MPN 0603WAF4701T5E; LCSC C23162
R10, R11, R12, R13, R14, R21, R23: 10k 1%; R_0603_1608Metric; MPN 0603WAF1002T5E; LCSC C25804
R16: 100k 1%; R_0603_1608Metric; MPN 0603WAF1003T5E; LCSC C25803
R17, R18, R19, R20: 47k 1%; R_0603_1608Metric; MPN 0603WAF4702T5E; LCSC C25819
R22: 15k 1%; R_0603_1608Metric; MPN 0603WAF1502T5E; LCSC C22809
U1, U2, U3, U4: TLC59283RGER; RGE0024C; MPN TLC59283RGER; LCSC C485815
U5, U6, U8: TPS22918DBVR; SOT-23-6; MPN TPS22918DBVR; LCSC C131941
U7: TPD4E05U06DQAR; USON-10_2.5x1.0mm_P0.5mm; MPN TPD4E05U06DQAR; LCSC C138714
U9: BQ24392RSER; Texas_UQFN-10_1.5x2mm_P0.5mm; MPN BQ24392RSER; LCSC C128408

Connections:
+3V3: C5.1, J3.1, R23.2, U5.1 (VIN), U9.5 (GOOD_BAT)
+5V: C6.1, C15.1, C16.1, J1.1, U6.1 (VIN), U8.5 (QOD), U8.6 (VOUT), U9.9 (VBUS)
BC_AL_N: J20.1, R23.1, U9.4 (CHG_AL_N)
BC_DET: J19.1, R21.2, R22.1
BC_DET_5V: R21.1, U9.10 (CHG_DET)
BLANK: J7.1, R15.1, U1.18 (BLANK), U2.18 (BLANK), U3.18 (BLANK), U4.18 (BLANK)
CC1: J15.1, R17.1, U7.4, U7.7
CC1_ADC: C11.1, J9.1, R17.2, R18.1
CC2: J16.1, R19.1, U7.5, U7.6
CC2_ADC: C12.1, J10.1, R19.2, R20.1
COL1_A: DS1.1, DS2.1, DS3.1, DS4.1, DS5.1, DS6.1, DS7.1, Q1.3 (D), R10.1
COL1_GATE: Q1.1 (G), R5.1, U4.9 (OUT7)
COL2_A: DS1.3, DS2.3, DS3.3, DS4.3, DS5.3, DS6.3, DS7.3, Q2.3 (D), R11.1
COL2_GATE: Q2.1 (G), R6.1, U4.10 (OUT8)
COL3_A: DS1.10, DS2.10, DS3.10, DS4.10, DS5.10, DS6.10, DS7.10, Q3.3 (D), R12.1
COL3_GATE: Q3.1 (G), R7.1, U4.11 (OUT9)
COL4_A: DS1.7, DS2.7, DS3.7, DS4.7, DS5.7, DS6.7, DS7.7, Q4.3 (D), R13.1
COL4_GATE: Q4.1 (G), R8.1, U4.12 (OUT10)
COL5_A: DS1.8, DS2.8, DS3.8, DS4.8, DS5.8, DS6.8, DS7.8, Q5.3 (D), R14.1
COL5_GATE: Q5.1 (G), R9.1, U4.13 (OUT11)
CT_3V3: C9.1, U5.4 (CT)
CT_5V: C10.1, U6.4 (CT)
CT_INPUT: C13.1, U8.4 (CT)
D1_ROW1_K: DS1.12, U1.2 (OUT0)
D1_ROW2_K: DS1.11, U1.3 (OUT1)
D1_ROW3_K: DS1.2, U1.4 (OUT2)
D1_ROW4_K: DS1.9, U1.5 (OUT3)
D1_ROW5_K: DS1.4, U1.6 (OUT4)
D1_ROW6_K: DS1.5, U1.7 (OUT5)
D1_ROW7_K: DS1.6, U1.8 (OUT6)
D1_ROW8_K: DS2.12, U1.9 (OUT7)
D1_ROW9_K: DS2.11, U1.10 (OUT8)
D1_ROW10_K: DS2.2, U1.11 (OUT9)
D1_ROW11_K: DS2.9, U1.12 (OUT10)
D1_ROW12_K: DS2.4, U1.13 (OUT11)
D1_ROW13_K: DS2.5, U1.14 (OUT12)
D1_ROW14_K: DS2.6, U1.15 (OUT13)
D2_ROW1_K: DS3.12, U2.2 (OUT0)
D2_ROW2_K: DS3.11, U2.3 (OUT1)
D2_ROW3_K: DS3.2, U2.4 (OUT2)
D2_ROW4_K: DS3.9, U2.5 (OUT3)
D2_ROW5_K: DS3.4, U2.6 (OUT4)
D2_ROW6_K: DS3.5, U2.7 (OUT5)
D2_ROW7_K: DS3.6, U2.8 (OUT6)
D2_ROW8_K: DS4.12, U2.9 (OUT7)
D2_ROW9_K: DS4.11, U2.10 (OUT8)
D2_ROW10_K: DS4.2, U2.11 (OUT9)
D2_ROW11_K: DS4.9, U2.12 (OUT10)
D2_ROW12_K: DS4.4, U2.13 (OUT11)
D2_ROW13_K: DS4.5, U2.14 (OUT12)
D2_ROW14_K: DS4.6, U2.15 (OUT13)
D3_ROW1_K: DS5.12, U3.2 (OUT0)
D3_ROW2_K: DS5.11, U3.3 (OUT1)
D3_ROW3_K: DS5.2, U3.4 (OUT2)
D3_ROW4_K: DS5.9, U3.5 (OUT3)
D3_ROW5_K: DS5.4, U3.6 (OUT4)
D3_ROW6_K: DS5.5, U3.7 (OUT5)
D3_ROW7_K: DS5.6, U3.8 (OUT6)
D3_ROW8_K: DS6.12, U3.9 (OUT7)
D3_ROW9_K: DS6.11, U3.10 (OUT8)
D3_ROW10_K: DS6.2, U3.11 (OUT9)
D3_ROW11_K: DS6.9, U3.12 (OUT10)
D3_ROW12_K: DS6.4, U3.13 (OUT11)
D3_ROW13_K: DS6.5, U3.14 (OUT12)
D3_ROW14_K: DS6.6, U3.15 (OUT13)
D4_ROW1_K: DS7.12, U4.2 (OUT0)
D4_ROW2_K: DS7.11, U4.3 (OUT1)
D4_ROW3_K: DS7.2, U4.4 (OUT2)
D4_ROW4_K: DS7.9, U4.5 (OUT3)
D4_ROW5_K: DS7.4, U4.6 (OUT4)
D4_ROW6_K: DS7.5, U4.7 (OUT5)
D4_ROW7_K: DS7.6, U4.8 (OUT6)
DRIVER_EN: J8.1, R16.1, U5.3 (ON), U6.3 (ON)
FUSED_VBUS: C14.1, F1.2, U8.1 (VIN), U8.3 (ON)
GND: C1.2, C2.2, C3.2, C4.2, C5.2, C6.2, C7.2, C8.2, C9.2, C10.2, C11.2, C12.2, C13.2, C14.2, C15.2, C16.2, D1.2, J2.1, J14.1, R1.2, R2.2, R3.2, R4.2, R10.2, R11.2, R12.2, R13.2, R14.2, R16.2, R18.2, R20.2, R22.2, U1.22 (GND), U1.25 (EP_GND), U2.22 (GND), U2.25 (EP_GND), U3.22 (GND), U3.25 (EP_GND), U4.22 (GND), U4.25 (EP_GND), U5.2 (GND), U6.2 (GND), U7.3, U7.8, U8.2 (GND), U9.6 (GND)
IREF1: R1.1, U1.20 (IREF)
IREF2: R2.1, U2.20 (IREF)
IREF3: R3.1, U3.20 (IREF)
IREF4: R4.1, U4.20 (IREF)
LAT: J6.1, U1.1 (LAT), U2.1 (LAT), U3.1 (LAT), U4.1 (LAT)
SCLK: J5.1, U1.24 (SCLK), U2.24 (SCLK), U3.24 (SCLK), U4.24 (SCLK)
SERIAL_1_2: U1.19 (SOUT), U2.23 (SIN)
SERIAL_2_3: U2.19 (SOUT), U3.23 (SIN)
SERIAL_3_4: U3.19 (SOUT), U4.23 (SIN)
SIN: J4.1, U1.23 (SIN)
SW_3V3: C1.1, C2.1, C3.1, C4.1, C7.1, R15.2, U1.21 (VCC), U2.21 (VCC), U3.21 (VCC), U4.21 (VCC), U5.5 (QOD), U5.6 (VOUT)
USB_DM: J17.1, U7.1, U7.10, U9.8 (DM_CON)
USB_DM_HOST: J11.1, U9.2 (DM_HOST)
USB_DP: J18.1, U7.2, U7.9, U9.7 (DP_CON)
USB_DP_HOST: J12.1, U9.3 (DP_HOST)
VBUS: D1.1, F1.1, J13.1
VLED_5V: C8.1, Q1.2 (S), Q2.2 (S), Q3.2 (S), Q4.2 (S), Q5.2 (S), R5.2, R6.2, R7.2, R8.2, R9.2, U6.5 (QOD), U6.6 (VOUT)

Notes on the sheet:
BANK1 / DS1 + DS2
BANK2 / DS3 + DS4
BANK3 / DS5 + DS6
BANK4 / DS7 and gate sinks / USB INPUT SOFT START
COLUMN1..3 / gate pullups and anode discharge
COLUMN4..5 / gate pullups and anode discharge
RAIL SWITCHES / common EN / quick discharge
USB / CC current sensing and ESD
BC1.2 / automatic USB switch / GOOD_BAT uses always3V3
MCU WIRES J1..J10 / external XIAO RP2040 Plus
MCU DATA / BC STATUS + USB BREAKOUT WIRES / do not power both USB sockets
Named labels connect matching nodes. Every package pin is explicit; crosses mark intentional no-connects. Owner-supplied LEDs and wire pads are excluded from factory assembly.
TLC59283RGER + IREF=7.15k: 7.40006mA nominal. U4 OUT7..11 sink PMOS gates, exactly one selected column. BLANK HIGH disables sinks and enables precharge.
400Hz frame / 5x500us phases / >=30us BLANK before next phase / <=470us full on. LAT LOW while shifting, pulse HIGH then LOW while blanked.
USB-C 5V only, no PD. Adafruit4090 supplies separate5.1k Rd resistors; no duplicate Rd on this board. CC divider loading checked against tolerance.
Both TPS22918 switches default OFF. BLANK pullup uses SW_3V3. Park serial controls LOW and BLANK high-Z before disabling rails to prevent backfeed.
TPD4E05U06 opposite NC pads are joined by external copper to corresponding DC nets. Do not treat the IC as internally flow-through.
BQ24392 isolates raw USB_DP/DM from USB_DP_HOST/DM_HOST. GOOD_BAT always3V3; BC full grant requires DET HIGH and AL_N LOW; host suspend always overrides.
One owned LED diode-verified; check other20. Full case print pending. Precharge/rail transients/current/inrush/suspend, 30us settling and temperature need bench tests. In2: CT_5V<=12mm only; In4: pure GND.

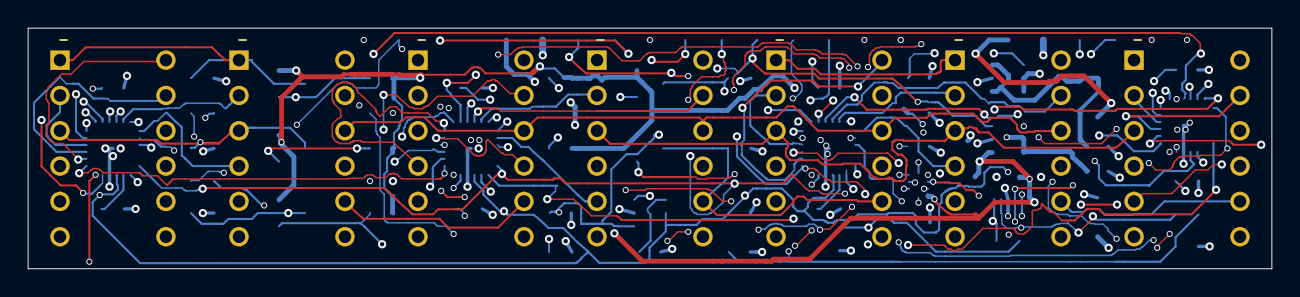
[picture p98: board house-rules-main-B2.kicad_pcb from above]

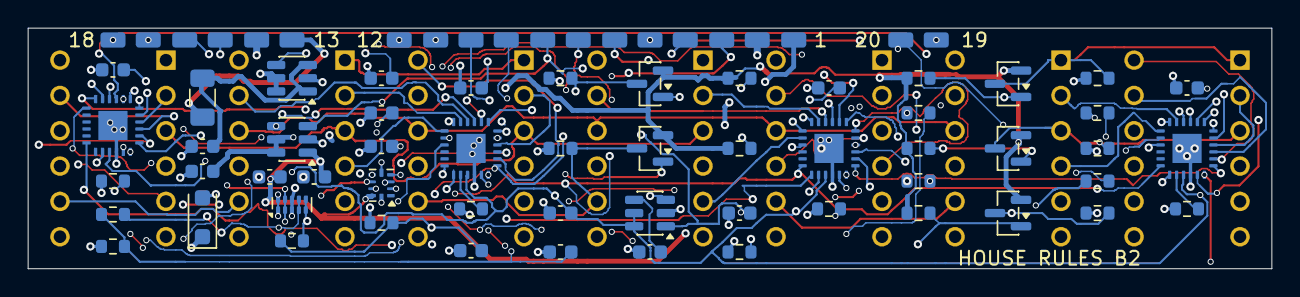
[picture p99: board house-rules-main-B2.kicad_pcb from below]

Board: 6 copper layers, 89.4 x 17.3 mm, 82 parts (75 on the bottom side), 92 nets.
