hmcneill46/house-rules-led-recreation/hardware/kicad/house-rules-usb.kicad_pcb

## KiCad design hardware/kicad/house-rules-usb.kicad_pcb (2026-10-29)

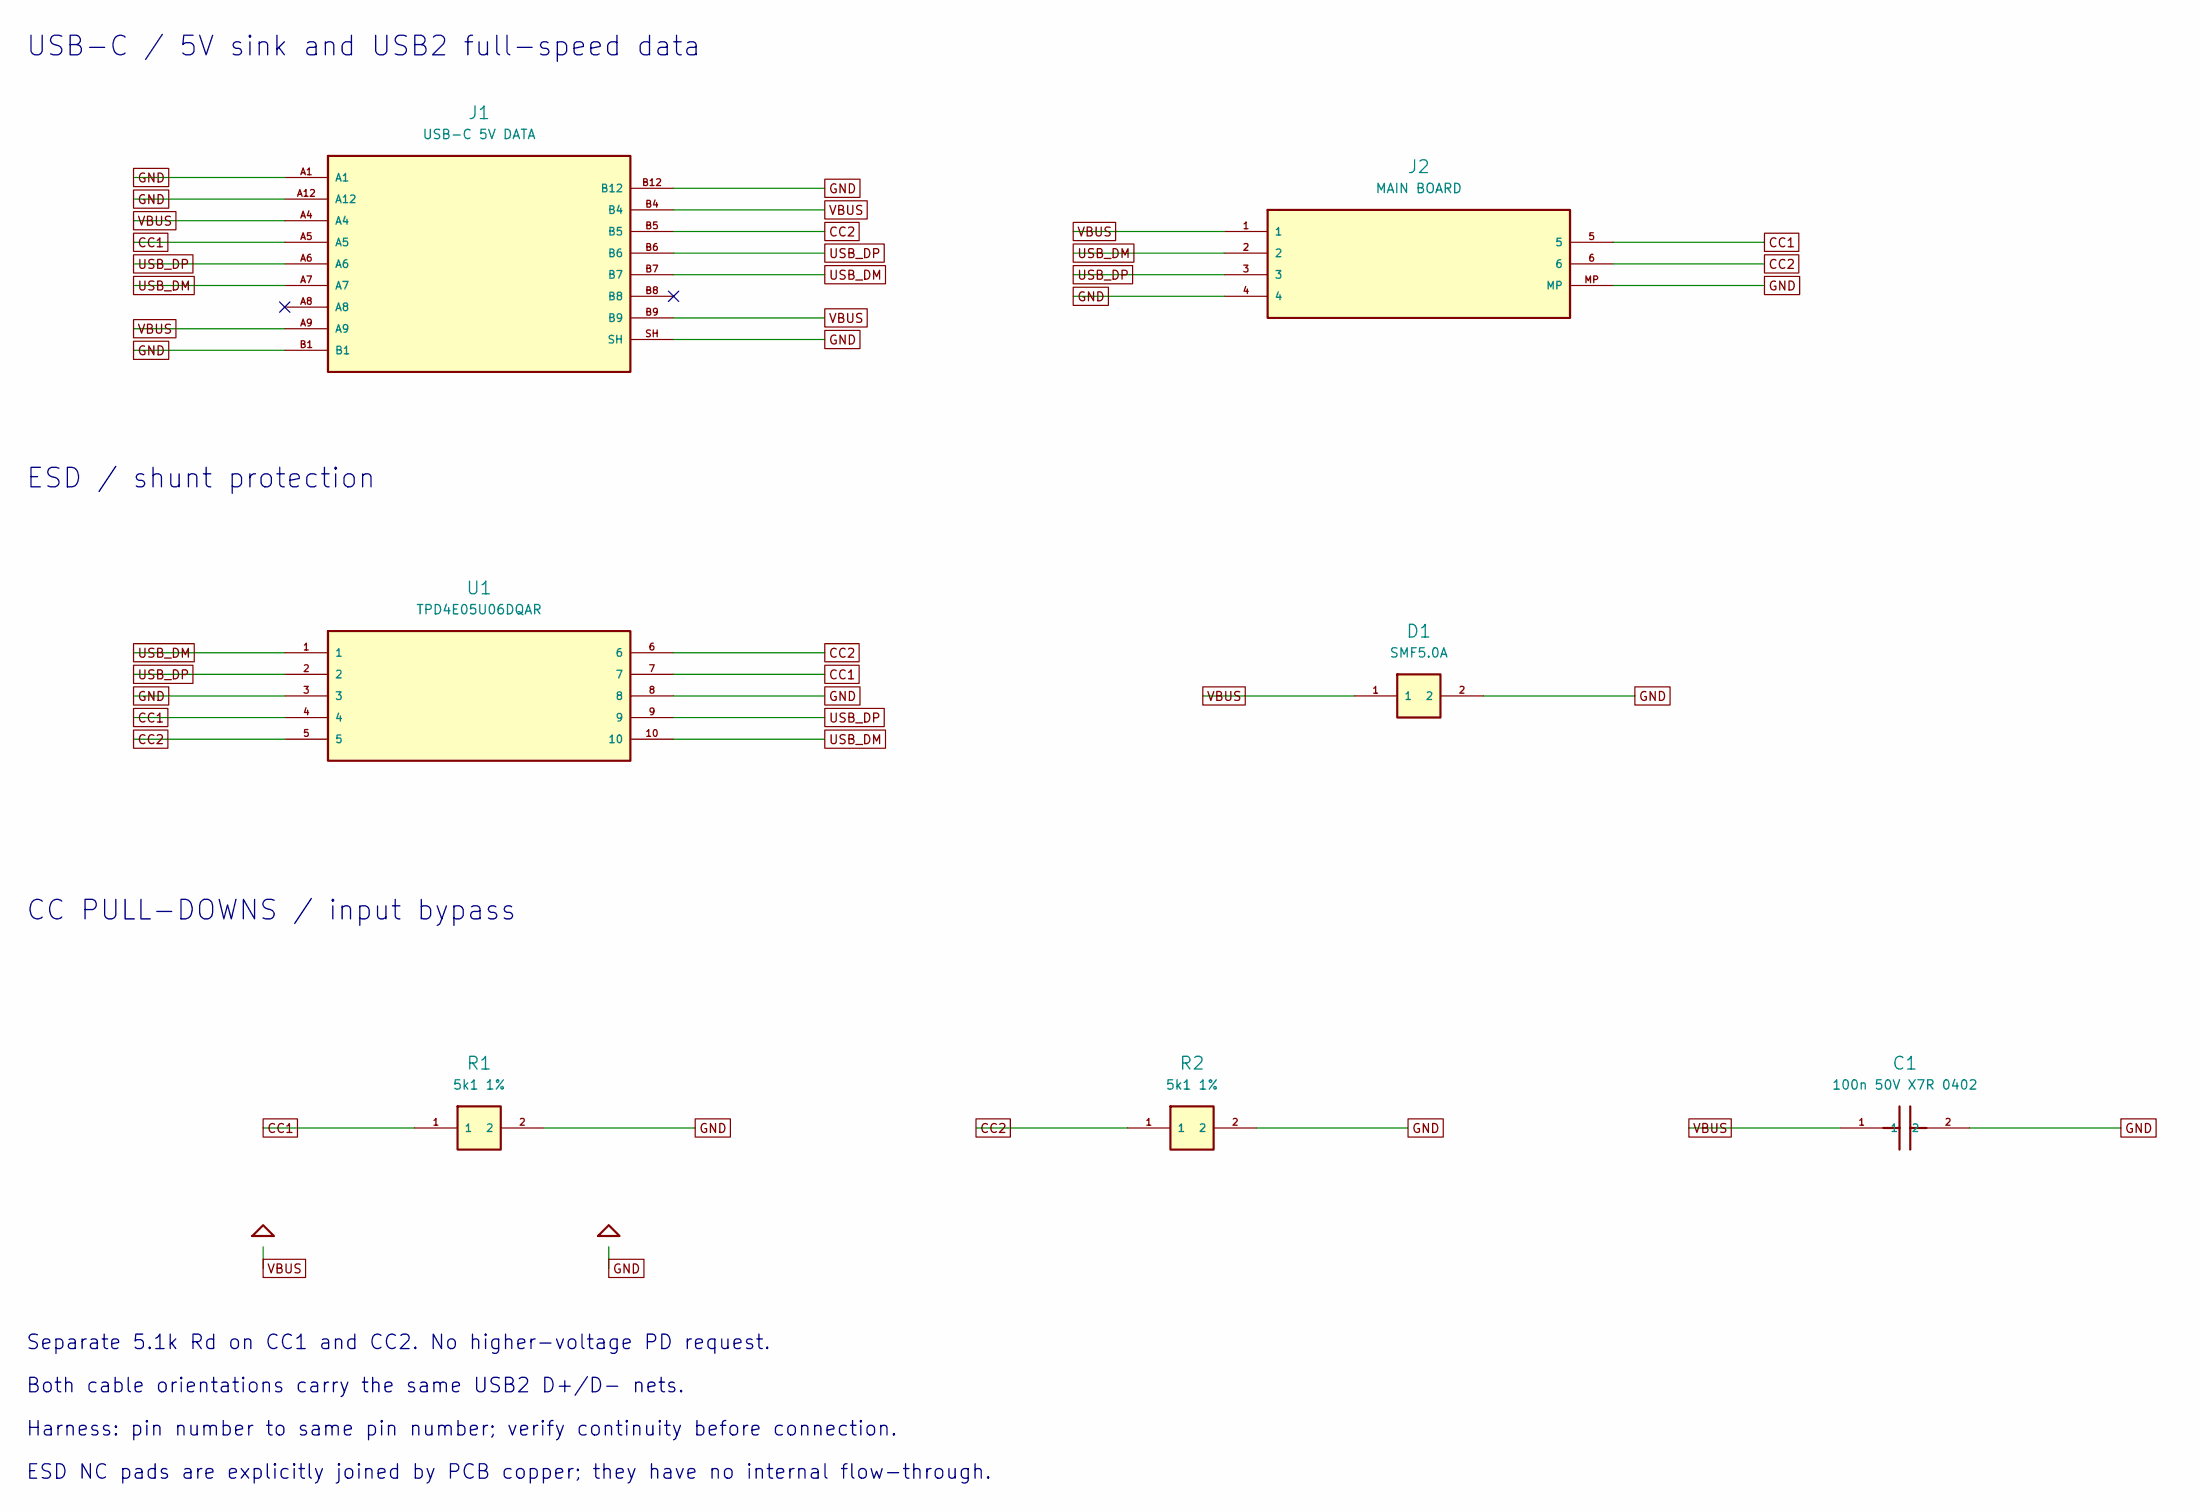
[picture p100: schematic house-rules-usb.kicad_sch, House Rules / usb PCB]

Parts:
C1: 100n 50V X7R 0402; C_0402_1005Metric; MPN CL05B104KB54PNC; LCSC C307331
D1: SMF5.0A; D_SOD-123F; MPN SMF5.0A; LCSC C151296
J1: USB-C 5V DATA; USB_C_Receptacle_GCT_USB4105-xx-A_16P_TopMnt_Horizontal; MPN USB4105-GF-A; LCSC C3020560
J2: MAIN BOARD; JST_SH_SM06B-SRSS-TB_1x06-1MP_P1.00mm_Horizontal; MPN SM06B-SRSS-TB(LF)(SN); LCSC C160405
R1, R2: 5k1 1%; R_0603_1608Metric; MPN 0603WAF5101T5E; LCSC C23186
U1: TPD4E05U06DQAR; USON-10_2.5x1.0mm_P0.5mm; MPN TPD4E05U06DQAR; LCSC C138714

Connections:
CC1: J1.A5, J2.5, R1.1, U1.4, U1.7
CC2: J1.B5, J2.6, R2.1, U1.5, U1.6
GND: C1.2, D1.2, J1.A1, J1.A12, J1.B1, J1.B12, J1.SH, J2.4, J2.MP, R1.2, R2.2, U1.3, U1.8
USB_DM: J1.A7, J1.B7, J2.2, U1.1, U1.10
USB_DP: J1.A6, J1.B6, J2.3, U1.2, U1.9
VBUS: C1.1, D1.1, J1.A4, J1.A9, J1.B4, J1.B9, J2.1

Notes on the sheet:
USB-C / 5V sink and USB2 full-speed data
ESD / shunt protection
CC PULL-DOWNS / input bypass
Separate 5.1k Rd on CC1 and CC2. No higher-voltage PD request.
Both cable orientations carry the same USB2 D+/D- nets.
Harness: pin number to same pin number; verify continuity before connection.
ESD NC pads are explicitly joined by PCB copper; they have no internal flow-through.

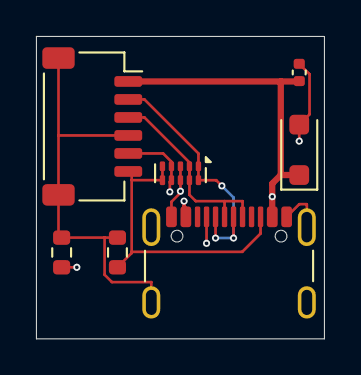
[picture p101: board house-rules-usb.kicad_pcb from above]

Board: 4 copper layers, 16.0 x 16.8 mm, 7 parts (0 on the bottom side), 6 nets.
