hmcneill46/house-rules-led-recreation/hardware/kicad/house-rules-main.kicad_pcb

## KiCad design hardware/kicad/house-rules-main.kicad_pcb (2026-10-29)

Schematic: house-rules-main.kicad_sch, House Rules / main PCB

Parts:
C1, C3, C5, C7, C11, C12: 100n 50V X7R; C_0603_1608Metric; MPN CC0603KRX7R9BB104; LCSC C14663
C2, C4, C6, C8, C9, C13: 1u 16V X7R; C_0603_1608Metric; MPN 0603B105K160CT; LCSC C108463
C10: 2u2 10V X7R; C_0603_1608Metric; MPN 0603ZC225KAT2A; LCSC C2179699
DS1, DS2, DS3, DS4, DS5, DS6, DS7: LMD07057AUE-101B; MPN LMD07057AUE-101B
F1: 750mA PPTC; Fuse_1206_3216Metric; MPN SMD1206B075TF/16; LCSC C269118
J1: USB CARRIER; JST_SH_BM06B-SRSS-TB_1x06-1MP_P1.00mm_Vertical; MPN BM06B-SRSS-TB(LF)(SN); LCSC C160392
R1, R2, R3, R4, R10, R11, R12, R13: 47k 1%; R_0603_1608Metric; MPN 0603WAF4702T5E; LCSC C25819
R5, R6, R14: 2k2 1%; R_0603_1608Metric; MPN 0603WAF2201T5E; LCSC C4190
R7: 100k 1%; R_0603_1608Metric; MPN 0603WAF1003T5E; LCSC C25803
R8, R9: 10k 1%; R_0603_1608Metric; MPN 0603WAF1002T5E; LCSC C25804
SW1: BOOT; SW_SPST_EVQP7A; MPN EVQP7A01P; LCSC C79167
SW2: RESET; SW_SPST_EVQP7A; MPN EVQP7A01P; LCSC C79167
TP1: GND; TestPoint_Pad_D1.0mm; MPN GND
TP2: 3V3; TestPoint_Pad_D1.0mm; MPN 3V3
TP3: SWDIO; TestPoint_Pad_D1.0mm; MPN SWDIO
TP4: SWCLK; TestPoint_Pad_D1.0mm; MPN SWCLK
TP5: NRST; TestPoint_Pad_D1.0mm; MPN NRST
TP6: 5V; TestPoint_Pad_D1.0mm; MPN 5V
U1, U2, U3, U4: IS31FL3729-QFLS4-TR; QFN-32-1EP_4x4mm_P0.4mm_EP2.65x2.65mm; MPN IS31FL3729-QFLS4-TR; LCSC C2940549
U5: STM32G0B1KBU6; QFN-32-1EP_5x5mm_P0.5mm_EP3.45x3.45mm; MPN STM32G0B1KBU6; LCSC C5159549
U6: TLV75533PDBVR; SOT-23-5; MPN TLV75533PDBVR; LCSC C404027

Connections:
+3V3: C10.1, C11.1, R5.1, R6.1, R8.2, SW1.2, TP2.1, U5.4 (VDD_VDDA), U6.5 (OUT)
+5V: C1.1, C2.1, C3.1, C4.1, C5.1, C6.1, C7.1, C8.1, C9.1, C13.1, F1.2, TP6.1, U1.23 (VCC), U2.23 (VCC), U3.23 (VCC), U4.23 (VCC), U4.28 (AD), U6.1 (IN), U6.3 (EN)
BOOT_BUTTON: R14.1, SW1.1
BOOT_SWCLK: R9.1, R14.2, TP4.1, U5.25 (PA14_BOOT0_SWCLK)
CC1: J1.5, R10.1
CC1_ADC: R10.2, R11.1, U5.7 (PA0_ADC_CC1)
CC2: J1.6, R12.1
CC2_ADC: R12.2, R13.1, U5.8 (PA1_ADC_CC2)
D1_CS1: DS1.12 (ROW1_K), U1.30 (CS1)
D1_CS2: DS1.11 (ROW2_K), U1.31 (CS2)
D1_CS3: DS1.2 (ROW3_K), U1.32 (CS3)
D1_CS4: DS1.9 (ROW4_K), U1.1 (CS4)
D1_CS5: DS1.4 (ROW5_K), U1.2 (CS5)
D1_CS6: DS1.5 (ROW6_K), U1.3 (CS6)
D1_CS7: DS1.6 (ROW7_K), U1.4 (CS7)
D1_CS8: DS2.12 (ROW1_K), U1.5 (CS8)
D1_CS9: DS2.11 (ROW2_K), U1.6 (CS9)
D1_CS10: DS2.2 (ROW3_K), U1.7 (CS10)
D1_CS11: DS2.9 (ROW4_K), U1.8 (CS11)
D1_CS12: DS2.4 (ROW5_K), U1.10 (CS12)
D1_CS13: DS2.5 (ROW6_K), U1.11 (CS13)
D1_CS14: DS2.6 (ROW7_K), U1.12 (CS14)
D1_SW1: DS1.1 (COL1_A), DS2.1 (COL1_A), U1.22 (SW1)
D1_SW2: DS1.3 (COL2_A), DS2.3 (COL2_A), U1.21 (SW2)
D1_SW3: DS1.10 (COL3_A), DS2.10 (COL3_A), U1.20 (SW3)
D1_SW4: DS1.7 (COL4_A), DS2.7 (COL4_A), U1.19 (SW4)
D1_SW5: DS1.8 (COL5_A), DS2.8 (COL5_A), U1.18 (SW5)
D2_CS1: DS3.12 (ROW1_K), U2.30 (CS1)
D2_CS2: DS3.11 (ROW2_K), U2.31 (CS2)
D2_CS3: DS3.2 (ROW3_K), U2.32 (CS3)
D2_CS4: DS3.9 (ROW4_K), U2.1 (CS4)
D2_CS5: DS3.4 (ROW5_K), U2.2 (CS5)
D2_CS6: DS3.5 (ROW6_K), U2.3 (CS6)
D2_CS7: DS3.6 (ROW7_K), U2.4 (CS7)
D2_CS8: DS4.12 (ROW1_K), U2.5 (CS8)
D2_CS9: DS4.11 (ROW2_K), U2.6 (CS9)
D2_CS10: DS4.2 (ROW3_K), U2.7 (CS10)
D2_CS11: DS4.9 (ROW4_K), U2.8 (CS11)
D2_CS12: DS4.4 (ROW5_K), U2.10 (CS12)
D2_CS13: DS4.5 (ROW6_K), U2.11 (CS13)
D2_CS14: DS4.6 (ROW7_K), U2.12 (CS14)
D2_SW1: DS3.1 (COL1_A), DS4.1 (COL1_A), U2.22 (SW1)
D2_SW2: DS3.3 (COL2_A), DS4.3 (COL2_A), U2.21 (SW2)
D2_SW3: DS3.10 (COL3_A), DS4.10 (COL3_A), U2.20 (SW3)
D2_SW4: DS3.7 (COL4_A), DS4.7 (COL4_A), U2.19 (SW4)
D2_SW5: DS3.8 (COL5_A), DS4.8 (COL5_A), U2.18 (SW5)
D3_CS1: DS5.12 (ROW1_K), U3.30 (CS1)
D3_CS2: DS5.11 (ROW2_K), U3.31 (CS2)
D3_CS3: DS5.2 (ROW3_K), U3.32 (CS3)
D3_CS4: DS5.9 (ROW4_K), U3.1 (CS4)
D3_CS5: DS5.4 (ROW5_K), U3.2 (CS5)
D3_CS6: DS5.5 (ROW6_K), U3.3 (CS6)
D3_CS7: DS5.6 (ROW7_K), U3.4 (CS7)
D3_CS8: DS6.12 (ROW1_K), U3.5 (CS8)
D3_CS9: DS6.11 (ROW2_K), U3.6 (CS9)
D3_CS10: DS6.2 (ROW3_K), U3.7 (CS10)
D3_CS11: DS6.9 (ROW4_K), U3.8 (CS11)
D3_CS12: DS6.4 (ROW5_K), U3.10 (CS12)
D3_CS13: DS6.5 (ROW6_K), U3.11 (CS13)
D3_CS14: DS6.6 (ROW7_K), U3.12 (CS14)
D3_SW1: DS5.1 (COL1_A), DS6.1 (COL1_A), U3.22 (SW1)
D3_SW2: DS5.3 (COL2_A), DS6.3 (COL2_A), U3.21 (SW2)
D3_SW3: DS5.10 (COL3_A), DS6.10 (COL3_A), U3.20 (SW3)
D3_SW4: DS5.7 (COL4_A), DS6.7 (COL4_A), U3.19 (SW4)
D3_SW5: DS5.8 (COL5_A), DS6.8 (COL5_A), U3.18 (SW5)
D4_CS1: DS7.12 (ROW1_K), U4.30 (CS1)
D4_CS2: DS7.11 (ROW2_K), U4.31 (CS2)
D4_CS3: DS7.2 (ROW3_K), U4.32 (CS3)
D4_CS4: DS7.9 (ROW4_K), U4.1 (CS4)
D4_CS5: DS7.4 (ROW5_K), U4.2 (CS5)
D4_CS6: DS7.5 (ROW6_K), U4.3 (CS6)
D4_CS7: DS7.6 (ROW7_K), U4.4 (CS7)
D4_SW1: DS7.1 (COL1_A), U4.22 (SW1)
D4_SW2: DS7.3 (COL2_A), U4.21 (SW2)
D4_SW3: DS7.10 (COL3_A), U4.20 (SW3)
D4_SW4: DS7.7 (COL4_A), U4.19 (SW4)
D4_SW5: DS7.8 (COL5_A), U4.18 (SW5)
GND: C1.2, C2.2, C3.2, C4.2, C5.2, C6.2, C7.2, C8.2, C9.2, C10.2, C11.2, C12.2, C13.2, J1.4, J1.MP, R1.2, R2.2, R3.2, R4.2, R7.2, R9.2, R11.2, R13.2, SW2.2, TP1.1, U1.9 (GND), U1.24 (GND), U1.28 (AD), U1.33 (EP_GND), U2.9 (GND), U2.24 (GND), U2.33 (EP_GND), U3.9 (GND), U3.24 (GND), U3.33 (EP_GND), U4.9 (GND), U4.24 (GND), U4.33 (EP_GND), U5.5 (VSS_VSSA), U5.33 (EP_GND), U6.2 (GND)
ISET1: R1.1, U1.25 (ISET)
ISET2: R2.1, U2.25 (ISET)
ISET3: R3.1, U3.25 (ISET)
ISET4: R4.1, U4.25 (ISET)
LED_SDB: R7.1, U1.29 (SDB), U2.29 (SDB), U3.29 (SDB), U4.29 (SDB), U5.15 (PB0_LED_SDB)
NRST: C12.1, R8.1, SW2.1, TP5.1, U5.6 (PF2_NRST)
SCL: R5.2, U1.27 (SCL), U2.27 (SCL), U2.28 (AD), U3.27 (SCL), U4.27 (SCL), U5.30 (PB6_I2C1_SCL)
SDA: R6.2, U1.26 (SDA), U2.26 (SDA), U3.26 (SDA), U3.28 (AD), U4.26 (SDA), U5.31 (PB7_I2C1_SDA)
SWDIO: TP3.1, U5.24 (PA13_SWDIO)
USB_DM: J1.2, U5.22 (PA11_USB_DM)
USB_DP: J1.3, U5.23 (PA12_USB_DP)
VBUS: F1.1, J1.1

Notes on the sheet:
BANK 1 / modules 1 + 2 / address 0x34
BANK 2 / modules 3 + 4 / address 0x35
BANK 3 / modules 5 + 6 / address 0x36
BANK 4 / module 7 / address 0x37
CONTROLLER / USB, artwork and recovery
POWER / protected input and 3V3 regulator
BUS PULL-UPS / shutdown default / CC current-advertisement sensing
SWD RECOVERY / test contacts
Named nets connect all matching labels on this sheet. Every physical package pin is shown; crosses mark intentional no-connects.
47k ISET limits LED pulse current. LED_SDB defaults low. Firmware must authorise USB current before bright playback. USB data and recovery share the carrier harness.

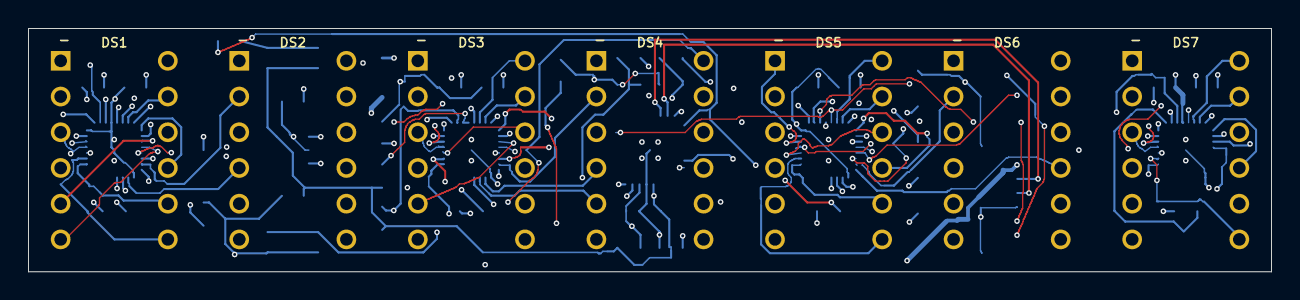
[picture p102: board house-rules-main.kicad_pcb from above]

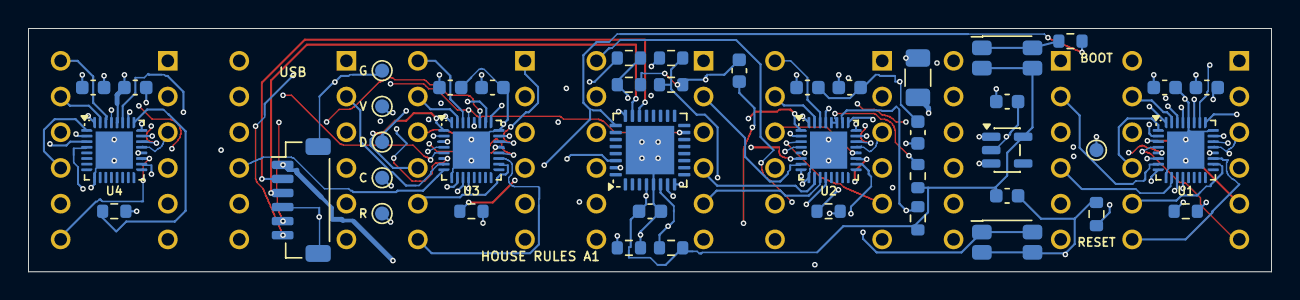
[picture p103: board house-rules-main.kicad_pcb from below]

Board: 6 copper layers, 88.4 x 17.3 mm, 50 parts (43 on the bottom side), 90 nets.
