hmcneill46/house-rules-led-recreation/(commit log)

2026-10-29 Add lower-cost B2 hardware, routed PCB, firmware and review package
2026-10-29 Record final routed-board UK quote and conservative delivered budget
2026-10-29 Add verified B2 case and fit-test G-code for KE Hyper PLA
2026-10-30 Add labelled seven-module pitch trials and hold B2 ordering for fit review
2026-10-30 Add labelled 12.825 12.850 and 12.875 mm fitting trials with KE G-code
2026-10-31 Match B2 PCB and case to confirmed 12.875 mm module pitch
2026-10-31 Combine confirmed-F case and fit objects on one KE print plate
2026-10-31 Record confirmed-F purchase budgets and driver sourcing blocker
2026-10-31 Compare stocked LED drivers and unchanged-board manufacturers
2026-10-31 Adopt TLC59283 drivers and verify the three-display hardware revision
