hmcneill46/house-rules-led-recreation/(notices)

Notices in the files:
hardware/kicad/3d/Button_Switch_SMD__SW_SPST_EVQP7A.step:
Copyright (C) 2025, KiCAD
This work is licensed under the
[Creative Commons CC-BY-SA 4.0 License](https://creativecommons.org/licenses/by-sa/4.0/legalcode),
with the following exception:
project files under this or any other license agreement. However, if you wish to distribute
